litvinoval/cursach/РПЗ.docx

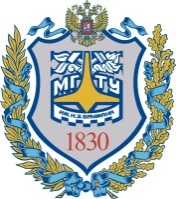
[picture p1: figure]
Gerb-BMSTU_01

| Министерство науки и высшего образования Российской Федерации Федеральное государственное бюджетное образовательное учреждение высшего образования «Московский государственный технический университет имени Н.Э. Баумана (национальный исследовательский университет)» (МГТУ им. Н.Э. Баумана)

ФАКУЛЬТЕТ ____________________________ ИУ ____________________________________

КАФЕДРА _______________________________ ИУ-2__________________________________

РАСЧЕТНО-ПОЯСНИТЕЛЬНАЯ ЗАПИСКА

К КУРСОВОМУ ПРОЕКТУ

НА ТЕМУ:

______________________________________________

______Двухосный индикаторный гиростабилизатор__ _______телекамеры для разведывательного БПЛА___

______________________________________________

______________________________________________

______________________________________________

Студент ____ИУ2-71___ _______________ Литвинов А.Д.___

(Группа) (Подпись, дата) (И.О.Фамилия)

Руководитель курсового проекта _________________ Фатеев В.В._

(Подпись, дата) (И.О.Фамилия)

Консультант _________________ Фатеев В.В. _

(Подпись, дата) (И.О.Фамилия)

2022 г.

# Введение

Гироскопическими стабилизаторами (ГС) называются гироскопические устройства, предназначенные для стабилизации приборов и устройств в инерциальном пространстве и управления их угловым положением. На гироскопические приборы и системы возлагаются сложные задачи по стабилизации и управлению специальными бортовыми приборами (приборы инерциальной навигации, антенны бортовых радиолокационных станций, чувствительные элементы пеленгаторов, координаторы цели, аэрофотоаппараты и др.).

Известно, что ось гироскопа в кардановом подвесе, установленного на борту летательного аппарата, в течение длительного времени сохраняет почти неизменное направление в пространстве. Однако несовершенство элементов конструкции и тяжелые условия эксплуатации порождают значительные моменты внешних сил, действующие на гироскоп и отклоняющие ось вращения его ротора, а следовательно и стабилизируемую ось от заданного направления в пространстве.

Требования высокой точности стабилизации приборов бортовых систем привели к необходимости создания гироскопических стабилизаторов.

## Классификация гиростабилизаторов

1. По типу применяемых гироскопов:

Гиростабилизаторы разделяются на ГС с двухстепенными гироскопами и ГС с трехстепенными гироскопами.

В свою очередь, ГС с двухстепенными гироскопами можно разделить по типу подвеса гироскопов: ГС с гироскопами на шарикоподшипниковом подвесе, на поплавковом, воздушном, магнитном подвесах и т.п. Гиростабилизаторы с трехстепенными гироскопами делятся на ГС с бескарданными гироскопами и ГС на базе гироскопов с кардановым подвесом.

2. По роли гироскопа в процессе стабилизации:

1) Силовые ГС. В этом типе ГС возмущающие моменты уравновешиваются гироскопическим моментом и моментом, создаваемым приводом разгрузки. Постоянные или медленно изменяющиеся моменты уравновешиваются в основном моментом привода разгрузки, быстро изменяющиеся, уравновешиваются гироскопическим моментом. Для силовых ГС требуются гироскопы с высоким кинетическим моментом.

2) Индикаторно-силовые ГС. В таких ГС силовая роль гироскопов снижена. Наличие у гироскопа большого кинетического момента не является обязательным.

3) Индикаторные ГС. Гироскопический момент практически не участвует в непосредственной компенсации возмущающих моментов, и их подавление определяется в основном приводом стабилизации, который должен выбираться из условия уравновешивания всех составляющих возмущающего момента.

3. По типу чувствительного элемента:

1) ГС на двухосных гироскопах.

2) ГС на трехосных гироскопах.

3) ГС на датчиках угловых скоростей.

4) ГС на датчиках угловых ускорений.

4. По количеству осей стабилизации:

1) Одноосные ГС. – стабилизируют приборы и устройства только относительно одной оси.

2) Двухосные ГС. – стабилизируют приборы и устройства относительно двух осей ( например, ГС, создающий горизонтальную площадку)

3) Трехосные ГС. – осуществляют стабилизацию относительно трех осей, т.е. полную стабилизацию. Такие ГС называются еще пространственными гиростабилизаторами или гиростабилизированными платформами.

5. По типу подвеса:

1) Корданов подвес

2) Плавающий подвес

3) На космических аппаратах роль подвеса может выполнять сам аппарат

6. По типу привода:

1) Электромеханические.

2) Пневматические.

3) Гидравлические.

4)Реактивные

## Назначение прибора

Разрабатываемый прибор предназначается для угловой стабилизации в инерциальном пространстве положения камеры беспилотного летательного аппарата (БПЛА), управления еѐ положением с помощью сигналов, получаемых с джойстика оператора, а также измерения углов отклонения и угловой скорости платформы. При этом должны быть обеспечены следующие параметры прибора:

установившаяся ошибка стабилизации не более 0,5 угловых минут

максимальная скорость управления – 10 °/с

максимальное угловое ускорение управления – 220 °/с^2

максимальный угол прокачки – 40 °

## Принцип работы

ГС состоит из платформы, с закрепленными на ней камерой и двумя ВОГ, которые помещены в двухосный наружный карданов подвес, а также системы стабилизации, устройства вывода информации потребителям и устройства управления положением объекта стабилизации. Принцип действия индикаторного стабилизатора на ВОГ основан на компенсации возмущающих моментов действующих на объект стабилизации (ОС) с помощью приводов стабилизации, моменты, которые они развивают компенсирует возмущающие. При повороте ОС на ,установленных на нѐм, ВОГ вырабатывается сигнал пропорциональный угловой скорости движения ОС. Этот сигнал после интегрирования и усиления подается на приводы стабилизации, которые вырабатывают момент, направленный в противоположную сторону поворота ОС. Управление положением ОС в инерциальном пространстве осуществляется сигналами с джойстика оператора, которые вычитаются из сигналов с ВОГ и также подаются на привод стабилизации. Сигналы с джойстика оператора пропорциональны отклонению джойстика.

## Вводимые обозначения

Датчик угла – ДУ

Датчик момента – ДМ

Волоконно-оптический гироскоп – ВОГ (ВГ)

Летательный аппарат – ЛА

# Описание конструкции ГС, ЧЭ, узлов

## Описание конструкции ГС

Конструкция двухосного индикаторного гиростабилизатора камеры БПЛА представляет собой закрепленную на полуосях камеру, выполняющую роль платформы, к которой крепятся чувствительные элементы. Полуоси закрепляются в шарикоподшипниковых опорах в рамке. Также на полуоси и рамку устанавливаются датчики момента для выработки момента стабилизации и датчики угла для выработки выходных сигналов об угловом положении камеры. Аналогично рама устанавливается на полуосях в шарикоподшипниковые опоры в корпусе.

## Узел ДМ

Датчики момента ДМ3, ДМ10 состоят из двух механически раздельных частей – статора и ротора. Статор представляет собой магнитопровод с установленными в нѐм постоянными магнитами и установленным сверху коллекторно-щеточным узлом. Статор, крепится винтами к корпусу. Также винтами крепится к статору коллекторнощеточный узел. Ротор ДМ представляет собой магнитопровод с обмоткой, на которую через щетки подается управляющий ток. Ротор устанавливается на полуось и поджимается гайкой.

## Узел ДУ

В качестве датчиков угла выбираются синусно-косинусные трансформаторы СКТ265 бескорпусного типа, которые представляют собой две раздельный механические части – ротор и статор. Ротор поджимается гайкой к полуоси, а статор к корпусу.

## Описание чувствительного элемента – ВГ091

ВГ091 является датчиком абсолютной угловой скорости. Принцип действия ВОГ основан на зависимости времени облета света замкнутого вращающегося контура от направления обхода (эффект Саньяка).

Кольцевой интерферометр конструктивно выполнен таким образом, что излучение от одного источника делится на две волны равной интенсивности I, которые распространяются в контуре в противоположных направлениях и интерферируют после его обхода. Сигнал интерференции в этом случае есть I(1+cos(F)), где F – разность фазовых набегов (сдвиг фаз) волн в контуре. При вращении создается сдвиг фаз (фаза Саньяка) между встречными волнами F=2πDLW/λc (D – диаметр катушки, L – длина волокна, W – скорость вращения вокруг нормали к плоскости контура (оси чувствительности).

Коэффициент пропорциональности между угловой скоростью и фазой Саньяка называется оптическим масштабным коэффициентом контура (К). Величина К определяет диапазон измеряемых угловых скоростей, который составляет 300 град/с

Минимальная измеряемая угловая скорость зависит от качества оптических компонентов (модуль, ответвитель, поляризатор). Ее отношение к максимальной измеряемой скорости представляет динамический диапазон ВОГ. Качество оптики проявляется в максимальном подавлении всех механизмов возникновения сдвига фаз в интерферометре, кроме как вследствие вращения. Оптическая архитектура ВГ091 обеспечивает оптимальную оптическую фильтрацию сигнала для уменьшения дрейфа и повышения помехоустойчивости. Для этого излучение проходит поляризационный фильтр и на ответвителе разделяется на два встречных луча волоконного контура. После обхода контура лучи смешиваются(интерферируют) на том же ответвителе и опять проходят поляризационный фильтр, обеспечивающий идентичность(взаимность) оптических путей встречных волн в контуре. Вторым ответвителем сигнал интерференции отводится на фотоприемное устройство, сигнал которого пропорционален мощности светового потока. Для повышения чувствительности используется пьезокерамический фазовый модулятор(ПЭТ). При питании его переменным напряжением создается дополнительный сдвиг фаз m(T)=M*sin(wt) за счет периодического растяжения участка волоконного контура.

При работе модулятора выходной сигнал может быть выражен в виде:

I(t,Ф,M)≈1+cos(Ф+Msin(wt))≈

≈J_1 (M)sin(Ф)sin(wt)+J_2 (M)sin(Ф)sin(2wt)+1+

+J_0 (M)cos(Ф)+QBcos(wt)

Где представлены основные составляющие сигнала ВОГ (Jn – функция Бесселя порядка n). Это – первая гармоника частоты модуляции, вторая гармоника, постоянная составляющая и сигнал квадратурной помехи (QB). Они зависят от амплитуды модуляции (М) и угловой скорости. Квадратурный сигнал (QB) также проявляется на частоте модуляции, однако он не зависит от вращения и сдвинут по фазе на 90˚ относительно сигнала вращения.

При вращении датчика появляется сигнал на первой гармонике, пропорциональный скорости вращения. Его величина зависит также от тока СЛД и напряжения ПЭТ. Выходное напряжение в диапазоне измеряемых скоростей (-Wmax...+Wmax) аппроксимируется соотношением:

U(W,t°)=SF∙W∙[1+s(t°)]∙[1-p∙(W/(W_(max)))^2 ]+B(t°)+N

SF – крутизна системы (коэффициент между скоростью и напряжением), B(t˚) – начальный сдвиг (зависит от температуры); N – случайная составляющая сигнала; s(t˚) – температурная составляющая крутизны; p – параметр нелинейности.

SF является произведением ОМК и коэффициента преобразования электронного блока (≈ 15 В/мрад). Нелинейность преобразования нарастает квадратично на границах диапазона измерений примерно до 10-15%. Она корректируется квадратичной аппроксимацией до уровня 0.3..1%. При малых скоростях вращения нелинейность пренебрежимо мала.

Волоконно-оптический контур изготовлен из одномодового оптического волокна, сохраняющего поляризацию излучения, и имеющего следующие технические характеристики: длина поляризационных биений 5 мм; диаметр кварцевой оболочки – 45 мм; диаметр волокна в полимерном покрытии – 150 мкм; длина волокна – 100 мм; диаметр намотки – 70 мм. Внешние по отношению к жиле слои волокна выполняются из легированного кварца для придания ему определенных оптических и механических свойств. Длина и диаметр намотки определяют ОМК датчика.

Фазовый модулятор (ПЭТ) представляет собой участок волоконного контура, намотанный на пьезокерамический (ЦТС-23) цилиндр диаметром 18 мм. Рабочая частота модуляции (резонансная) 73.,.83кГц, добротность не менее 150. Статическая емкость примерно 220пФ. Характеристики модулятора зависят от температуры. Так, активное сопротивление падает с температурой, а коэффициент преобразования (соотношение между индексом фазовой модуляции и напряжением ПЗТ) соответственно возрастает. ПЗТ является электромеханической колебательной системой. Кроме основного (радиального) типа колебаний в нем существуют и другие типы колебаний, резонансные частоты которых выше 350кГц.

Волоконный биконический ответвитель 2x2 является устройством, осуществляющим оптическую связь между волокнами. Он изготовлен таким образом, что излучение, распространяющееся в одном из волокон, равномерно и практически без потерь (менее О.ЗдБ) распределяется между двумя волокнами. Ответвители изготавливаются по сварной технологии непосредственно на концах контура, после чего распаиваются на кварцевых подложках для обеспечения вибро и термоустойчивости.

Волоконно-кристаллический поляризатор выполнен в виде биконического перехода (утончения) на участке волокна, заращенного анизотропным монокристаллом. Коэффициент экстинкции поляризатора (разность потерь волн с ортогональными поляризациями) более 30 дБ.

Излучательный модуль - это кристалл суперлюминесцентного светодиода (СЛД), оптически согласованный с волокном. Длина волны излучения 815...830нм, оптическая мощность в волокне более 50мкВт. СЛД обладет яркостью, сопоставимой с яркостью лазерного источника,, имея при этом низкую когерентность. Это последнее свойство используется в ВОГ для уменьшения начального сдвига и шума.

Все узлы и компоненты ВОГ смонтированы в корпусе, выполненном из алюминиевого сплава. Внутренняя полость ВОГ заполняется сухим азотом. Герметизация ВОГ осуществляется кремнийорганическим герметиком и механическим поджимом крышки и корпуса. Для ориентации ВОГ на объекте используется установочная поверхность (основание).

# Предварительный расчет инерционных характеристик ГС

Масса элементов внутренней оси:

m_(вн) =m_(ос) +m_(ВОГ) +m_(ДУ) +m_(ДМ) +m_(полуоси)

mОС=2 кг – масса объекта стабилизации

mВОГ=0,03 кг – масса чувствительного элемента (ВГ091)

mСКТ265 =0,144 кг – масса ДУ

mДМ10=0,350 кг – масса ДМ

mполуоси = 0,033 кг – масса полуоси

m_(вн) =2+2∙0.03+0.144+0.350+0.033=2.587 кг

Масса элементов наружной оси:

m_(нар) =m_(вн) +m_(рамы) +m_(ДУ) +m_(ДМ) +m_(полуоси)

m_(рамы) = 0.48 кг – масса рамы

mСКТ265 =0,144 кг – масса ДУ

mДМ3=0,42 кг – масса ДМ

m_(нар) =2.587+0.48+0.144+0.42+0.033=3.664 кг

Моменты инерции:

Моменты инерции объекта стабилизации:

I_x^(ос) =I_y^(ос) =230 сН∙см∙с^2

I_z^(ос) =240 сН∙см∙с^2

Моменты инерции ВОГ:

I_x^(ВОГ) =m_(ВОГ) ∙(Y_(цм1)^2 +Z_(цм2)^2 )+m_(ВОГ) ∙(Y_(цм2)^2 +Z_(цм2)^2 )

I_y^(ВОГ) =m_(ВОГ) ∙(X_(цм1)^2 +Z_(цм2)^2 )+m_(ВОГ) ∙(X_(цм2)^2 +Z_(цм2)^2 )

Здесь X_(цм1) ,Y_(цм1) , Z_(цм1) ,X_(цм2) , Y_(цм2) , Z_(цм2) - координаты центра масс ВОГов относительно центра подвеса.

X_(цм1) =25мм; Y_(цм1) =45мм; Z_(цм1) =63мм

X_(цм2) =25мм; Y_(цм2) =45мм; Z_(цм2) =63мм

Таким образом:

I_x^(ВОГ) =0.03∙(0.045^2 +0.063^2 )+0.03∙(0.045^2 +0.063^2 )=360∙10^(-6) Н∙м=3.6 сН∙см∙с^2

I_y^(ВОГ) =0.03∙(0.025^2 +0.063^2 )+0.03∙(0.025^2 +0.063^2 )=275∙10^(-6) Н∙м=2.75 сН∙см∙с^2

Моменты инерции ДУ и ДМ:

I_x^(ДУ,ДМ) = 41 сН∙см∙с^2

I_y^(ДУ,ДМ) = 14 сН∙см∙с^2

I_z^(ДУ,ДМ) = 41 сН∙см∙с^2

Моменты инерции полуосей:

I_(xр)^(полуосей) = 3.2 сН∙см∙с^2

I_(yр)^(полуосей) = 7.2 сН∙см∙с^2
I_(zр)^(полуосей) = 1 0 сН∙см∙с^2

I_(yп)^(полуосей) = 0.41 сН∙см∙с^2

Моменты инерции рамы:

I_x^(рамы) =16 сН∙см∙с^2

I_y^(рамы) =16 сН∙см∙с^2

I_z^(рамы) =29 сН∙см∙с^2

Суммарные моменты инерции:

I_x^р =I_(xр)^(полуосей) +I_x^(рамы) +I_x^(ДУ,ДМ) = 60.2 сН∙см∙с^2

I_y^р =I_(yр)^(полуосей) +I_y^(рамы) +I_y^(ДУ,ДМ) = 37.5 сН∙см∙с^2

I_z^р =I_(zр)^(полуосей) +I_z^(рамы) +I_z^(ДУ,ДМ) = 80 сН∙см∙с^2

I_y^п =I_y^(ОС) +I_y^(ВОГ) +I_(yп)^(полуосей) =233 сН∙см∙с^2

# Расчет вредных моментов

## 1. Моменты трения.

При движении ЛА на подшипники осей карданова подвеса гиростабилизатора действуют как осевая, так и радиальная нагрузки. Для такой смешанной нагрузки величина момента трения радиальных подшипников

где M0 - момент трения ненагруженного шарикоподшипника, (определяется типоразмером подшипника); А — осевая нагрузка, г; R - радиальная нагрузка, г; k — коэффициент трения качения, изменяющийся в пределах от 0,005 до 0,001 см; D0 — диаметр центров шариков, см; dm — диаметр шарика, см.

Моменты трения радиальных подшипников с внутренним диаметром от 5 до 12 мм, широко применяющихся в приборостроении при совместном действии радиальных и осевых нагрузок, более точно определяются по следующим эмпирическим соотношениям:

при г;

при г.

Таблица 1.

Диаметр | М0, г*см | | k1 | , см | k2 | , см | k3 , см
оси, мм | однорядные | двухрядные | однорядные | двухрядные | однорядные | Двухрядные
5 | - | 8,9 | 0,0156 | 0,0163 | 0,0016 | 0,0075 | 0,005
6 | - | 7,8 | 0,0099 | 0,0110 | 0,0013 | 0,0022 | 0,005
7 | 5,6 | 7,0 | 0,0094 | 0,0104 | 0,0018 | 0,0026 | 0,006
8 | - | 7,0 | 0,0091 | 0,0095 | 0,0023 | 0,0035 | 0,006
10 | 7,2 | 9,2 | 0,0069 | 0,0088 | 0,0035 | 0,0052 | 0,008
12 | 10,8 | 14,1 | 0,0124 | 0,0160 | 0,0050 | 0,0092 | 0,010

Рабочие перегрузки, действующие на ЛА по осям:

Ускорения, действующие по осям ЛА:

Определим радиальные и осевые нагрузки, возникающие в подшипниках, при совместном действии перегрузок на ЛА.

Определим проекции линейных ускорений, действующих на ЛА, на оси, связанные с рамкой (Ox’y’z’), и на оси, связанные с платформой (Oxyz).

Учитывая, что гиростабилизатор поворачивается по оси курса рамки на угол α, получим следующие выражения для проекций на оси Ox’y’z’:

Учитывая, что гиростабилизатор поворачивается по оси тангажа платформы на угол β, получим следующие выражения для проекций на оси Oxyz:

где α=(-40…40)°- определяется углом прокачки,

β=(-40…40)°- определяется углом прокачки,

Причем

Максимальные значения осевых нагрузок будут достигаться при

α=β=0°

Осевая нагрузка на подшипники платформы:

A_п =m_п ∙W_y
A_п =m_п ∙W_y =100∙2587∙3.8∙9.8∙10^(-3) =9634 сН

где m_п - масса платформы

Радиальная нагрузка на подшипники платформы:

R_п =(m_п)/2∙√((W_x ∙g)^2 +(W_z ∙g)^2)=(2587∙100)/2∙√((3.8∙9.8)^2 +(3.8∙9.8)^2)∙10^(-3) =6812 сН

где m_п - масса платформы

Осевая нагрузка на подшипники наружной рамы:

A_н =m_н ∙W_x
A_н =m_н ∙W_x =100∙3664∙3.8∙9.8∙10^(-3) =13645 сН

где m_н -масса н аружной рамы

Радиальная нагрузка на подшипники наружной рамы:

R_н =(m_п)/2∙√((W_y ∙g)^2 +(W_z ∙g)^2)=(3664∙100)/2∙√((3.8∙9.8)^2 +(3.8∙9.8)^2)∙10^(-3) =9648 сН

R_Н =0.5∙3664∙3.8∙√2∙9.8=8990 сН

где P_п - вес платформы , P_п -вес н аружной рамы

Моменты трения для однорядных шарикоподшипников диаметром 10мм:

М_(тр.ш.) =М_0 +500(k_1 -k_2 )+k_2 R+k_3 А

Момент трения подшипников платформы:

М_(тр.ш./п)^y =7.2+500(0.0069-0.0035)+0.0035∙6812 +0.008∙9634 ;

М_(тр.ш./п)^y =109.8 cН∙см .

Момент трения подшипников рамы:

М_(тр.ш./р)^x =7.2+500(0.0069-0.0035)+0.0035∙9648 +0.008∙13645 ;

М_(тр.ш./р)^x =151.8 сН∙см .

Учтя коэффициент запаса по моменту, который равен 1.5, получим

М_(тр.ш./п)^y =164.7 сН∙см;

М_(тр.ш./р)^x =227.7 сН∙см .

## 2. Моменты тяжения токоподводов.

Современные гиростабилизаторы являются сложными электромеханическими устройствами, следовательно, для обеспечения функционирования как самих стабилизаторов, так и стабилизируемых приборов, устанавливаемых на платформе, требуется передача большого количества электрических сигналов. Для этого используются токоподводы на каждой оси стабилизации. Количество необходимых токоподводов достигает нескольких десятков, причем передаваемые по ним токи лежат в пределах от долей миллиампера, до десятков ампер (в цепи питания гиромотора). Конструкцией токоподводов должна быть обеспечена высокая надежность передачи сигналов через них в условиях жестких эксплуатационных воздействий (линейные ускорения и вибрации) и при больших углах поворота карданова подвеса. При выборе типа токоподводов для гиростабилизаторов величины моментов, создаваемых токоподводами, не играют, в отличие от других гироскопических приборов, определяющей роли. Применяются два типа токоподводов: многоконтактные коллекторные и различные виды гибких проводников. Коллекторные токоподводы применяют тогда, когда необходимо получать в стабилизаторе малые величины моментов трения, практически не зависящие от углов поворота рам карданова подвеса и эксплуатационных условий. Токоподводы с гибкими проводниками обеспечивают высокую надежность работы. Габариты токоподводящего узла при большом количестве токоподводящих проводников малы. Момент, создаваемый такими токоподводами, пропорционален углам поворота рам карданова подвеса и при правильном выборе типа проводников и конструкции токоподвода является относительно небольшим. Уменьшение момента, а также обеспечение работы стабилизатора при неограниченном угле поворота платформы вокруг осей карданова подвеса можно получить с помощью следящей системы, разворачивающей часть токоподводов, расположенную на корпусе, вслед за поворотом части токоподводов, закрепленной на подвижной системе. Применяются три конструктивных типа гибких токоподводов: 1) жгуты проводников, расположенных вдоль оси вращения (для каждой из осей карданова подвеса свой жгут). Для получения малых упругих моментов проводники имеют запас по длине, обеспечивающий их свободное скручивание; 2) свободный жгут проводников, который может изгибаться во всех направлениях при поворотах платформы карданова подвеса и имеет соответствующий запас по длине; 3) барабан со спирально уложенными рядами проводников, которые при поворотах скручиваются или раскручиваются. Для уменьшения габаритов и упрощения конструкции применяют специальные многожильные ленточные провода. Так же как и в первой конструкции, обеспечивается поворот только вокруг одной оси.

При изгибе и скручивании проводников возникают как упругие моменты, так и моменты трения из-за взаимного перемещения проводников в жгуте.

При соответствующем выборе материалов изоляции проводов моменты трения удается уменьшить до величины, пренебрежимо малой по сравнению с моментами трения в опорах карданова подвеса. Для уменьшения упругих моментов применяют провода малого сечения.

Так как величина моментов сопротивления всех приведенных типов гибких токоподводов существенно зависит от конструкции токоподводов и технологии их изготовления, то моменты сопротивления обычно определяют по данным испытаний макетов узлов токоподводов или по экспериментальным данным для приборов-аналогов.

Удельный момент упругих токоподводов по опытным данным определяются по формуле:

, k=5…8 г·см²/рад.

где M_(ТП) - момент тяжения токоподводов

Выберем значения следующих величин:

kт.п. = 6,5 г·см²/рад – эмпирический коэффициент для токоподводов первого типа (провод МГТФ-0.07),

lβ=40 мм, lα=60 мм – длина токоподводов между местами заделки проводников по осям тангажа и курса соответственно,

Nβ=29, Nα=38 – количество токоподводов.

Следовательно, удельные моменты будут равны:

Удельный момент платформы:

Удельный момент рамы:

При углах отклонения платформы α=40° и β=40° моменты тяжения токоподводов:

Момент тяжения токоподводов платформы:

Момент тяжения токоподводов рамы:

## 3. Моменты при ускоренном движении ЛА при наличии смещения центра масс.

При линейных перегрузках неточность балансировки наряду с моментом трения в опорах создает значительную часть возмущающих моментов, уравновешиваемых системой. При расчетах возмущающих моментов определяют максимальную величину моментов от остаточной несбалансированности.

Момент несбалансированности определяется моментом трения на неподвижном основании, умноженным на максимальную перегрузку, испытываемую прибором.

Определим радиальные нагрузки при отсутствии перегрузок.

Радиальные нагрузки на подшипники платформы:

R_(0п) =m_п ∙g/2=100∙2587∙9.81/2∙10^(-3) =1268 cН;

где m_п - масса платформы;

Радиальные нагрузки на подшипники наружной рамы:

R_(0н) =m_н ∙g/2=100∙3664∙9.81/2∙10^(-3) =1797 cН;

где m_н - масса наружной рамы;

Определим М^(НБ ост) на неподвижном основании:

М^(НБ ост) = M_0 + k_3 ∙R_0 , М^(НБ ост) - момент остаточной несбалансированности;

Момент остаточной несбалансированности по оси платформы:

М_п^(НБ ост) = M_0 + k_3 ∙R_(0п) =7.2+0.008∙1180.6=17.4 сН∙см

Момент остаточной несбалансированности по оси наружной рамы:

М_н^(НБ ост) = M_0 + k_3 ∙R_(0н) =7.2+0.008∙1674.6=21.6 сН∙см

Величины максимальных моментов от остаточной несбалансированности относительно осей карданова подвеса будут равны:

М_п^(НБ) =М_п^(НБ ост) ∙(n_x +n_z )= 17.4∙(3.8+3.8)=131.9 сН∙см

М_н^(НБ) =М_н^(НБ ост) ∙(n_y +n_z )= 21.6∙(3.8+3.8)=164 сН∙см

где n_x ,n_y ,n_z - максимальные перегрузки, действующие на прибор

## 4. Моменты, обусловленные неравножесткостью конструкции карданова подвеса.

Карданов подвес стабилизатора состоит из упругих элементов (рам, цапф, подшипников), при деформации которых появляются силы внутреннего трения. Под влиянием сил инерции, возникающих при движении основания (ЛА) с ускорением, происходят упругие деформации элементов карданова подвеса и относительные перемещения его элементов. Направления перемещений из-за различия жесткости элементов в разных направлениях обычно не совпадают с линией действия сил инерции, вследствие чего возникают моменты вокруг осей карданова подвеса гиростабилизатора. При вибрации основания, на котором установлен гиростабилизатор, на величину отклонения элементов его конструкции, т. е. на амплитуду вынужденных колебаний, влияют силы внутреннего трения в элементах карданова подвеса, демпфирующие их колебания. Если при разработке гиростабилизаторов применяются специальные меры по обеспечению требуемой жесткости рам карданова подвеса, то величина упругости карданова подвеса определяется в значительной мере упругостью подшипников подвеса. Поэтому при расчете гиростабилизаторов принимают упрощенную кинематическую схему карданова подвеса, в которой предполагают, что элементами, определяющими упругие деформации карданова подвеса, являются цапфы и подшипники, т. е. вместо схем с распределенными упругостями рассматривается схема с упругостью, сосредоточенной в опорах карданова подвеса.

Значения жесткостей радиальной и продольной жесткостей, по указанию преподавателя, определяются соотношением:

1/(C_a)-1/(C_r)=0.2∙10^(-6) Н∙м= 0.2∙10^(-2) сН∙см

Где C_r - радиальная жесткость, C_a -продольная жесткость

Тогда моменты от неравножесткости будут вычисляться по формулам:

Момент неравножесткости платформы:

M_y^(нж) =P_п^2 ∙n_y n_z ∙(1/(C_α)-1/(C_r))=2.587∙3.8∙3.8∙0.2∙10^(-6) ∙10^4 =18.6 cНсм

где
P_п -вес платформы, n_y ,n_z -ускорения ЛА по осям y и z соответственно

Момент неравножесткости наружной рамы:

M_x^(нж) =P_y^2 ∙n_y n_z ∙(1/(C_α)-1/(C_r))=3.664∙3.8∙3.8∙0.2∙10^(-6) ∙10^4 =26.3 cНсм

где
P_н -вес наружной рамки, n_x ,n_z -ускорения ЛА по осям y и z соответственно

## 5. Инерционные моменты рам карданова подвеса.

Двухосный гиростабилизатор стабилизирует в пространстве ось OzП , связанную с платформой. При угловых движениях основания в двухосном гиростабилизаторе вследствие особенности кинематики КП наружная и внутренняя рамы поворачиваются вокруг стабилизированной оси с переменной угловой скоростью даже при постоянной угловой скорости поворота основания. Движение с переменной угловой скоростью есть движение с некоторым ускорением, которое вызывает инерционный момент, действующий вокруг оси наружной рамы КП.

Если в силовых гиростабилизаторах моменты внешних сил, изменяющихся с высокой частотой, уравновешиваются как системой разгрузки, так и гироскопическим и инерционным моментами, то в индикаторных стабилизаторах компенсация знакопеременных моментов внешних сил, также как и постоянных, полностью должна быть обеспечена системой разгрузки. Поэтому знание инерционных моментов при проектировании индикаторных стабилизаторов необходимо.

Выражение для инерционного момента вокруг оси внешней рамы двухосного гиростабилизатора:

M_(ин) =(I_x^р +I_y^п )∙ε_z +(I_z^р -I_y^р -(I_x^р)/(cosα)-I_y^п ∙tg^2 α)∙ω_z ∙ω_y ;

I_x^р - момент инерции рамки вокруг оси x

I_y^р - момент инерции рамки вокруг оси y

I_z^р - момент инерции рамки вокруг оси z

I_y^п - момент инерции платформы вокруг оси y

ε_z -максимальное угловое ускорение ЛА вокруг оси z

ω_y -максимальная угловая скорость ЛА вокруг оси y

ω_z -максимальная угловая скорость ЛА вокруг оси z

α- угол прокачки

M_(ин) =(60.2+233)∙230/180∙π+

+(80-37.5-60.2/(cos40°)-233∙tg^2 40°)∙50/180∙π^2 ∙50/180= 1387 сНсм

При колебаниях основания с малой амплитудой вокруг оси X_c по закону γ=γ_0 sin ωt углы α и β отклонения рамы карданова подвеса и платформы в первом приближении можно считать постоянными. Получаем суммарный инерционный момент с учетом угловой качки:

М_(качки)^(ИН) =(I_x^р +I_y^п )∙(γ_0 ∙π/180)∙(2πf)^2 tan(α) ;

где:

I_x^р - момент инерции рамки вокруг оси x

I_y^п - момент инерции платформы вокруг оси y

γ_0 -амплитудное значение угловой качки

α- угол прокачки

f- частота изменения значения угловой качки

M^(ИН) =( 60.2 + 233)∙(2.8∙π/180)∙ (2∙π∙2.3)^2 ∙tan(40°)= 2510 сНсм

Наибольший момент получился от качки, берем его.

## 6.Момент управления

Максимальное угловое ускорение управления ε_(yпр) = 3.84 рад/c.Поэтому для обеспечения этого момента, во внешних моментах будет еще одна составляющая.

M_(упр)^y =I_y^п ∙ε_(yпр) =233∙3.84=894.7 сН∙см

M_(упр)^x =(I_x^р +I_y^п )∙ε_(yпр) =(60.2+233)∙3.84=1125.8 сН∙см

# Расчет суммарного возмущающего момента и выбор двигателя стабилизации

По внутренней оси:

M_Σ^(ВН) =M_(вн)^(НЖ) +M_(вн)^(НБ) +M_(вн)^(ТП) +M_(вн)^(ТР) +M_(упр)^y

= 18.56+ 131.9 +33+ 164.7 +894.7 = 1243 сНсм

По наружной оси:

M_Σ^(НАР) =M_(вн)^(ИН) +M_(вн)^(НЖ) +M_(вн)^(НБ) +M_(вн)^(ТП) +M_(вн)^(ТР) +M_(упр)^x

= 2510 +26.3+ 164 +28.9+227.7+ 1125.8 =4082.7 сНсм

Данным значениям моментов удовлетворяет коллекторные моментные двигатели постоянного тока бескорпусного исполнения:

По оси платформы:

Двигатель | Крутизна, сH·см/А | Imax, A | Iном, А | Вес, г | Mпуск, сНсм
ДМ-10 | 2600 | 1.5 | 0.6 | 350 | 3900

По оси рамы:

Двигатель | Крутизна, сH·см/А | Imax, A | Iном, А | Вес, г | Mпуск, сНсм
ДМ-3 | 3700 | 1.6 | 0.6 | 420 | 5920

## Момент обкатки

Коэффициент демпфирования двигателя: D=(M_(пуск))/(ω_(хх))

M_(пуск) =I_(макс) ∙K_(ДМ)

Где I_(макс) – Максимальный пусковой ток,

K_(ДМ) – крутизна ДМ

M_(пуск)^x =1.6∙3700=5920сН∙см

M_(пуск)^y =1.5∙2600=3900 сН∙см

D_x =(M_(пуск)^x)/(ω_(хх))=5920/((1000/60)∙2∙π)=56.5 сН∙см∙с

D_y =(M_(пуск)^y)/(ω_(хх))=3900/((1000/60)∙2∙π)=37.2 сН∙см∙с

Угловая скорость управления: ω_(упр) =10°/c;

Угловая скорость объекта, на котором установлен прибор: ω_(осн) =50 °/c

Момент обкатки равен:

M_(обк)^x =D_x ∙(ω_(упр) +ω_(осн)) =56.5∙(10+50)/57.3=59.16 сН∙см

M_(обк)^y =D_y ∙(ω_(упр) +ω_(осн)) =37.2∙(10+50)/57.3=38.95 сН∙см

## Момент сухого трения

По оси рамы возьмем момент сухого трения из паспортных характеристик ДМ-3

M_(сух тр.)^x =70 сН∙см

По оси рамы возьмем момент сухого трения из паспортных характеристик ДМ-10

M_(сух тр.)^y =220 сН∙см

## Суммарный возмущающий момент

В реальных условиях эксплуатации маловероятна ситуация, при которой все возмущающие моменты действуют одновременно и достигают своих максимальных значений. Однако при проверке правильности выбора двигателя необходимо считать суммарный внешний момент как сумму максимальных значений всех возмущающих моментов.

По внутренней оси:

M_Σ^(ВН) =M_(вн)^(НЖ) +M_(вн)^(НБ) +M_(вн)^(ТП) +M_(вн)^(ТР) +M_(упр)^y +M_(обк)^y +M_(сух тр.)^y

M_Σ^(ВН) = 16.07+ 126.16 +33+ 154.2+894.7+38.95 +220 =

= 1483 сНсм <M_(пуск)^y

По наружной оси:

M_Σ^(НАР) =M_(вн)^(ИН) +M_(вн)^(НЖ) +M_(вн)^(НБ) +M_(вн)^(ТП) +M_(вн)^(ТР) +M_(упр)^x +M_(обк)^x +M_(сух тр.)^x

M_Σ^(НАР) = 2510+26.2+ 164 +28.9+227.7+ 1125.8 + 59.16 +70 =

= 4211.76 сНсм <M_(пуск)^x

Следовательно, ДМ-10 подходит для установки по внутренней оси (Oy).

ДМ-3 подходит для установки по наружной оси (Ox).

Математическая модель каналов ГС

Математические уравнения такой системы по наружной и внутренней оси в форме Лапласа имеют следующий вид:

J_x S^2 β+D_(нар)^(пр) Sβ+K_(нар)^с β=M_x^в

J_y S^2 α+D_(вн) Sα+K_(вн)^с α=M_y^в

где J_x^(нар) , J_y^(вн) - суммарные приведенные моменты инерции по наружной и внутренней осям

D_(нар)^(пр) , D_(вн) - приведенные моменты инерции по наружной и внутренней осям

K_(нар)^с ,K_(вн)^с - коэффициенты усиления обратной связи каналов стабилизации по наружной оси и внутренней рамы

M_x^в , M_y^в - суммарные возмущающие моменты

Структурные схемы каналов стабилизации для такой системы имеют вид:

Канал внутренней оси:

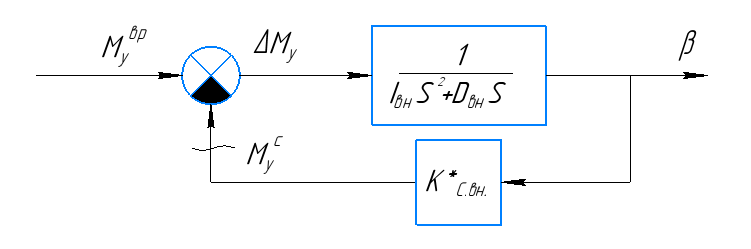
[picture p2: figure]

Канал наружной оси:

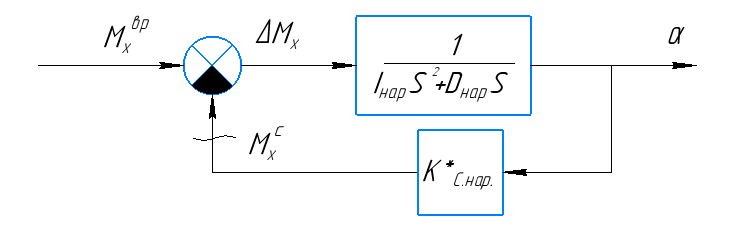
[picture p3: figure]

Рассчитаем параметры входящие в структурную схему.

Исходные данные для расчета: угловая погрешность стабилизации

∆β=∆α<0.5^(') =1.454∙10^(-4) рад

Коэффициент усиления обратной связи:

K_(вн)^с =(M_Σ^(вн))/(∆β)=1483/(1.454∙10^(-4))=10^7 (сН∙см)/(рад)

K_(нар)^с =(M_Σ^(нар))/(∆α)=4211.76/(1.454∙10^(-4))=2.9∙10^7 (сН∙см)/(рад)

Возьмем запас по коэффициенту усиления n_ε =1.2

K_(с вн)^(*) =K_(вн)^с ∙n_ε =10^7 ∙1.2=1.2∙10^7 (сН∙см)/(рад)

K_(с нар)^(*) =K_(нар)^с ∙n_ε =2.9∙10^7 ∙1.2=3.48∙10^7 (сН∙см)/(рад)

Постоянные времени:

T_(п вн) = (J_y^(вн))/(D_(вн))=233/37.2=6.26 с

T_(п нар) = (J_x^(нар))/(D_(нар)^(пр))=293.2/56.5=4.12 с

Добротности по скорости:

K_(вн)^v =(K_(с вн)^(*))/(D_(вн))=(1.2∙10^7)/37.2=3225801/с

K_(нар)^v =(K_(с нар)^(*))/(D_(нар)^(пр))=(3.48∙10^7)/56.5=6159291/с

Исследование устойчивости ГС

Исследование устойчивости произведем по критерию Найквиста с использованием логарифмических амплитудночастотных и фазочастотных характеристик (ЛАФЧХ) разомкнутой системы.

По каналу внутренней оси

Передаточная функция разомкнутой системы имеет вид:

W(S)=(K_(с вн)^(*))/(D_(вн) S)∙1/(T_(п вн) S+1)=(1.2∙10^7)/(37.2∙S)∙1/(6.26 S+1)

ЛАФЧХ такой системы имеет вид:

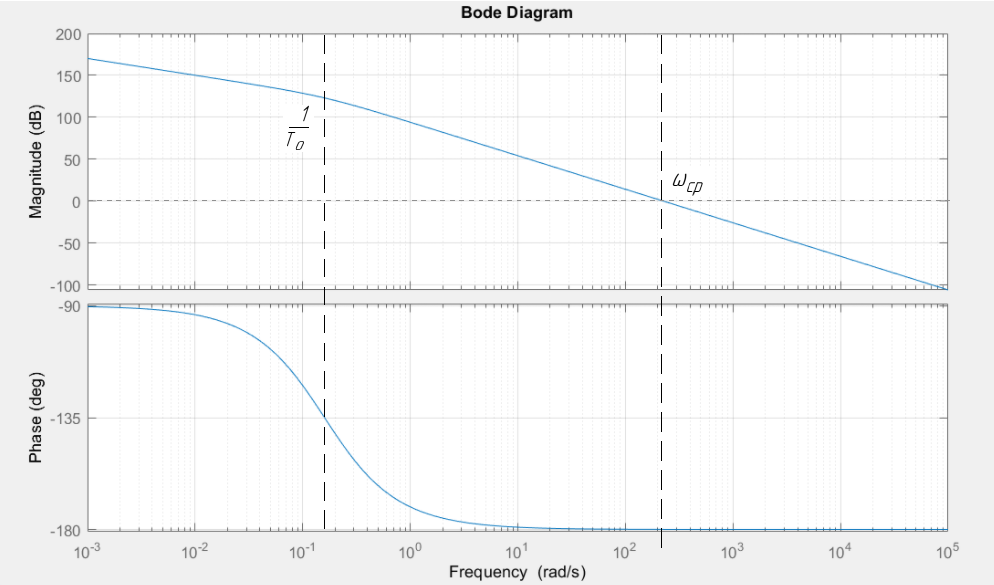
[picture p4: figure]

ЛФЧХ не пересекает уровень -180°, а лишь стремится к нему. Запас по фазе в данном случае стремится к нулю ( ∆φ →0 ) , а запас по амплитуде, напротив, стремится к бесконечности ( ∆L →0 ). В целом это говорит о том, что система находится на границе устойчивости и требует коррекции. Это можно подтвердить экспериментально построив график переходного процесса средствами компьютерного моделирования.

Переходной процесс нескорректированной системы:

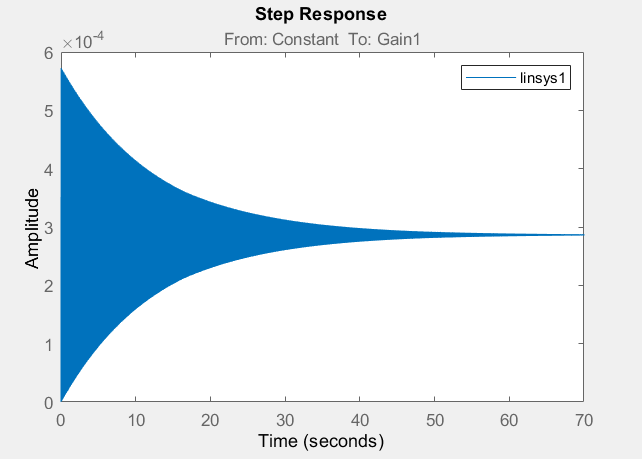
[picture p5: figure]

Чтобы увеличить запас по фазе, необходимо ввести корректирующее дифференцирующее звено W_(дифф) (S)=T_(1вн) S+1 . Если правильно выбрать постоянные времен T_(1вн) и T_(вн2) , мы обеспечим необходимый запас устойчивости и, тогда на частоте среза ЛАЧХ будет пересекать ось 0 дБ под наклоном –20 дБ/дек. Введением апериодического звена W_(апер) (S)= 1/(T_(2вн) S+1) на несколько большей частоте вернем систему в исходное состояние. Также для подавления возникающих в контуре обратной связи высокочастотных помех введем ещѐ одно апериодическое звено W_(пп) (S)= 1/(T_(3вн) S+1) .

Постоянные времени корректирующего звена:

T_(1вн) =0.0065с; T_(2вн) =0.00065 с;T_(3вн) =0.000065 с.

Передаточная функция такого корректирующего звена будет иметь вид:
W_(кор.вн.) (S)=(T_(1 вн) S+1)/(T_(2 вн) S+1)∙1/(T_(3 вн) S+1)=(0.0065S+1)/(0.00065S+1)∙1/(0.000065 S+1)

Структурная схема канала с введенной коррекцией:

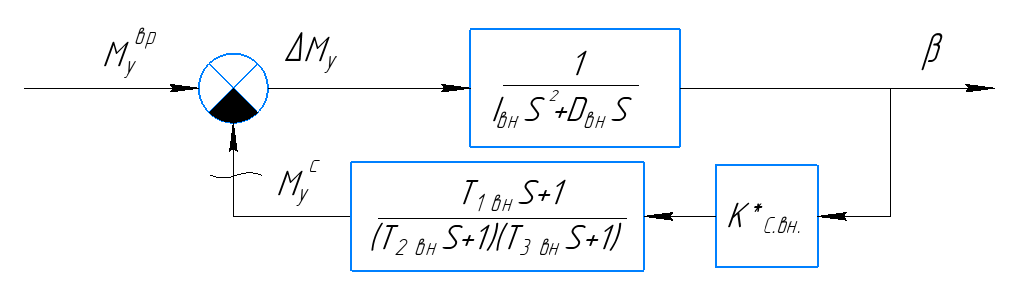
[picture p6: figure]

Передаточная функция разомкнутой скорректированной системы:

W_(скор.) (S)=(K_(с вн)^(*))/(D_(вн) S)∙1/(T_(п вн) S+1)∙(T_(1 вн) S+1)/(T_(2 вн) S+1)∙1/(T_(3 вн) S+1)

W_(скор.) (S)=(1.2∙10^7)/(37.2∙S)∙1/(6.26 S+1)∙(0.0065S+1)/(0.00065S+1)∙1/(0.000065 S+1)

ЛАФЧХ скорректированной системы имеет вид:

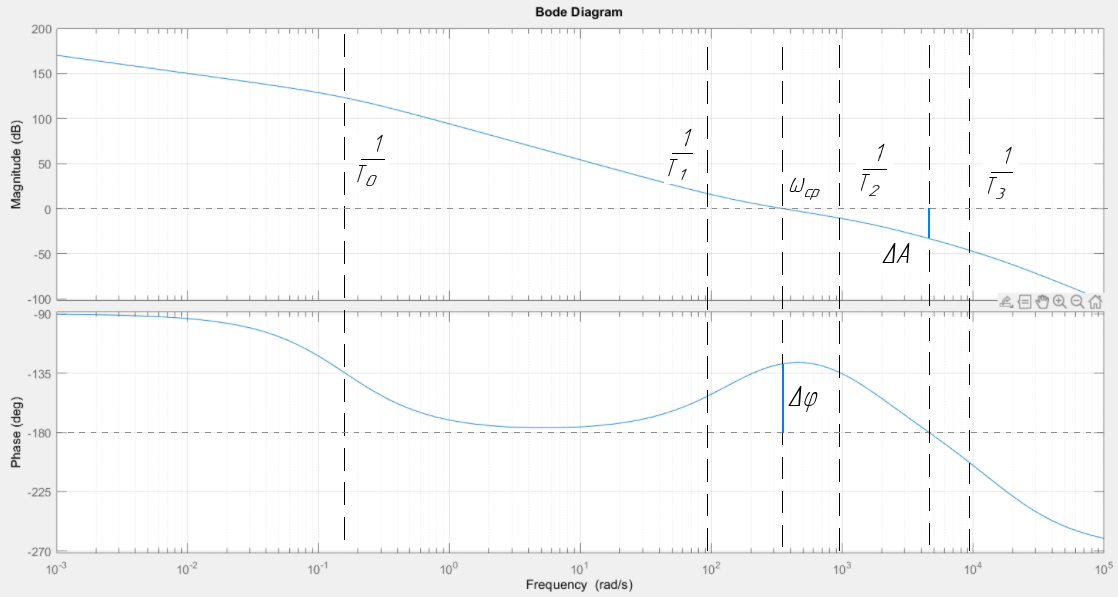
[picture p7: figure]

В результате корректировки получены следующие запасы:

1. По фазе ∆φ=53°
2. По амплитуде ∆L=33 дБ

Частота среза:

ω_(ср) =39.8 Гц

Переходный процесс скорректированной системы:

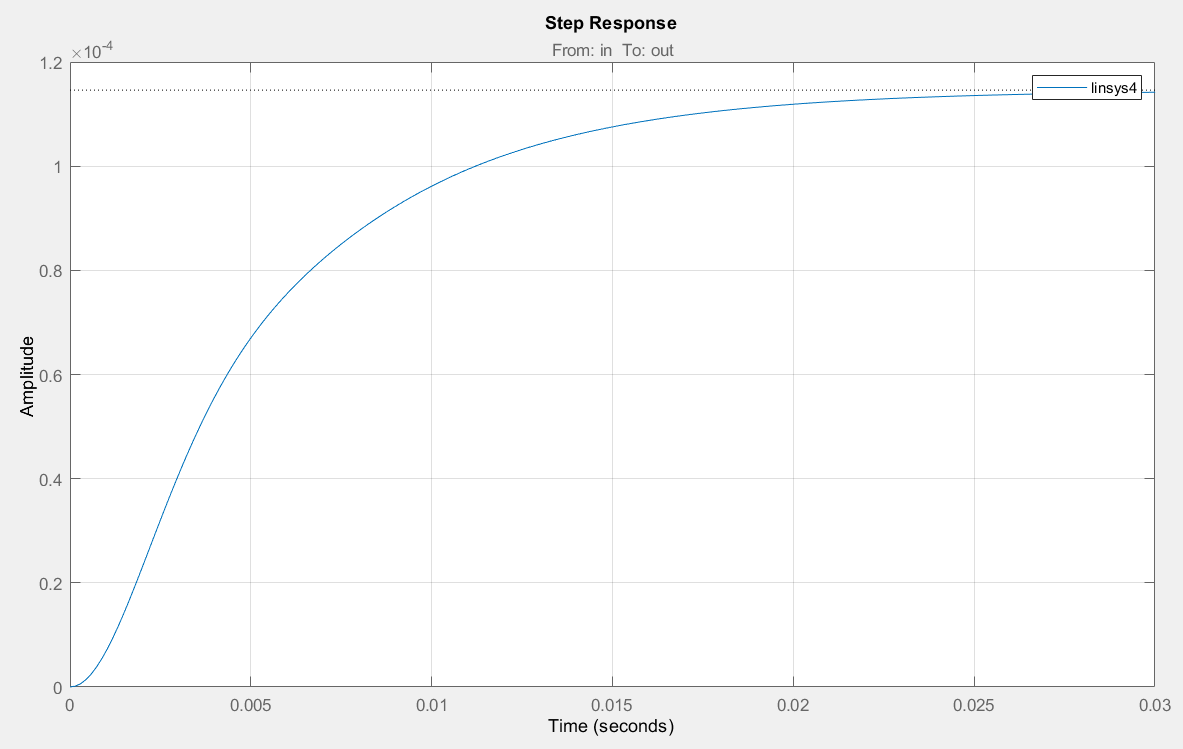
[picture p8: figure]

Переходной процесс устойчив. Время пп t_(п_вн) =0.02с .

По результатам эксперимента можно сделать вывод, что корректировка достигла своей цели.

Поскольку при построении переходного процесса на вход системы подавалось ступенчатое воздействие по величине равное суммарному возмущающему моменту, установившееся значение будет равно ошибке стабилизации.

Таким образом, полученная ошибка стабилизации по внутренней оси:

β_(уст) =0.000116 рад=0.41'<∆β

Так как установившееся значение ошибки меньше заданной по ТЗ, можно утверждать, что требования ТЗ по точности выполнены.

По каналу наружной оси

Передаточная функция разомкнутой системы имеет вид:

W(S)=(K_(с нар)^(*))/(D_(нар) S)∙1/(T_(п нар) S+1)=(3.48∙10^7)/(56.5∙S)∙1/(4.12 S+1)

ЛАФЧХ такой системы имеет вид:

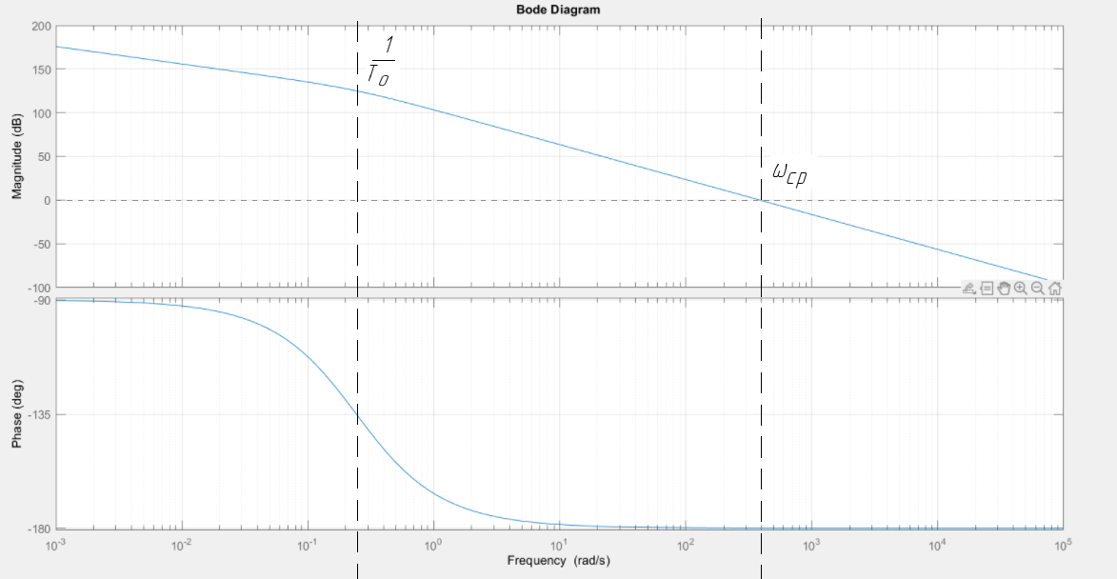
[picture p9: figure]

ЛФЧХ не пересекает уровень -180°, а лишь стремится к нему. Запас по фазе в данном случае стремится к нулю ( ∆φ →0 ) , а запас по амплитуде, напротив, стремится к бесконечности ( ∆L →0 ). В целом это говорит о том, что система находится на границе устойчивости и требует коррекции. Это можно подтвердить экспериментально построив график переходного процесса средствами компьютерного моделирования.

Переходной процесс нескорректированной системы:

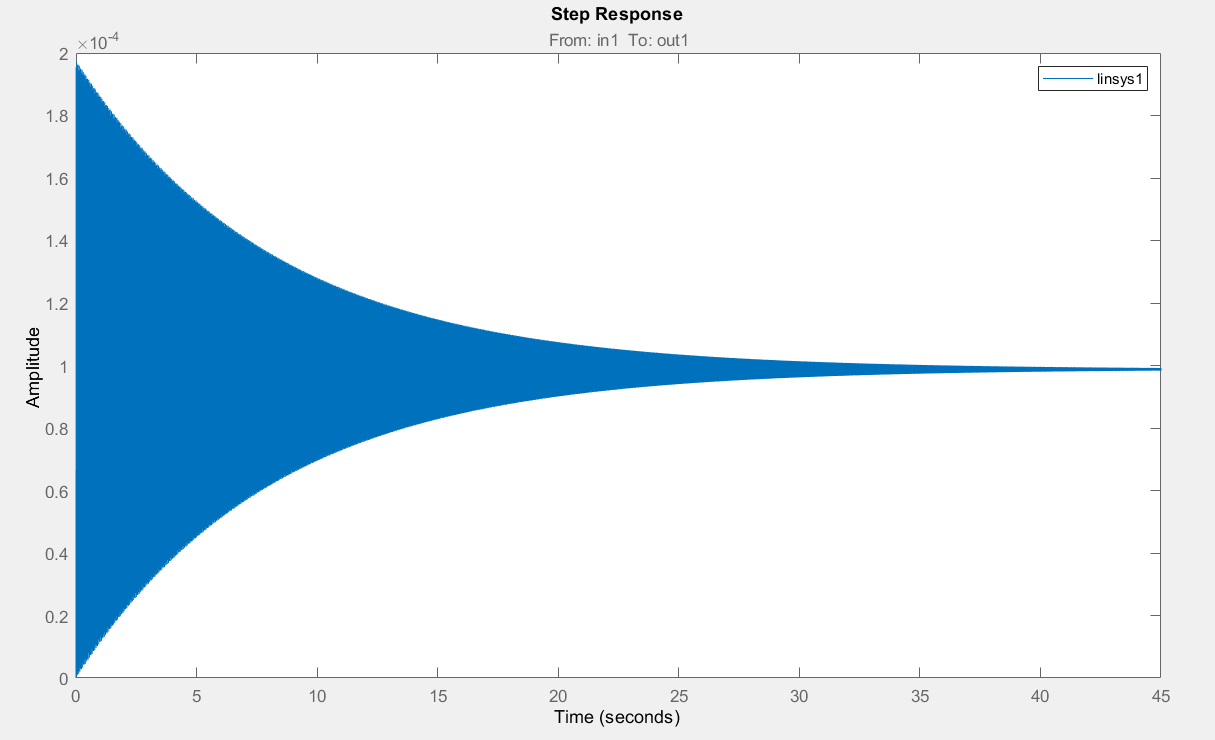
[picture p10: figure]

Чтобы увеличить запас по фазе, необходимо ввести корректирующее дифференцирующее звено W_(дифф) (S)=T_(1нар) S+1 . Если правильно выбрать постоянные времен T_(1нар) и T_(2нар) , мы обеспечим необходимый запас устойчивости и, тогда на частоте среза ЛАЧХ будет пересекать ось 0 дБ под наклоном –20 дБ/дек. Введением апериодического звена W_(апер) (S)= 1/(T_(2нар) S+1) на несколько большей частоте вернем систему в исходное состояние. Также для подавления возникающих в контуре обратной связи высокочастотных помех введем ещѐ одно апериодическое звено W_(пп) (S)= 1/(T_(3нар) S+1) .

Постоянные времени корректирующего звена:

T_(1нар) =0.004 с; T_(2нар) =0.0004 с;T_(3нар) =0.00004с.

Передаточная функция такого корректирующего звена будет иметь вид:
W_(кор.вн.) (S)=(T_(1 нар) S+1)/(T_(2 нар) S+1)∙1/(T_(3 нар) S+1)=(0.004S+1)/(0.0004S+1)∙1/(0.00004S+1)

Структурная схема канала с введенной коррекцией:

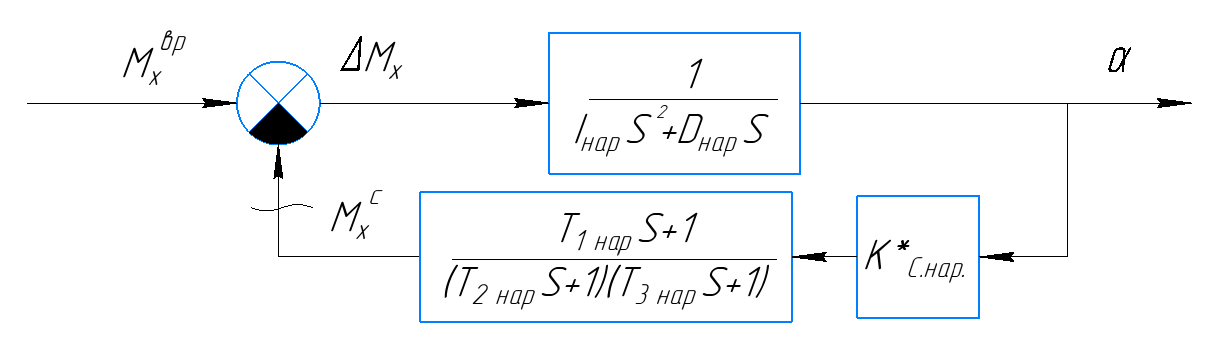
[picture p11: figure]

Передаточная функция разомкнутой скорректированной системы:

W_(скор.) (S)=(K_(с нар)^(*))/(D_(нар) S)∙1/(T_(п нар) S+1)∙(T_(1 нар) S+1)/(T_(2 нар) S+1)∙1/(T_(3 нар) S+1)

W_(скор.) (S)=(3.48∙10^7)/(56.5∙S)∙1/(4.12 S+1)∙(0.004S+1)/(0.0004S+1)∙1/(0.00004 S+1)

ЛАФЧХ скорректированной системы имеет вид:

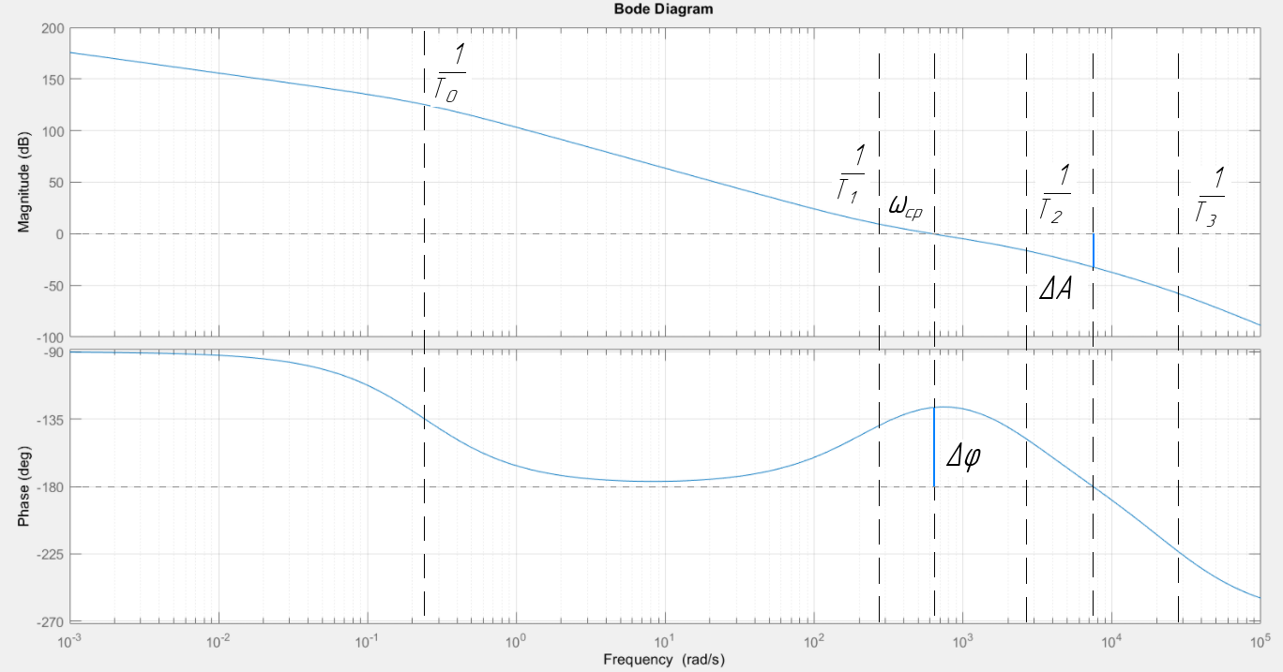
[picture p12: figure]

В результате корректировки получены следующие запасы:

1. По фазе ∆φ=53°
2. По амплитуде ∆L=31.6 дБ

Частота среза:

ω_(ср) =65 Гц

Переходный процесс скорректированной системы:

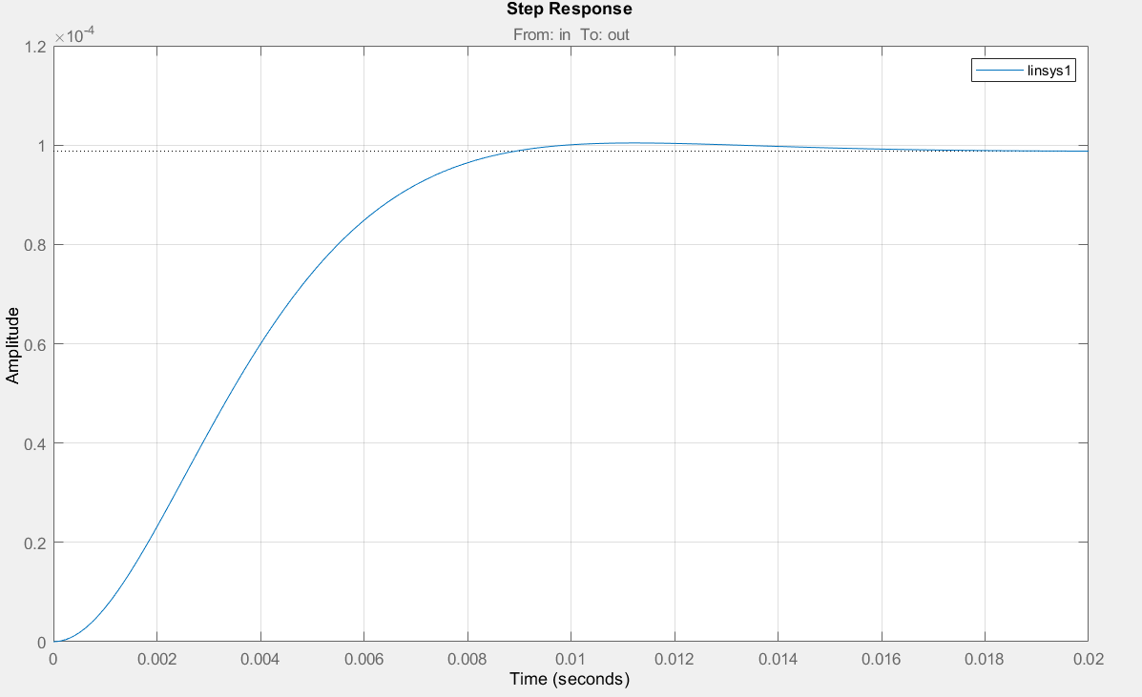
[picture p13: figure]

Переходной процесс устойчив. Время пп t_(п_вн) =0.012с .

Величина перерегулирования σ=1.5%

По результатам эксперимента можно сделать вывод, что корректировка достигла своей цели.

Поскольку при построении переходного процесса на вход системы подавалось ступенчатое воздействие по величине равное суммарному возмущающему моменту, установившееся значение будет равно ошибке стабилизации.

Таким образом, полученная ошибка стабилизации по внутренней оси:

α_(уст) =0.000099 рад=0.34'<∆α

Так как установившееся значение ошибки меньше заданной по ТЗ, можно утверждать, что требования ТЗ по точности выполнены.

7. Описание и расчет электрической схемы.

Бортовое питание 27В подается через разъем соединительный (XP1) на блок питания (БП), в котором формируются все напряжения, необходимые для обеспечения работы блоков и элементов гиростабилизатора. На контакты 3-4 выводится питание ВОГ (+5В), которое через упругий токоподвод (XA2) соединяется с ВОГ 1 и ВОГ 2; на контакты 5-7 – двухполярное питание 15В малосигнальных устройств (интегратор A3, A4 и КУ A5, A6); на контакты 8-10 – напряжение питания 27В усилителей мощности A8, A9 и на контакты 11-12 – преобразованное напряжение (36В, 1000Гц) датчиков положения платформы и рамы B1 и B2.

Жгут питания и сигнальный гальванически развязаны.

Работа гиростабилизатора в режиме стабилизации по оси X.

Информация о движении платформы определяется ВОГ1. Cигнал снимается с аналогово выхода и подается через токоподвод (XA3) на интегратор A3 вход 1. Далее сигнал поступает в корректирующий усилитель (КУ) A5, где проводится требуемая коррекция амплитудно-частотной характеристики канала и следом в усилитель мощности A8 для формирования сигнала управления для ДМх. После этого сигнал подается на двигатель разгрузки (ДМx) M1 через токоподвод XA1 (провод 3-4).

Работа гиростабилизатора в режиме стабилизации по оси Y.

Информация о движении платформы определяется ВОГ2. Cигнал снимается с аналогово выхода и подается через токоподвод (XA3) на интегратор A4 вход 1. Далее сигнал поступает в корректирующий усилитель (КУ) A6, где проводится требуемая коррекция амплитудно-частотной характеристики канала и следом в усилитель мощности A9 для формирования сигнала управления для ДМу. После этого сигнал подается на двигатель разгрузки (ДМу) M2 через токоподвод XA3 (провод 5-6).

Работа гиростабилизатора в режиме управления по оси X.

С пульта управления на разъем соединительный (XP1) подается сигнал. C выхода XP1 (контакты 3-4) поступает на вход 2 интегратора A3, где суммируется с сигналом от ВОГ1. Далее сигнал проходит корректирующий усилитель (КУх) A5, усилитель мощности (УМх) A8 и наконец попадает на датчик момента M1.

Работа гиростабилизатора в режиме управления по оси Y.

С пульта управления на разъем соединительный (XP1) подается сигнал. C выхода XP1 (контакты 5-6) поступает на вход 2 интегратора A4, где суммируется с сигналом от ВОГ2. Далее сигнал проходит корректирующий усилитель (КУу) A6, усилитель мощности (УМу) A9 и наконец попадает на датчик момента M2.

Работа гиростабилизатора в режиме управления по сигналу ДУ по оси X.

Сигнал с датчика угла (B1) по проводам 9-12 подается на разъем соединительный (XP1) (контакт 7-10). Потом проходит на пульт управления и оттуда снова на XP1, но на контакты 3-4. Далее этот сигнал подается на вход 2 интегратора A3 (внутри предусмотрен сумматор) и суммируется с проинтегрируемым сигналом со входа 1. А потом, как было описано выше, проходит через А5, А8 и попадает на М1.

Работа гиростабилизатора в режиме управления по сигналу ДУ по оси Y.

Сигнал с датчика угла (B2) по проводам 17-20 подается на разъем соединительный (XP1) (контакт 11-14). Потом проходит на пульт управления и оттуда снова на XP1, но на контакты 5-6. Далее этот сигнал подается на вход 2 интегратора A4 (внутри предусмотрен сумматор) и суммируется с проинтегрируемым сигналом со входа 1. А потом, как было описано выше, проходит через А6, А9 и попадает на М2.

Расчет корректирующего устройства по оси X.

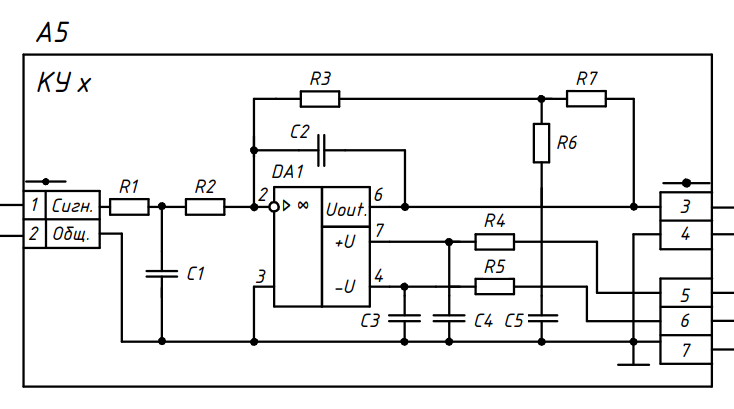
[picture p14: figure]

Рис.10 Схема корректирующего устройства.

Рассчитаем номинальные значения элементов.

Hа входе выражение для сопротивления короткого замыкания Z_(вх) (s) имеет вид:

Z_(вх) (s)=(R_1 +R_2 )(1+(R_1 R_2)/(R_1 +R_2)C_1 s)=(R_1 +R_2 )(1+T_3 s)

T_3 =(R_1 R_2)/(R_1 +R_2)C_1

Ha выходе (без учета конденсатора C_2 ) выражение для сопротивления короткого замыкания Z_(вх) (s) имеет вид:

Z_(вх) (s)=(R_3 +R_7 )*(1+T_1 s)/(1+T_2 s) ,где T_2 =R_6 C_5 и T_1 =R_6 +(R_3 R_7)/(R_3 +R_7)

Передаточная функция корректирующего звена:

W_p (s)=(U_(вых) (s))/(U_(вх) (s))=-(Z_(вых) (s))/(Z_(вх) (s))=-K*(T_1 s+1)/(T_2 s+1)*1/(T_3 s+1) ,где K=(R_3 +R_7)/(R_1 +R_2)

Для упрощения расчета можно принять R_1 =R_2 =R_3 =R_7 =R . При этом K=1 и выражения для вычисления номинальных значений элементов примут следующий вид:

C_1 =(T_3 C_5)/(T_1 -T_2) ; R_6 =(T_2)/(C_5) ; R=(2T_3)/(С_1) ;

Постоянные времени корректирующего звена:

T_1 =0.004c, T_2 =0,0004c, T_3 =0,00004c;

Из условия обеспечения стабильности параметров конденсаторов выбираем по стандарту Е24: C_5 =0,47 мкФ . Отсюда по выражениям, приведенным выше, определим следующие значение:

С_1 =(0,00004∙0,47∙10^(-6))/(0,004-0,0004)=5.2 нФ

По стандарту Е24: С1=5.1 нФ

R_6 =(0,0004)/(0,47∙10^(-6))=851 Ом

R_() =(2∙0,00004)/(5.1∙10^(-9))= 15.7 кОм

По стандарту Е24: R_6 =845 Ом, R=15.8 кОм.

Расчет корректирующего устройства по оси Y.

T_1 =0.0065c, T_2 =0,00065c, T_3 =0,000065c;

Из условия обеспечения стабильности параметров конденсаторов выбираем по стандарту Е24: C_5 =0,47 мкФ . Отсюда по выражениям, приведенным выше, определим следующие значение:

С_1 =(0,000065∙0,47∙10^(-6))/(0,0065-0,00065)=5.2 нФ

По стандарту Е24: С1=5.1 нФ

R_6 =(0,00065)/(0,47∙10^(-6))=1,38 кОм

R_() =(2∙0,000065)/(5.1∙10^(-9))= 25 кОм

По стандарту Е24: R_6 =1.37 кОм, R=24.9 кОм.

8. Технологическая часть.

Размерная цепь – это замкнутая система взаимосвязанных размеров, относящихся к одной или нескольким деталям, определяющим относительное положение поверхностей или осей этих деталей. Размерная цепь, выражающая взаимную связь деталей сборочного соединения, называется сборочной размерной цепью.

Звеном размерной цепи называют размер, определяющий расстояние между поверхностями (осями) или их угловое расположение.

Замыкающее звено - это звено размерной цепи, которое в процессе сборки формируется в последнюю очередь, замыкая размерную цепь. Размер замыкающего звена зависит от размеров остальных звеньев размерной цепи, называемых составляющими.

Чаще всего замыкающим звеном является размер детали-компенсатора.

После определения замыкающего звена оставшиеся звенья размерной цепи в зависимости от их влияния на замыкающее звено подразделяют на увеличивающие и уменьшающие размеры.

Увеличивающие размеры – размеры, с увеличением которых замыкающий размер увеличивается.

Уменьшающие размеры – размеры, с увеличением которых замыкающий размер уменьшается.

Задачей расчёта размерных цепей является обеспечение заданной точности замыкающего звена.

Существует два основных метода расчёта размерной цепи.

Расчёт по методу максимума – минимума. Предполагается, что все детали, входящие в сборочную единицу, имеют предельные максимальные и минимальные отклонения от номиналов и сборку производят при самом неблагоприятном сочетании размеров деталей, т.е. когда максимальные предельные ошибки складываются.

Расчёт на основе теории вероятностей. Считают, что все размеры деталей партии являются случайными величинами и имеют рассеяние фактических значений в пределах поля допуска.

Поскольку количество деталей, имеющих размеры на границах допуска, невелико, то при расчёте на основе теории вероятностей даётся более широкий допуск на изготовление деталей, чем расчёте на максимум – минимум. Расширение допуска приводит к некоторому риску – из некоторых деталей данной партии не удастся собрать узел, поскольку условие взаимозаменяемости для них не оказывается невыполнимым.

На листе технологической части проекта представлена размерная цепь для расчёта размера компенсационной прокладки.

Рассчитаем размерную цепь по методу максимума – минимума. Расчёт проведём для 8 квалитета (на раму, крышки ДМ и ДУ по 10 квалитету, на подшипники по 6 квалитету).

Размеры и предельные отклонения звеньев приведены в таблице:

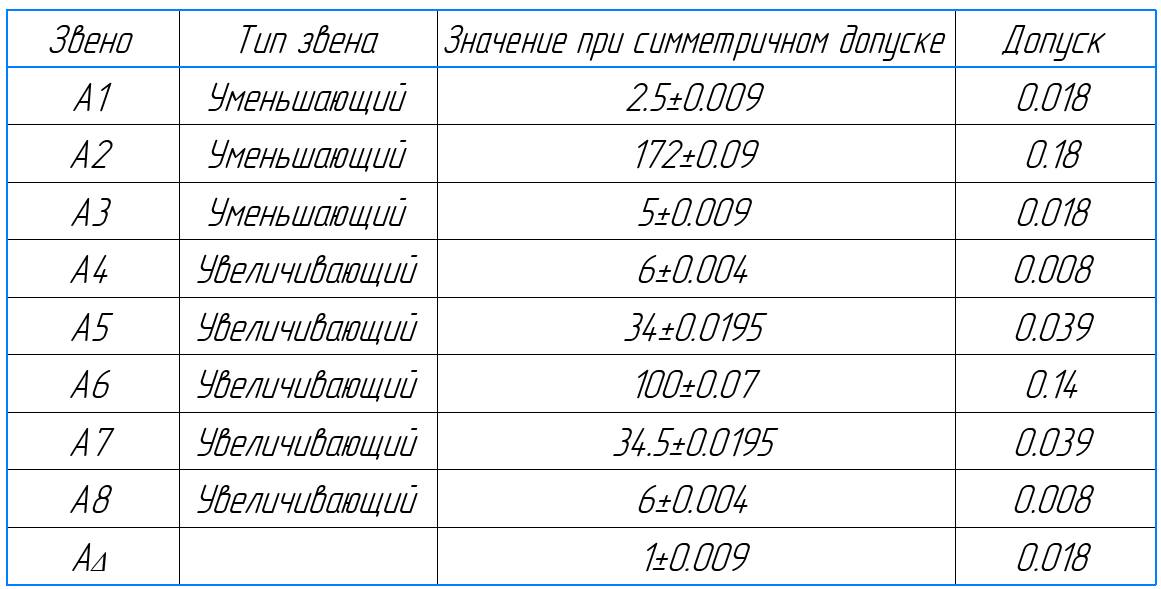
[picture p15: figure]

При расчёте размерных цепей по методу максимума –номинальное (Аном) значения замыкающего звена определяются по формулам:

А_(ном) =∑_(i=1)^n А_(ув.i) -∑_(j=1)^p А_(ум.j)

где, ∑_(i=1)^n А_(ум.i) - сумма соответственно средних, номинальных значений увеличивающих звеньев;

∑_(j=1)^p А_(ум.j) - сумма соответственно средних, номинальных значений уменьшающих звеньев.

Для номинального значения замыкающего звена хном его верхнее ( EsА_(ном) ) и нижнее ( EiА_(ном) ) отклонения определяются по выражениям:

EsА_(ном) =∑_(i=1)^n EsА_(ув.i) -∑_(j=1)^p EiА_(ум.j) ;

EiА_(ном) =∑_(i=1)^n EiА_(ув.i) -∑_(j=1)^p EsА_(ум.j) ,

где ∑_(i=1)^n EsА_(ув.i) и ∑_(i=1)^n EiА_(ув.i) - алгебраические суммы верхних и нижних отклонений увеличивающих звеньев, число которых n;

∑_(j=1)^p EiА_(ум.j) и ∑_(j=1)^p EsА_(ум.j) - алгебраические суммы верхних и нижних отклонений уменьшающих звеньев, число которых p.

В результате расчёта получим:

Axном = 1 мм

EsА_(ном) = 9 мкм,

EiА_(ном) = -9 мкм.

Значение размера замыкающего звена с полем допуска:

Aх=1±0,009 мм.

# 9. Заключение.

В результате проектированный прибор полностью удовлетворяет требованиям технического задания и обеспечивает устойчивую работу в условиях эксплуатации указанных в техническом задании:

1. Установившаяся ошибка стабилизации по оси платформы β^(*) = 0.41 угл.мин, по оси рамы α^(*) = 0.34 угл.мин.

2. Максимальный угол прокачки 40°.
