litvinoval/cursach/первый сем/РПЗ Пашинин.pdf

Содержание

6. Расчет вредных моментов, действующих вокруг осей стабилизации: ...... 15
Расчет моментов трения | 15
Расчет моментов тяжения токоподводов | 18
Расчет моментов остаточной несбалансированности | 20
Расчет моментов неравножесткости | 22
Расчет инерционных моментов рам корданова подвеса | 23
Подсчѐт суммарных возмущающих моментов и выбор двигателей
разгрузки | 23
Выбор организационной формы сборки | 44
Построение технологической схемы сборки | 44
Расчет коэффициентов технологичности конструкции прибора | 48
Расчет сборочной размерной цепи | 51

Введение

Гироскопическими стабилизаторами (ГС) называются гироскопические устройства, предназначенные для стабилизации тех или иных приборов и устройств в инерциальном пространстве, а также управление их угловым положением.

На гироскопические приборы и системы возлагаются сложные задачи по стабилизации и управлению специальными бортовыми приборами (приборы инерциальной навигации, антенны бортовых радиолокационных станций,
чувствительные | элементы | пеленгаторов, | координаторы | цели,
аэрофотоаппараты и др.) Известно, что ось гироскопа в кардановом подвесе, установленного на борту летательного аппарата, в течение длительного времени сохраняет почти неизменное направление в пространстве. Однако несовершенство элементов конструкции и тяжелые условия эксплуатации порождают значительные моменты внешних сил, действующие на гироскоп и отклоняющие ось вращения его ротора, а следовательно и стабилизируемую ось от заданного направления в пространстве. Требования высокой точности стабилизации приборов бортовых систем привели к необходимости создания гироскопических стабилизаторов.

Классификация гиростабилизаторов:

- По типу применяемых гироскопов:

Гиростабилизаторы разделяются на ГС с двухстепенными гироскопами

и ГС с трехстепенными гироскопами. В свою очередь ГС с двухстепенными

гироскопами можно разделить по типу подвеса гироскопов: ГС с

гироскопами | на | шарикоподшипниковом | подвесе, | на | поплавковом,

воздушном, магнитном подвесах и т.п. Гиростабилизаторы с трехстепенными

гироскопами делятся на ГС с бескарданными гироскопами и ГС на базе

гироскопов с кардановым подвесом.

- По роли гироскопа в процессе стабилизации:
1) Силовые ГС. В этом типе ГС возмущающие моменты

уравновешиваются гироскопическим моментом и моментом,

создаваемым приводом разгрузки. Постоянные или медленно

изменяющиеся | моменты | уравновешиваются | в | основном

моментом привода разгрузки, а знакопеременные, особенно

быстро | изменяющиеся, | уравновешиваются | как | приводом

разгрузки, так и гироскопическим моментом, а при высоких

частотах изменения момента еще и инерционным моментом

самой платформы. Для силовых ГС требуются гироскопы с

высоким кинетическим моментом.

2) Индикаторно-силовые ГС. В таких ГС силовая роль гироскопов

снижена. Наличие у гироскопа большого кинетического момента

не является обязательным.

3) Индикаторные ГС. Гироскопический момент практически не

участвует в непосредственной компенсации возмущающих

моментов, и их подавление определяется в основном приводом

стабилизации, | который | должен | выбираться | из | условия

уравновешивания всех составляющих возмущающего момента.

- По типу чувствительного элемента:
1) ГС на двухосных гироскопах.
2) ГС на трехосных гироскопах.
3) ГС на датчиках угловых скоростей.
4) ГС на датчиках угловых ускорений.
- По количеству осей стабилизации:
1) Одноосные ГС. – стабилизируют то или иное устройство только

относительно одной оси.

2) Двухосные ГС. – стабилизируют приборы и устройства

относительно двух осей ( например , ГС , создающий

горизонтальную площадку)

3) Трехосные ГС. – осуществляют стабилизацию относительно трех

осей , т.е. полную стабилизацию . Такие ГС называются еще

пространственными | гиростабилизаторами | или

гиростабилизированными платформами.

- По типу подвеса:
1) Корданов подвес
2) Плавающий подвес
3) На космических аппаратах роль подвеса может выполнять сам

аппарат

- По типу привода:
1) Электромеханические.
2) Пневматические.
3) Гидравлические.
4) Реактивные

Назначение прибора

Разрабатываемый прибор предназначается для угловой стабилизации в инерциальном пространстве положения оси координатора цели (КЦ) головки самонаведения (линии визирования), управления еѐ положением с помощью сигналов, получаемых из координатора цели, а также измерения углов отклонения и угловой скорости платформы.

При этом должны быть обеспечены следующие параметры прибора:

- установившаяся ошибка стабилизации меньше 0,5 угловых минут
- максимальная скорость управления – 10 ⁄
- максимальное угловое ускорение ЛВ - 4

⁄
- максимальный пеленг цели

Принцип работы

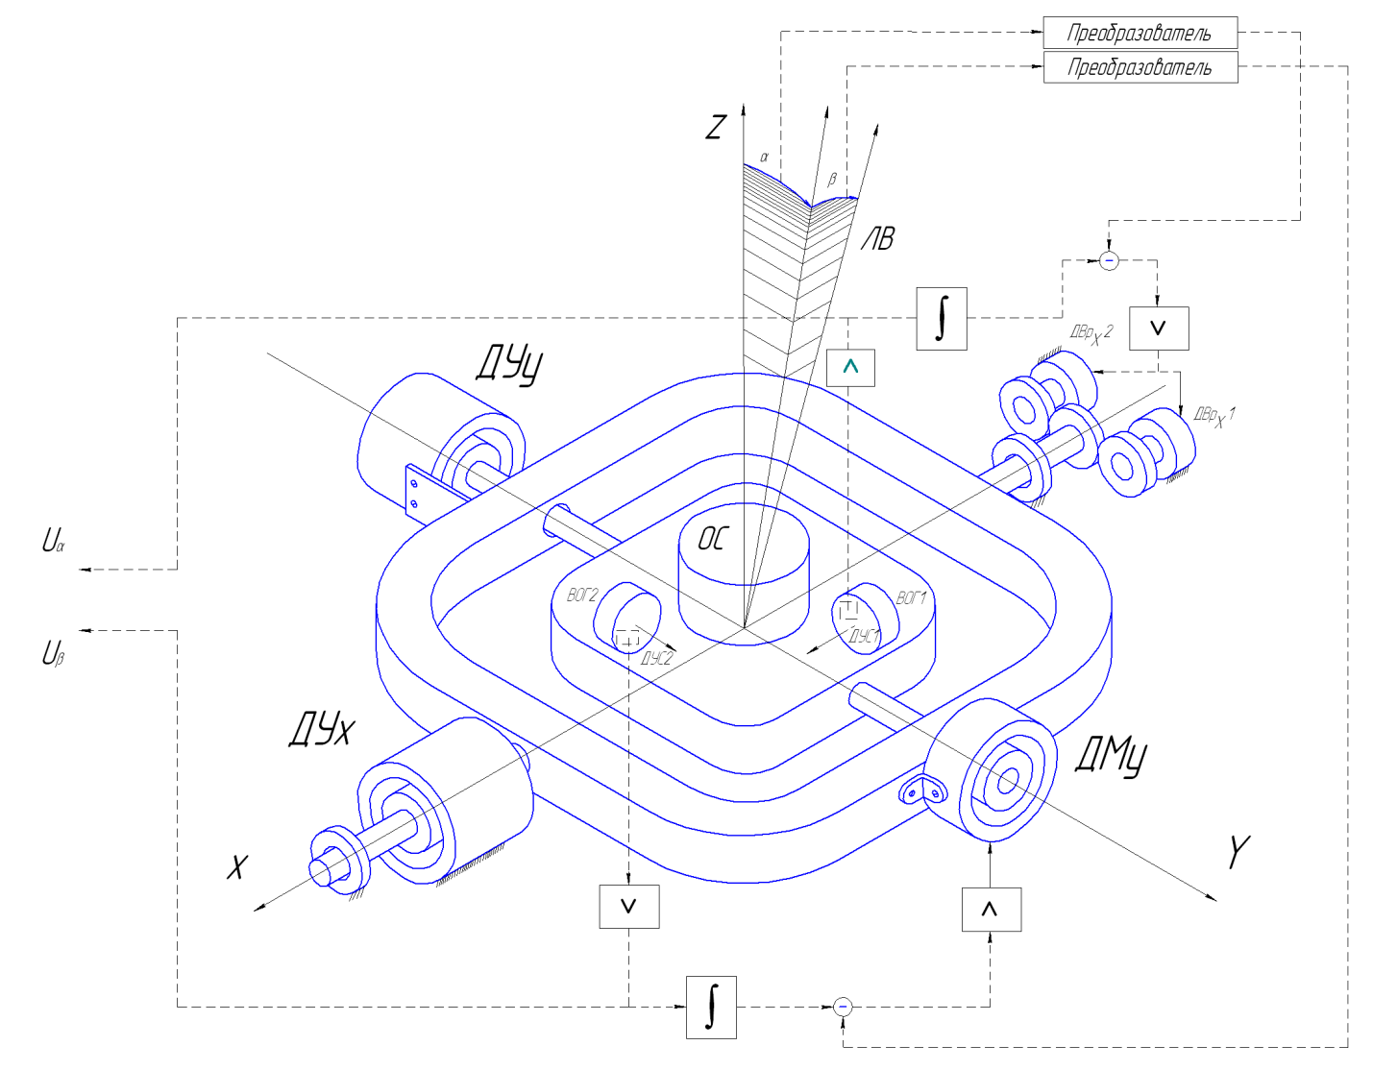
[picture p37: figure]

ГС состоит из платформы, с закрепленными на ней КЦ и двумя ВОГ, которая помещена в двухосный наружный карданов подвес, а также системы стабилизации и устройств вывода информации потребителям.
Принцип действия индикаторного стабилизатора на ВОГ основан на компенсации возмущающих моментов действующих на объект стабилизации (ОС) с помощью приводов стабилизации, момент развиваемый которыми компенсирует возмущающие.
При повороте ОС на ,установленных на нѐм, ВОГах вырабатывается сигнал пропорциональный угловой скорости движения ОС. Этот сигнал после интегрирования и усиления подается на приводы стабилизации, которые вырабатывают момент направленный в противоположную сторону поворота ОС.
Управление положением ОС в инерциальном пространстве осуществляется сигналами с координатора цели, который вычитаются из сигналов с ВОГ и также подаются на привод стабилизации. Сигналы с КЦ пропорциональны отклонению линии визирования от направления на цель. С помощью такой системы осуществляется слежение ЛВ за целью.

Описание конструкции ГС, ЧЭ, узлов

Описание конструкции ГС

Конструкция двухосного индикаторного гиростабилизатора КЦ на представляет собой закрепленный на полуосях координатор цели, выполняющей роль платформы, к которому крепятся чувствительные элементы. Полуоси закрепляются в шарикоподшипниковых опорах в рамке. Также на полуоси и рамку устанавливаются датчики момента для выработки момента стабилизации и датчики угла для выработки выходных сигналов об угловом положении ЛВ.

Аналогично рама устанавливается на полуосях в шарикоподшипниковые опоры в корпусе, на котором устанавливаются блок электроники и электрический разъем.

Описание конструкции узлов ГС

Узел ДМ

Датчик момента ДМ5 состоит из двух механически раздельных частей – статора и ротора. Статор представляет собой магнитопровод с установленными в нѐм постоянными магнитами и установленным сверху коллекторно-щеточным узлом. Статор, через отверстия в оном, крепится винтами к корпусу. Также винтами крепится к статору коллекторно-щеточный узел. Ротор ДМ представляет собой магнитопровод с обмоткой, на которую через щетки подается управляющий ток. Ротор устанавливается на полуось и поджимается гайкой.

Узел ДУ

В качестве датчиков угла выбираются синусно-косинусные трансформаторы СКТ265 безкорпусного типа, которые представляют собой две раздельный механические части – ротор и статор. Ротор поджимается гайкой к полуоси, а статор к корпусу.

Описание чувствительного элемента – ВГ949П

ВГ949П является датчиком абсолютной угловой скорости.

Принцип действия ВОГ основан на зависимости времени облета света замкнутого вращающегося контура от направления обхода (эффект Саньяка-Майкельсона).

Кольцевой интерферометр конструктивно выполнен таким образом, что излучение от одного источника делится на две волны равной интенсивности I , которые распространяются в контуре в противоположных направлениях и интерферируют после его обхода. Сигнал интерференции в этом случае есть I(1+cos(F)), где F – разность фазовых набегов (сдвиг фаз) волн в контуре. При вращении создается сдвиг фаз (фаза Саньяка) между встречными волнами F=2πDLW/λc (D – диаметр катушки, L – длина волокна, W – скорость вращения вокруг нормали к плоскости контура (оси чувствительности).

Коэффициент пропорциональности между угловой скоростью и фазой Саньяка называется оптическим масштабным коэффициентом контура (К).

Величина К(≈ 3мрад/∘ /с) определяет диапазон измеряемых угловых

скоростей ФS <1рад/с, ФS=KW).

Минимальная измеряемая угловая скорость зависит от качества оптических компонентов (модуль, ответвитель, поляризатор). Ее отношение к максимальной измеряемой скорости представляет динамический диапазон ВОГ (80дБ..90дБ).

Качество оптики проявляется в максимальном подавлении всех механизмов возникновения сдвига фаз в интерферометре, кроме как вследствие вращения. Оптическая архитектура ВГ949П обеспечивает оптимальную оптическую фильтрацию сигнала для уменьшения дрейфа и повышения помехоустойчивости. Для этого излучение проходит поляризационный фильтр и на ответвителе разделяется на два встречных луча волоконного контура. После обхода контура лучи смешиваются(интерферируют) на том же ответвителе и опять проходят поляризационный фильтр, обеспечивающий идентичность(взаимность) оптических путей встречных волн в контуре. Вторым ответвителем сигнал интерференции отводится на фотоприемное устройство, сигнал которого пропорционален мощности светового потока.

Для повышения чувствительности используется пьезокерамический фазовый модулятор(ПЭТ). При питании его переменным напряжением создается дополнительный сдвиг фаз m(T)=M*sin(wt) за счет периодического растяжения участка волоконного контура.

При работе модулятора выходной сигнал может быть выражен в виде:

( | ) | ( | ( ))
( ) | ( ) | ( )
( ) | ( ) | ( | )
( ) | ( ) | ( )

Где представлены основные составляющие сигнала ВОГ (Jn – функция бесселя порядка n). Это – первая гармоника частоты модуляции, вторая гармоника, постоянная составляющая и сигнал квадратурной помехи (QB). Они зависят от амплитуды модуляции (М) и угловой скорости. Квадратурный сигнал (QB) также проявляется на частоте модуляции, однако он не зависит от вращения и сдвинут по фазе на 90˚ относительно сигнала

вращения.

При вращении датчика появляется сигнал на первой гармонике, пропорциональный скорости вращения. Его величина зависит также от тока СЛД и напряжения ПЭТ. Выходное напряжение в диапазоне измеряемых скоростей (-Wmax...+Wmax) апроксимируется соотошением:

( | ˚ ) | [ | ( ˚ )] * | (
)

+ ( ˚ )

SF – крутизна системы (коэффициент между скоростью и напряжением), B(t˚) – начальный сдвиг (зависит от температуры); N – случайная составляющая сигнала; s(t˚) – температурная составляющая крутизны; p –

параметр нелинейности.

SF является произведением ОМК (≈3 мрад/˚/с) и коэффициента преобразования электронного блока (≈ 15 В/мрад). Нелинейность

преобразования нарастает квадратично на границах диапазона измерений до примерно 10-15%. Она корректируется квадратичной аппроксимацией до уровня 0.3..1%. При малых скоростях вращения нелинейность пренебрежимо мала.

Волоконно-оптический контур изготовлен из одномодового оптического волокна, сохраняющего поляризацию излучения, и имеющего следующие технические характеристики: длина поляризационных биений 5 мм; диаметр кварцевой оболочки – 45 мм; диаметр волокна в полимерном покрытии – 150 мкм; длина волокна – 100 мм; диаметр намотки – 70 мм. Внешние по отношению к жиле слои волокна выполняются из легированного кварца для придания ему определенных оптических и механических свойств. Длина и диаметр намотки определяют ОМК датчика.

Фазовый модулятор (ПЭТ) представляет собой участок волоконного контура, намотанный на пьезокерамический (ЦТС-23) цилиндр диаметром 18 мм. Рабочая частота модуляции (резонансная) 73.,.83кГц, добротность не менее
150. Статическая емкость примерно 220пФ. Характеристики модулятора зависят от температуры. Так, активное сопротивление падает с температурой, а коэффициент преобразования (соотношение между индексом фазовой модуляции и нааряжением ПЗТ) соответственно возрастает. ПЗТ является электромеханической колебательной системой. Кроме основного (радиального) типа колебаний в нем существуют и другие типы колебаний, резонансные частоты которых выше 350кГц.

Волоконный биконический ответвитель 2x2 является устройством, осуществляющим оптическую связь между волокнами. Он изготовлен таким образом, что излучение, распространяющееся в одном из волокон, равномерно и практически без потерь (менее О.ЗдБ) распределяется между двумя волокнами. Ответвители изготавливаются по сварной технологии непосредственно на концах контура, после чего распаиваются на кварцевых подложках для обеспечения вибро и термоустойчивости.

Волоконно-кристаллический поляризатор выполнен в виде биконического перехода (утончения) на участке волокна, заращенного анизотропным монокристаллом. Коэффициент экстинкции поляризатора (разность потерь волн с ортогональными поляризациями) более 30 дБ и потери в основной поляризации менее 1.5дБ.

Излучательный модуль - это кристалл суперлюминесцентного светодиода (СЛД), оптически согласованный с волокном. Длина волны излучения 815...830нм, оптическая мощность в волокне более 50мкВт. СЛД обладет яркостью, сопоставимой с яркостью лазерного источника,, имея при этом низкую когерентность. Это последнее свойство используется в ВОГ для уменьшения начального сдвига и шума.

Все узлы и компоненты ВОГ смонтированы в корпусе, выполненном из алюминиевого сплава. Внутренняя полость ВОГ заполняется сухим азотом. Герметизация ВОГ осуществляется кремнийорганическим герметиком и механическим поджимом крышки и корпуса. Для ориентации ВОГ на объекте используется установочная поверхность (основание).

Предварительный расчет инерционных характеристик ГС

Масса элементов внутренней оси:

mОС=2 Кг – масса объекта стабилизации

mВОГ=0,05 Кг – масса чувствительного элемента (ВГ949П)

mДУ =0,144 Кг – масса ДУ

mДМ=0,170 Кг – масса ДМ

mполуоси = 0,150 Кг – масса полуоси (получена из компьютерной модели)

Масса элементов наружной оси:

mрамы=0,750 Кг – масса рамы (получена из компьютерной модели)

Моменты инерции:

При расчетах суммарных моментов инерции будем полагать что ДУ,ДМ и ВОГи являются точечными массами. Моменты инерции рамы и полуосей получим с трехмерной модели.

Моменты инерции объекта стабилизации:

Моменты инерции ВОГ:
(
) | (
)

(

) | (
)
Здесь | , | , | , | , | , | - координаты центра масс ВОГов
относительно центра подвеса.

; | ;
; | ;

таким образом
(
) | ( | )

(

) | ( | )

Моменты инерции ДУ и ДМ
(
) | (
)

;

;

(

) | (

)

Моменты инерции полуосей:

Моменты инерции рамы:

Суммарные моменты инерции:

Расчет вредных моментов, действующих вокруг осей стабилизации

Расчет моментов трения

Моменты трения, действующие вокруг осей карданова подвеса (КП), определяются трением в токоподводах и датчиках угла контактного типа (если таковые используются), трением в опорах КП и моментами трения в двигателях разгрузки, приведенными к осям КП. Моменты трения контактных датчиков и токоподводах, применяемых сравнительно редко, представляют даже при большом количестве токоподводов относительно малые величины из-за небольших контактных давлений. Моменты трения, возникающие в двигателях разгрузки, имеют величины, сравнимые с моментами трения в опорах для приводов разгрузки с пневматическими ДМ, в которых применяют специальные уплотнения для повышения эффективности работы датчиков, и для приводов разгрузки с коллекторными двигателями постоянного тока, где контактные давления щеток являются достаточно большими. Последние моменты указываются в технических условиях (ТУ) на двигатели непосредственно или в виде напряжения трогания двигателя, приводимого к моменту с учетом крутизны моментной характеристики. Моменты трения в контактных датчиках и токоподводах, и моменты трения в двигателях разгрузки на практике мало зависят от условий полета ЛА.

Для большинства конструкций гиростабилизаторов, как показывает практика разработок, эти моменты, приведенные к осям КП, даже при достаточно больших передаточных числах в редукторах разгрузки, имеют меньшие значения, по сравнению с моменты трения в опорах КП.

Как правило, в качестве опор осей КП гиростабилизаторов применяют однорядные шариковые подшипники. Момент трения шарикоподшипников слагается из следующих составляющих:

а) момента трения качения шариков с наружным и внутренним кольцами;

б) момента трения скольжения шариков относительно наружных и внутренних колец;

в) момента трения скольжения шариков относительно сепаратора;

г) момента, вызываемого сопротивлению движения смазки.

Величины указанных составляющих момента трения определяются конструктивными параметрами подшипников, воспринимаемой ими нагрузкой и скоростями вращения его колец, поэтому при выбранном типе подшипника момента трения зависит от нагрузки и угловой скорости относительного движения его колец. Однако, зависимость момента подшипника от угловой скорости его вращения незначительна, особенно при имеющих место в гиростабилизаторах малых скоростях относительного движения, и часто принимают, что этот момент имеет характер "сухого" или кулонова трения. Вычисляется момент трения по формуле:

тр | (
)

тр
– момент трения

М0 – момент трения ненагруженного подшипника

R - радиальная нагрузка

А – осевая нагрузка

Величины осевых и радиальных нагрузок на подшипники определяются весом рам КП и установленных на нѐм элементов, проекциями линейного ускорения ЛА на связанные оси и углами поворота рам КП на различных участках полета.

Предварительная оценка величин радиальной и осевой нагрузки, действующей на внутренние и наружные опоры:

радиальная и осевая нагрузка, действующая на внутренние опоры

радиальная и осевая нагрузка, действующая на внутренние опоры

Значения коэффициентов М0 , | приведены в таблице:

В качестве опор выберем подшипники 1000901 ГОСТ 8338-75 с внутренним диаметром 12 мм.

М0

см

см

см

Тогда момент трения по внутренней оси:

вн

тр | [ | (
) | ]

вн

тр | [ | ( | ) | ]

вн

тр | с | см ;

по наружной оси:

нар

тр | [ | (
) | ]

нар

тр | [ | ( | ) | ]

нар

тр | с | см ;
Диаметр оси, мм | М0, г*см | k1, см | k2, см | k3, см
| Одноряд ные | Двухряд-ные | Одноряд-ные | Двухряд-ные | Одноряд-ные | двухрядны е
5 | – | 8,9 | 0,0156 | 0,0163 | 0,0016 | 0,0075 | 0,005
6 | – | 7,8 | 0,0099 | 0,0110 | 0,0013 | 0,0022 | 0,005
7 | 5,6 | 7,0 | 0,0094 | 0,0104 | 0,0018 | 0,0026 | 0,006
8 | – | 7,0 | 0,0091 | 0,0095 | 0,0023 | 0,0035 | 0,006
10 | 7,2 | 9,2 | 0,0069 | 0,0088 | 0,0035 | 0,0052 | 0,008
12 | 10,8 | 14,1 | 0,0124 | 0,0160 | 0,0050 | 0,0092 | 0,0010

Расчет моментов тяжения токоподводов

Современные гиростабилизаторы являются сложными электромеханическими устройствами, следовательно для обеспечения функционирования как самих стабилизаторов, так и стабилизируемых приборов, устанавливаемых на платформе, требуется передача большого количества электрических сигналов. Используются токоподводы на каждой оси стабилизации. Количество необходимых токоподводов достигает нескольких десятков, причем передаваемые по ним токи лежат в пределах от долей миллиампера, до десятков ампер (в цепи питания гиромотора). Конструкцией токоподводов должна быть обеспечена высокая надежность передачи сигналов через них в условиях жестких эксплуатационных воздействий (линейные ускорения и вибрации) и при больших углах поворота КП.

При выборе типа токоподвода для гиростабилизаторов величины моментов, создаваемых ими не играют определяющей роли, в отличии от других гироскопических приборов, так как используются системы разгрузки. Применяются два типа токоподводов: многоконтактные коллекторные и различные типы гибких проводников. Коллекторные токоподводы применяют тогда, когда необходимо получать в стабилизаторе большие углы поворота (например, больше 120о). Работа скользящих контактов сопровождается рядом сложных физических процессов: износ и трение, нагрев зоны контактирования, образование и разрушение пленок на контактирующих поверхностях, электротермическая эрозия контактов и т.д. Токоподводы с гибкими проводниками обеспечивают высокую надежность работы. Габариты токоподводящего узла при большом количестве проводников малы. Момент, создаваемый такими токоподводами, пропорционален углам поворота рам КП и при правильном выборе типа проводников и конструкции является относительно небольшим. Уменьшение момента, а также обеспечение работы стабилизатора при неограниченном угле поворота платформы вокруг осей КП можно получить с помощью следящей системы, разворачивающей часть токоподводов, расположенную на корпусе, вслед за поворотом части, закрепленной на подвижной системе. Применяются три конструктивных типа гибких токоподводов:

1) жгуты проводников, расположенных вдоль оси вращения (для каждой из осей КП – свой жгут). Для получения малых упругих моментов, проводники имеют запас по длине, обеспечивающий их свободное скручивание;

2) свободный жгут проводников, который может изгибаться во всех направлениях при поворотах платформы КП и имеет соответствующий запас по длине;
3) барабан со спирально уложенными рядами проводников, которые при поворотах скручиваются или раскручиваются. Для уменьшения габаритов и упрощения конструкции применяют специальные многожильные ленточные провода. Так же, как и в первой конструкции, обеспечивается поворот только вокруг одной оси.

При изгибе и скручивании проводников возникают как упругие моменты, так и моменты трения из-за взаимного перемещения проводников в жгуте.

При соответствующем выборе материалов изоляции проводов моменты трения удается уменьшить до величины, пренебрежимо малой по сравнению с моментами трения в опорах КП. Для уменьшения упругих моментов применяют провода малого сечения.

В случае несимметричных углов отклонения рам КП (или при работе гиростабилизатора в течение большей части полета с ненулевыми углами поворота КП) применяют предварительный разворот части токоподвода, установленной на корпусе, что позволяет получить малые моменты в основной рабочей зоне углов.

Так как величина моментов сопротивления всех приведенных типов гибких токоподводов существенно зависит от конструкции и технологии изготовления, то моменты сопротивления обычно определяют по данным испытаний макетов узлов токоподводов или по экспериментальным данным для приборов-аналогов.

Поскольку максимальный угол поворота наружной рамы и платформы от

нулевого положения (угол прокачки) составляет значение

0 φ = 35
, что меньше
180 , то мы будем использовать жгут из гибких проводников.

Момент тяжения жгута определяется по формуле:

*

+ - эмпирический коэффициент

N – количество токоподводов

[ ]

[ ] – угол поворота

Максимального значения момент тяжения достигает при угле поворота равном углу прокачки, то есть

примем

количество проводов идущих по внутренней и наружной оси:

длину токоподводов между местами их заделк проводов по внутренней и наружной оси:

Тогда моменты тяжения токоподводов по внутренней оси:

Расчет моментов остаточной несбалансированности

Балансировку вращающихся частей гиростабилизатора (платформы, рамы карданова подвеса) производят при сборке прибора либо на собственных подшипниках при уменьшении моментов сопротивления и трения вокруг осей карданова подвеса (посредством снятия предварительного натяга подшипников, введения технологической вибрации во время балансировки и др.), либо на специальных приспособлениях. При линейных перегрузках неточность балансировки наряду с моментом трения в опорах создает значительную часть возмущающих моментов, уравновешиваемых системой стабилизации. При расчетах возмущающих моментов определяют максимальную величину моментов от остаточной несбалансированности.

Считаем, что балансировка проводится в собственных опорах при снятом осевом натяге.

Величины максимальных моментов относительно внутренней и наружной осей:

где | - остаточные моменты несбалансированности во внутренних и
наружных осях, компенсируемые при балансировке силами трения, n – перегрузка.

Остаточные моменты несбалансированности рассчитаем по формуле:

[ | ( ) ]
[ | ( ) ]
- радиальные нагрузки, вызванные силой тяжести, действующие на внутренние и наружные опоры.

тогда

[ | ( | ) | ] | с | см
[ | ( | ) | ] | с | см

Тогда моменты остаточной несбалансированности по внутренней и наружной оси:

с | см
с | см

Расчет моментов неравножесткости
Карданов подвес стабилизатора состоит из упругих элементов (рам, осей, цапф, подшипников), при деформации которых появляются силы внутреннего трения. Под влиянием сил инерции, возникающих при движении основания (ЛА) с ускорением, происходят упругие деформации элементов КП и относительные перемещения его рам. Направления перемещений из-за различной жесткости элементов в разных направлениях обычно не совпадают с линией действия сил инерции, вследствие чего возникают моменты вокруг осей КП гиростабилизатора. При вибрации основания, на котором установлен прибор, на величину отклонения элементов его конструкции, т.е. на амплитуду вынужденных колебаний, влияют силы внутреннего трения в элементах, демпфирующие их колебания. Если при разработке гиростабилизаторов применяются специальные меры по обеспечению требуемой жесткости рам КП, то величина упругости КП определяется в значительной мере упругостью подшипников подвеса. Поэтому при расчете гиростабилизаторов принимают упрощенную кинематическую схему КП, в которой предполагают, что элементами, определяющими упругие деформации, являются цапфы и подшипники, т.е. вместо схем с распределенными упругостями рассматривают схемы с упругостью, сосредоточенной в опорах КП. Заметим, что жесткостные характеристики подшипников трудно поддаются расчету и обычно являются экспериментальными данными.
При расчете будем считать что ускорение по осям равно и максимально, а радиальная и продольная жесткость шарикоподшипников соответственно

равна:

,

(

)
(

)

(
( | )
( | )

)
(
( | )
( | )

)

Расчет инерционных моментов рам корданова подвеса

Двухосный гиростабилизатор стабилизирует в пространстве ось

OzП ,

связанную с платформой. При угловых движениях основания в двухосном гиростабилизаторе вследствие особенности кинематики КП наружная и внутренняя рамы поворачиваются вокруг стабилизированной оси с переменной угловой скоростью даже при постоянной угловой скорости поворота основания. Движение с переменной угловой скоростью есть движение с некоторым ускорением, которое вызывает инерционный момент, действующий вокруг оси наружной рамы КП.

Если в силовых гиростабилизаторах моменты внешних сил, изменяющихся с высокой частотой, уравновешиваются как системой разгрузки, так и гироскопическим и инерционным моментами, то в индикаторных стабилизаторах компенсация знакопеременных моментов внешних сил, также как и постоянных, полностью должна быть обеспечена системой разгрузки. Поэтому, знание этих моментов при проектировании индикаторных стабилизаторов весьма существенно.

(

) (

) ( | )
( | )

Максимальное значение

Подсчѐт суммарных возмущающих моментов и выбор двигателей разгрузки

По внутренней оси:

По наружной оси:

Выбор привода стабилизации

По ТЗ заданы следующие типы приводов стабилизации:

по внутренней оси – безредукторный привод

по наружной оси – редукторный безлюфтовый

Привод будем выбирать по пусковому или максимальному моменту. По внутренней оси подходит датчик момента ДМ5:

Двигатель | Крутизна, сН*см/А | Imax, A | Iном, А | Вес, г | Мmax, сН*см
ДМ-5 | 1100±200 | 1,3 | 0,6 | 170 | 1430

По наружной оси выбираем двигатель из серии ДПР:

Двигатель | Iп, мA | Uном, В | Вес, г | nxx , рад/с | Мп, сН*см
ДПР-32-Н1-02 | 660 | 27 | 80 | 838 | 100

Крутизна безлюфтового привода больше чем крутизна отдельного двигателя.

Выберем напряжение подпора | ,
при этом крутизна привода увеличится и пусковой момент привода теперь

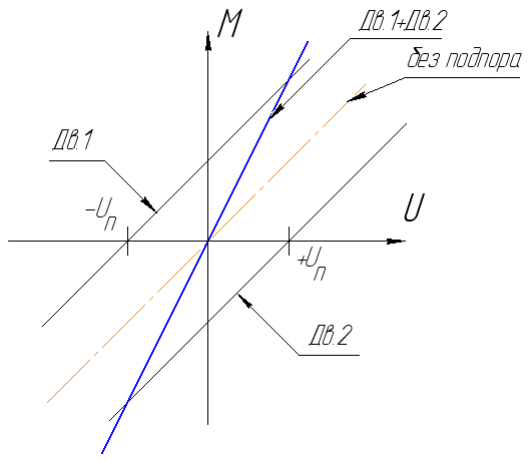
[picture p38: figure]

Передаточное отношение редуктора выберем из отношения суммарного
вредного момента взятого с запасом ( | ) и суммарного пускового
момента:

возьмем i=16.

Характеристики приводов

Расчет возмущающих моментов, создаваемых двигателями разгрузки

При больших передаточных отношениях редуктора необходимо учитывать возмущающие моменты действующие от двигателей разгрузки.
Момент инерционной обкатки:

где

- угловое ускорение основания
- приведенный момент
инерции ротора

Момент скоростной обкатки:

где | – угловая скорость основания
- приведенный коэффициент демпфирования

коэффициент демпфирования в двигателях наружной и внутренней оси:

Теперь необходимо пересчитать суммарный момент по наружной оси:

Определим запасы по моменту:

по внутренней оси:

по наружной оси:

Математическая модель каналов ГС

В данном разделе учитывается собственное движение ГС, характеризуемое колебаниями вокруг осей стабилизации при действии возмущающего момента. Исследование устойчивости гиростабилизатора проведем для каждого канала, полагая при этом, что взаимосвязь между каналами отсутствует. Необходимо уточнить, что сигналы с ВОГ являются данными об угловой скорости, а не угловом положении. Интегрирование производится с помощью апериодического звена с большой постоянной времени, что делает его влияние на ЛАХ системы в области исследуемых частот незначительными.

Математические уравнения такой системы по наружной и внутренней оси в форме Лапласа имеют следующий вид:

где

,

- суммарные приведенные моменты инерции по наружной и внутренней осям;
, | - приведенные моменты инерции по наружной и внутренней осям;
, | – коэффициенты усиления обратной связи каналов стабилизации по
наружной и внутренней осям;
, | – суммарные возмущающие моменты.

Структурные схемы каналов стабилизации для такой системы имеют вид:

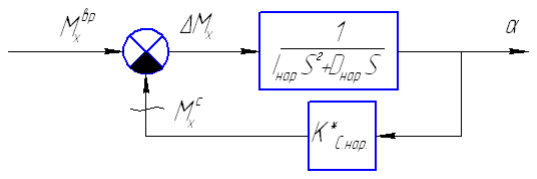
[picture p39: figure]

Канал наружной оси

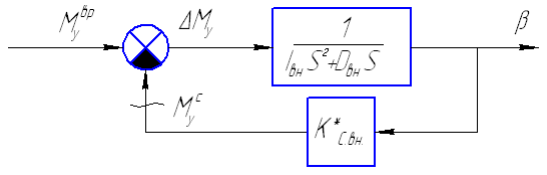
[picture p40: figure]

Канал внутренней оси

Рассчитаем параметры входящие в структурную схему.

Исходные данные для расчета : угловая погрешность стабилизации

Коэффициенты усиления обратной связи:

Возьмем запас по коэффициенту усиления

Постоянные времени:

Добротности по скорости:

Исследование устойчивости ГС

Исследование устойчивости произведем по критерию Найквиста с использованием логарифмических амплитудночастотных и фазочастотных характеристик (ЛАФЧХ) разомкнутой системы.

По каналу внутренней оси

Передаточная функция разомкнутой системы имеет вид:

( )

ЛАФЧХ такой системы имеет вид:

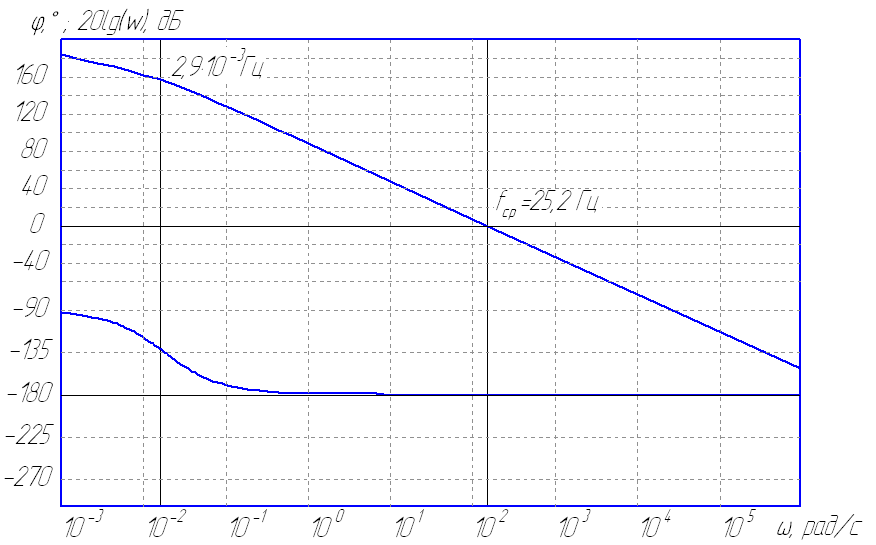
[picture p41: figure]

ЛФЧХ не пересекает уровень | , а лишь стремится к нему. Запас по фазе
в данном случае стремится к нулю ( | ), а запас по амплитуде ,напротив,
стремится к бесконечности ( | ). В целом это говорит о том, что система
находится на границе устойчивости и требует коррекции. Это можно подтвердить экспериментально построив график переходного процесса средствами компьютерного моделирования.

Переходной процесс нескорректированной системы:

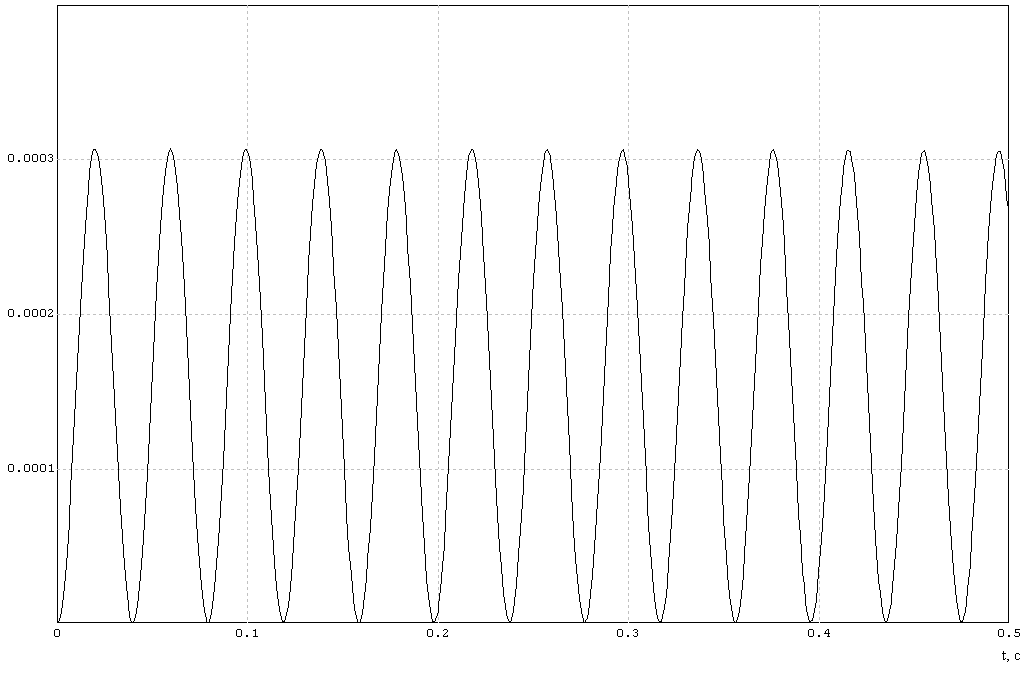
[picture p42: figure]

Чтобы увеличить запас по фазе, необходимо ввести корректирующее

дифференцирующее звено

Wäèô (S) = T1âí

- S +1
. Если правильно выбрать

постоянные времени T1 вн и Т2 вн , мы обеспечим необходимый запас устойчивости и, тогда на частоте среза ЛАЧХ будет пересекать ось 0 дБ под

наклоном –20 дБ/дек. Введением апериодического звена

1

1
( )

2

- +

=
T S

Wапер S

на несколько большей частоте вернем систему в исходное состояние. Также для подавления возникающих в контуре обратной связи высокочастотных

помех введем ещѐ одно апериодическое звено
1

1
( )
3 âí · +

=
T S

Wàïåð S
. Т3 вн

выберем меньше Т2 вн .

Постоянные времени корректирующего звена:

Передаточная функция такого корректирующего звена будет иметь вид:

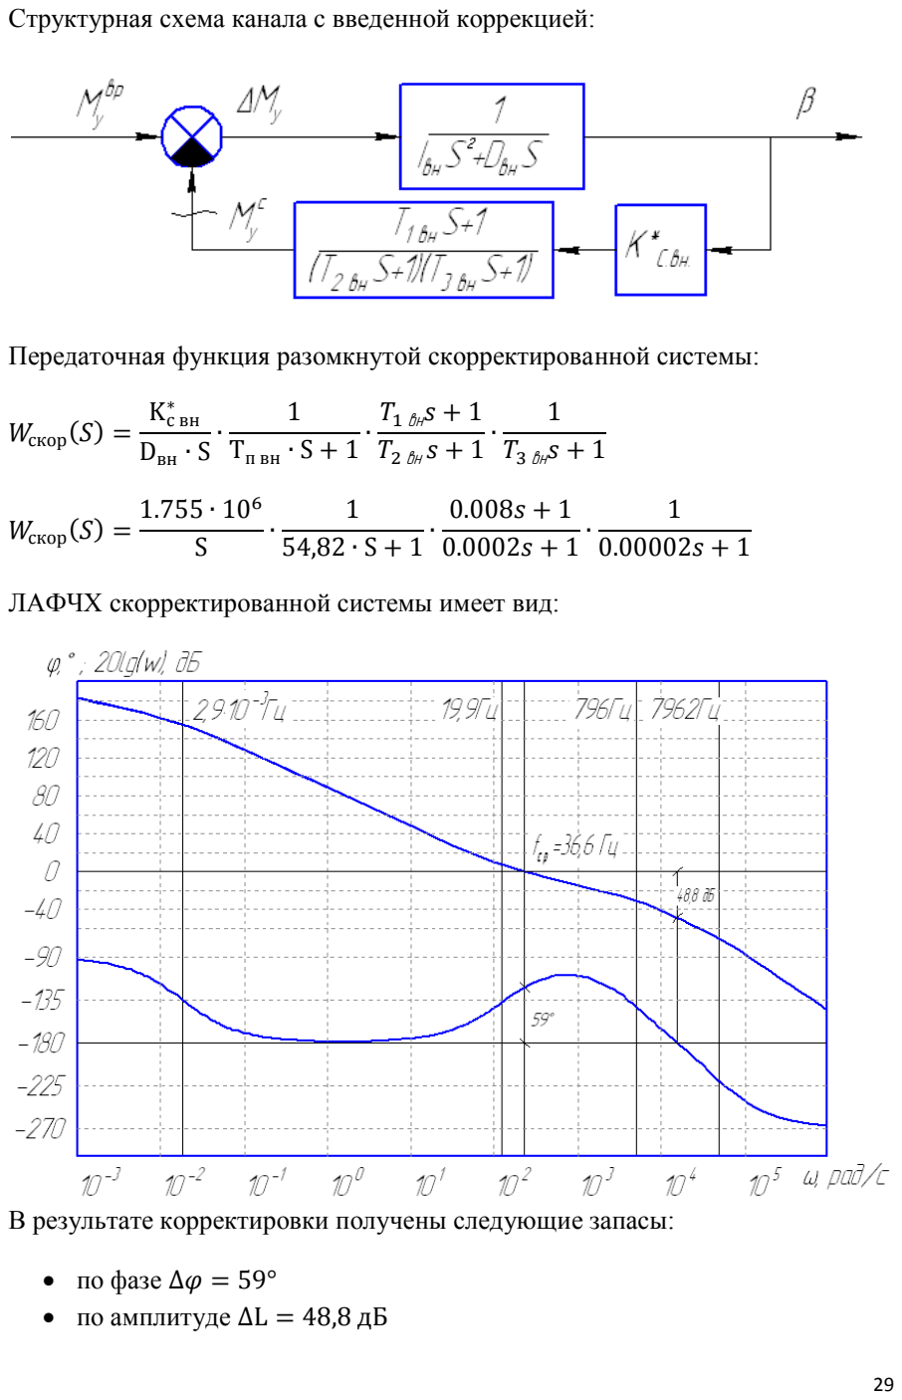
[picture p43: page 28]

Структурная схема канала с введенной коррекцией:

Передаточная функция разомкнутой скорректированной системы:

( )

( )

ЛАФЧХ скорректированной системы имеет вид:

В результате корректировки получены следующие запасы:

- по фазе
- по амплитуде

Переходный процесс скорректированной системы:

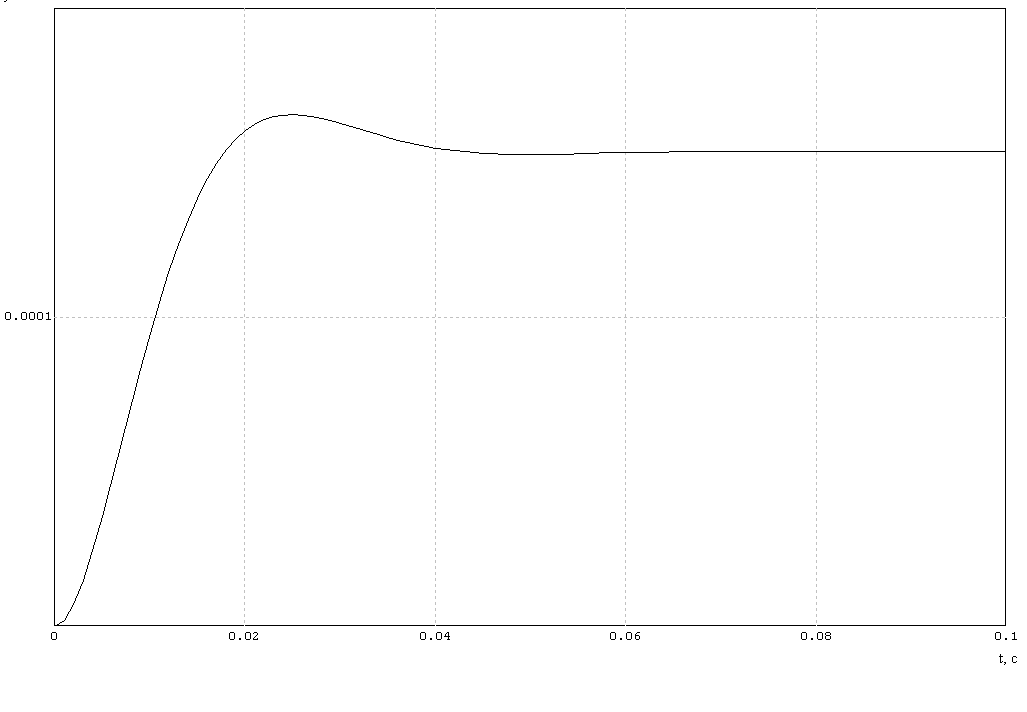
[picture p44: figure]

Переходной процесс устойчив. Время регулирования

Величина перерегулирования

По результатам эксперимента можно сделать вывод, что корректировка достигла своей цели.

Поскольку при построении переходного процесса на вход системы подавалось ступенчатое воздействие по величине равное суммарному возмущающему моменту, установившееся значение будет равно ошибке стабилизации.

Таким образом, полученная ошибка стабилизации по внутренней оси:

Так как установившееся значение ошибки меньше заданной по ТЗ, можно утверждать, что требования ТЗ по точности выполнены.

По каналу наружной оси

Передаточная функция разомкнутой системы имеет вид:

( )

ЛАФЧХ такой системы имеет вид:

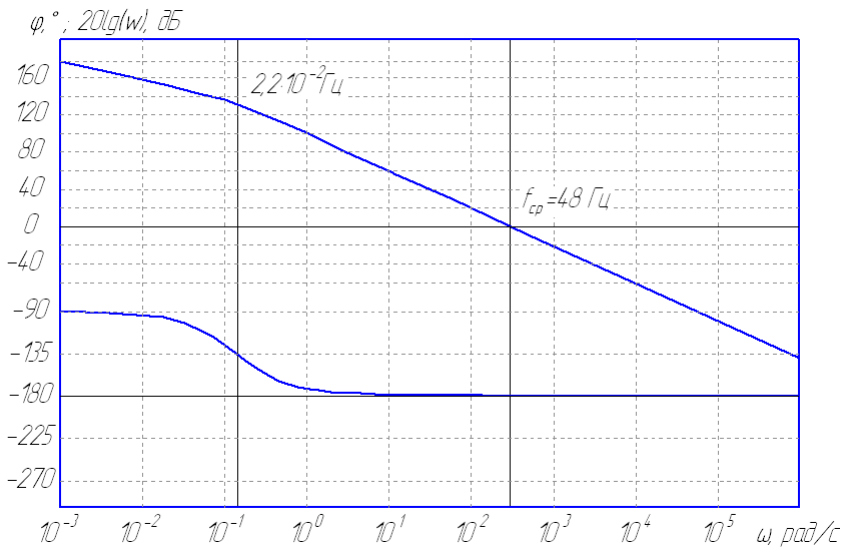
[picture p45: figure]

ЛФЧХ не пересекает уровень | , а лишь стремится к нему. Запас по фазе
в данном случае стремится к нулю ( | ), а запас по амплитуде ,напротив,
стремится к бесконечности ( | ). Также как и в канале внутренней оси
система находится на границе устойчивости и требует коррекции. Это можно подтвердить экспериментально построив график переходного процесса средствами компьютерного моделирования.

Переходной процесс нескорректированной системы:

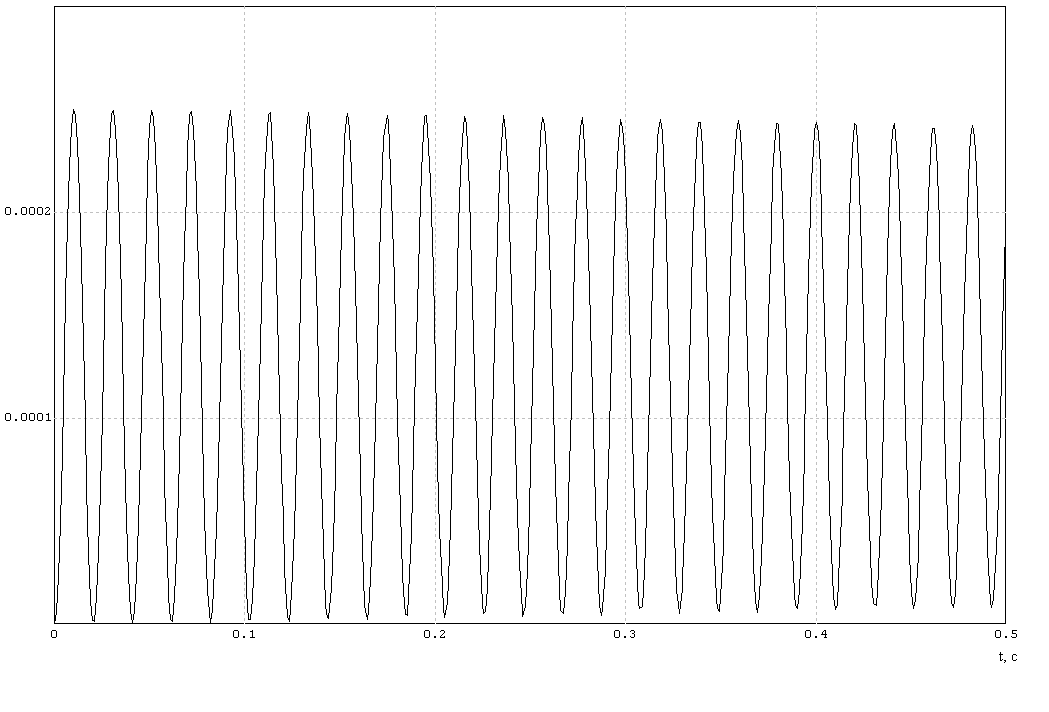
[picture p46: figure]

Чтобы увеличить запас по фазе, необходимо ввести корректирующее

дифференцирующее звено

Wäèô (S) = T1íàð

- S +1
. Если правильно выбрать

постоянные времени T1 нар и Т2 нар , мы обеспечим необходимый запас устойчивости и, тогда на частоте среза ЛАЧХ будет пересекать ось 0 дБ под наклоном –20 дБ/дек. Введением апериодического звена

1

1
( )
2 íàð · +

=
T | S
W | S àïåð | на несколько большей частоте вернем систему в

исходное состояние. Также для подавления возникающих в контуре обратной связи высокочастотных помех введем ещѐ одно апериодическое звено

1

1
( )
3 íàð · +

=
T | S
W | S àïåð
. Т3 вн выберем меньше Т2 нар .

Постоянные времени корректирующего звена:

Передаточная функция такого корректирующего звена будет иметь вид:

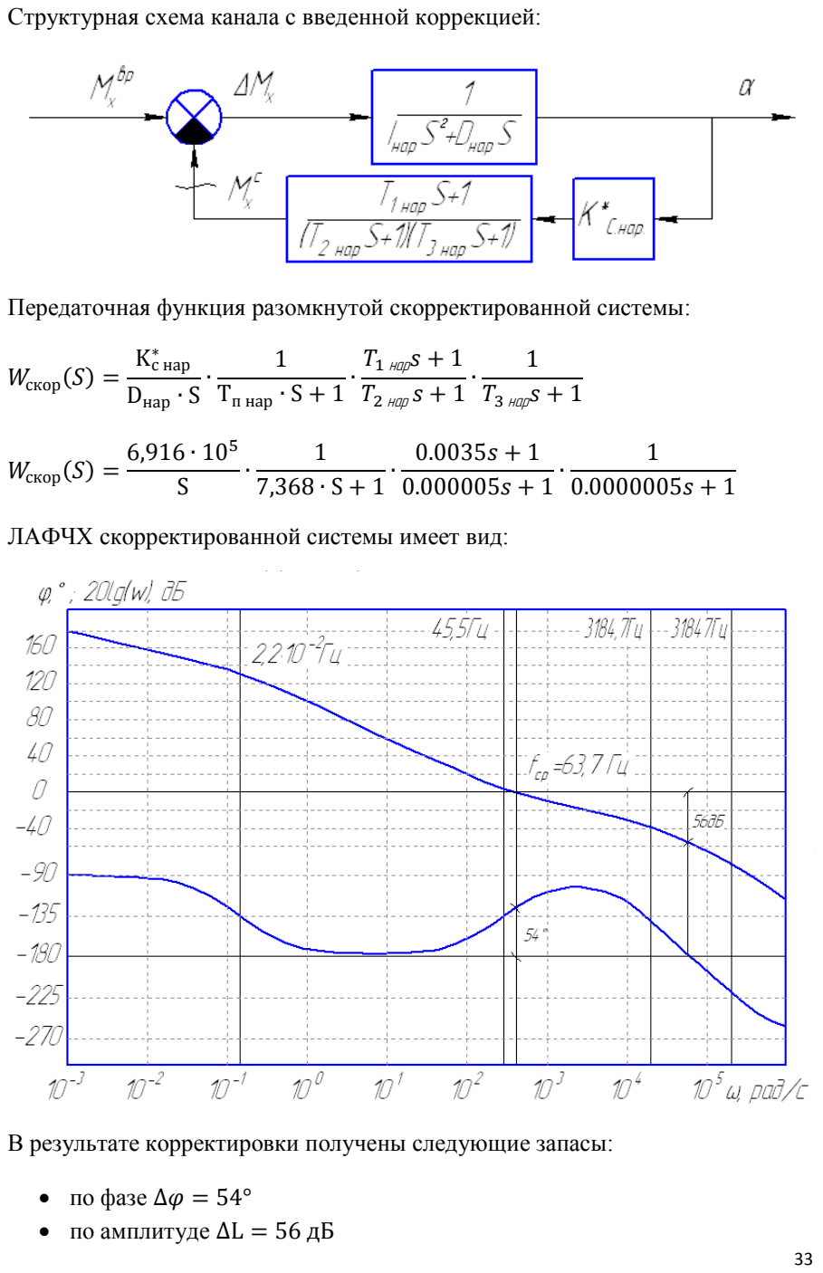
[picture p47: page 32]

Структурная схема канала с введенной коррекцией:

Передаточная функция разомкнутой скорректированной системы:

( )

( )

ЛАФЧХ скорректированной системы имеет вид:

В результате корректировки получены следующие запасы:

- по фазе
- по амплитуде

Переходный процесс скорректированной системы:

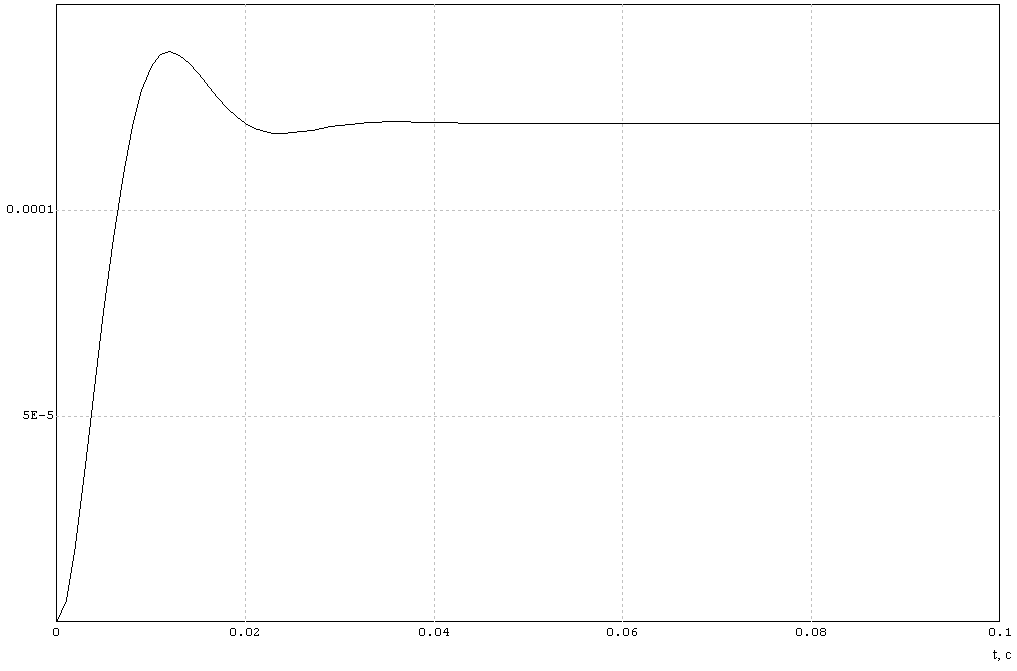
[picture p48: figure]

Переходной процесс устойчив. Время регулирования

Величина перерегулирования

По результатам эксперимента можно сделать вывод, что корректировка достигла своей цели.

Таким образом, полученная ошибка стабилизации по внутренней оси:

Так как установившееся значение ошибки меньше заданной по ТЗ, можно утверждать, что требования ТЗ по точности выполнены.

Вычисление коэффициента подавления колебаний

По заданию качка основания происходит на частоте | с амплитудой
по закону: | ( ), где | .

Коэффициент подавления – это отношение амплитуды колебаний основания, к амплитуде колебаний ОС, вызванных колебаниями основания.

Для вычисления коэффициента подавления необходимо построить ЛАЧХ замкнутой системы, на входе которой будет угол поворота основания, а на выходе угол поворота объекта стабилизации.

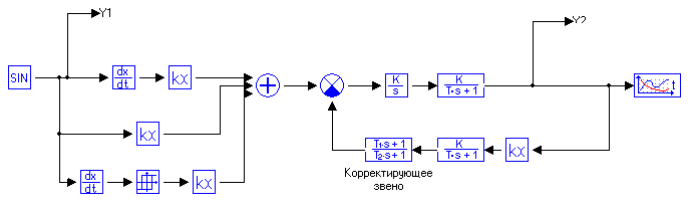
[picture p49: figure]

В данной схеме

- звено моделирующее демпфирующий момент
- звено моделирующее момент тяжения токоподводов
- звено моделирующее момент трения

С помощью этих звеньев моделируются моменты передающие движение основание на объект стабилизации.

Передаточная функция замкнутой системы:

( )

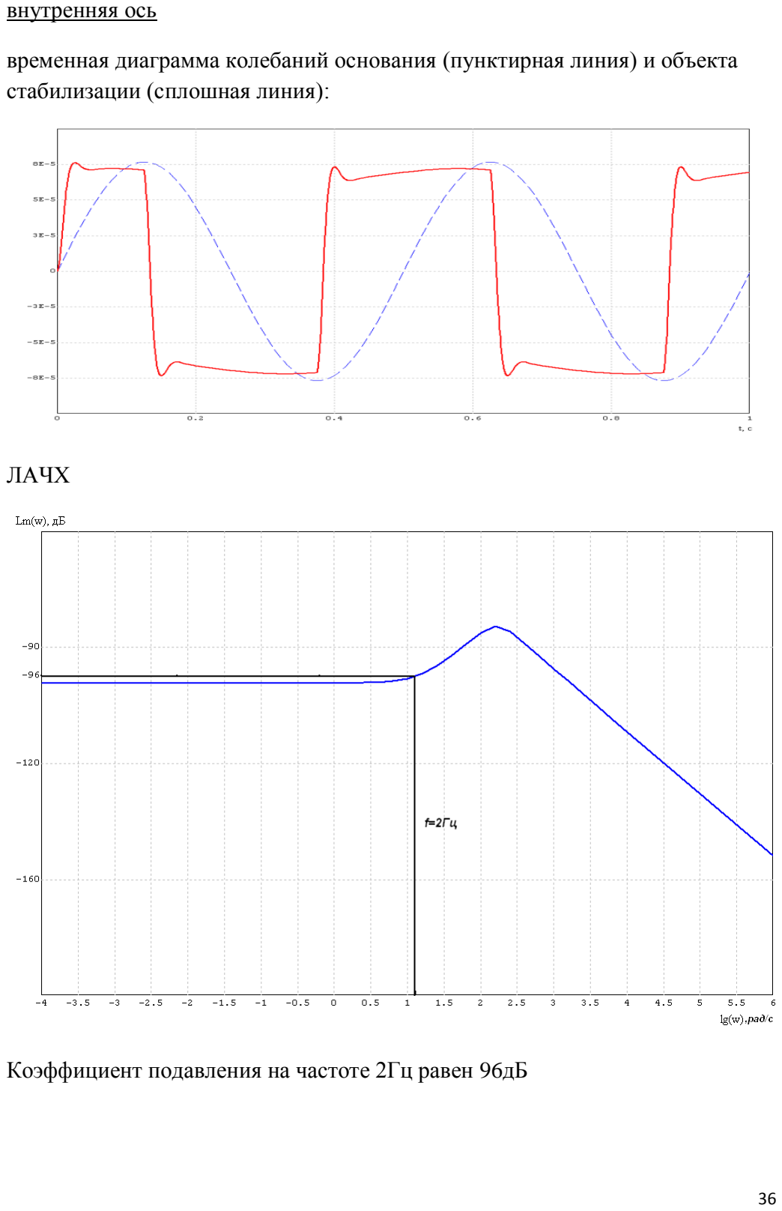
[picture p50: page 35]

внутренняя ось

временная диаграмма колебаний основания (пунктирная линия) и объекта стабилизации (сплошная линия):

ЛАЧХ

Коэффициент подавления на частоте 2Гц равен 96дБ

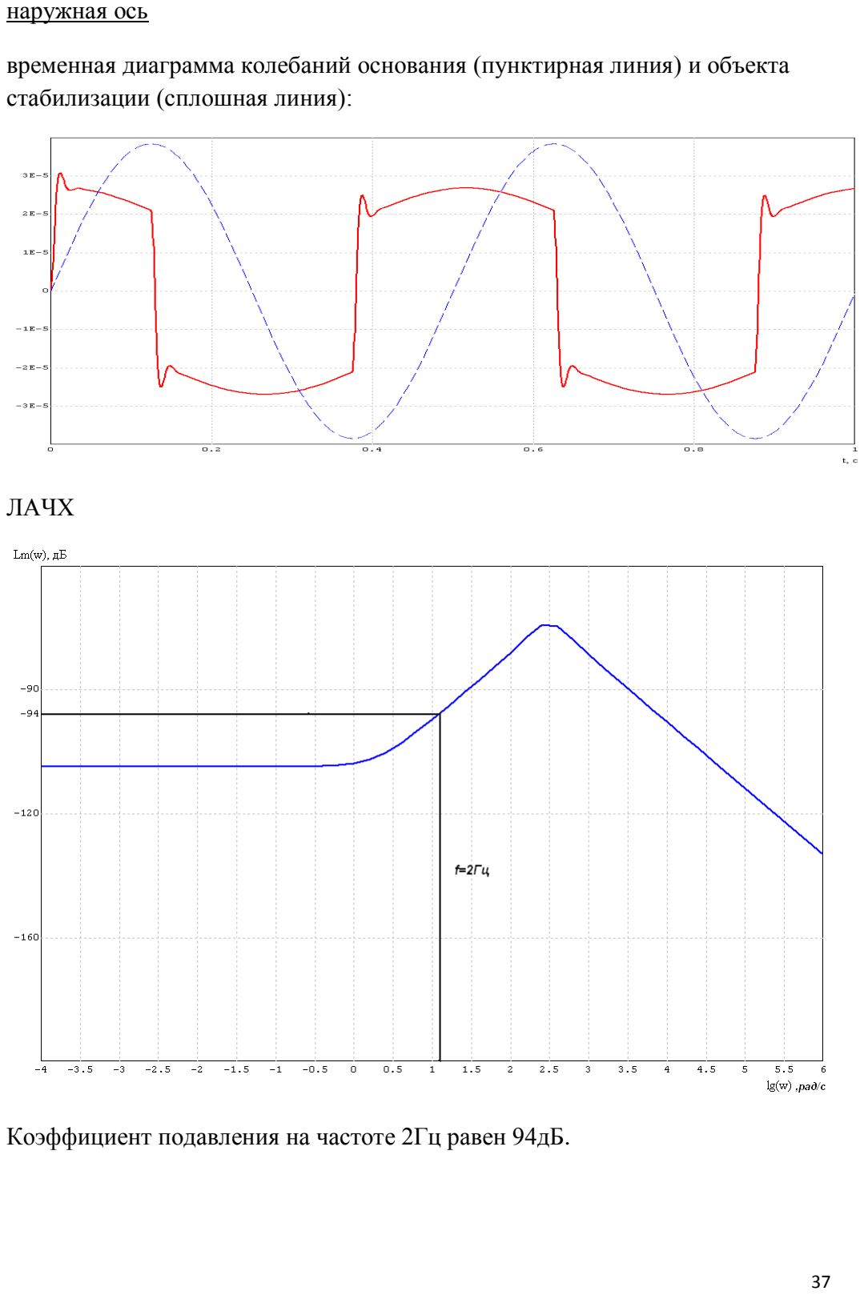
[picture p51: page 36]

наружная ось

временная диаграмма колебаний основания (пунктирная линия) и объекта стабилизации (сплошная линия):

ЛАЧХ

Коэффициент подавления на частоте 2Гц равен 94дБ.

Расчет электрической цепи корректирующего звена

Реализовать необходимые для коррекции звенья можно на пассивных и на активных элементах. Схемы на пассивных элементах не удовлетворяют требованиям точности. Поэтому реализовывать корректирующие звенья будем на операционных усилителях по следующей схеме:

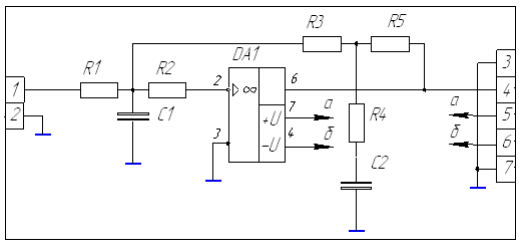
[picture p52: figure]

Данная схема представлена на принципиальной электрической схеме в блоках А12 и А13.

Рассчитаем номинальные значения элементов.

Для схемы справедливы следующие соотношения:

1

( | )( | 1)
4 | 2
3 | 5 | 4 | 2 | 3 5 | 2
1 | 2 | 1 | 2 | 1

+

+ | + +
=
= | + | + · | ·

R C s

R | R R C s | R R C s
Z

Z R R R R C s

îñ

âõ

Приведем передаточную функцию к виду:

( | 1)( | 1)
( | 1)
( )
2 | 3
| 1
+ | +
| +
= | =
T s | T s T s
K
Z

Z
W s

âõ

îñ

3 | 5
4 | 2
3 | 5
1 | 2 | 1 | 2
4 | 2 | 1
3 | 5 | 1 | 2
( | ) | 1
()
( | 1)( | 1)
RR R C | s
R | R Ws | R | R | R R R C s | C s
R | R | R | R
+ | +
+
=
+
+ | · | +
+ | +

Выразим постоянные времени и коэффициент усиления через параметры схемы:

2
3 | 5

3 5
1 | 4 | 2 | C
R | R

R R
T R C
+

= +

T2

= R4 | C2

1
1 | 2
1 | 2
3 | C
R | R

R R
T | ·
+

=

1 | 2
3 | 5
R | R
R | R
K
+

+
=

Данная система допускает бесчисленное число возможных комбинаций решений, т.к. для определения семи неизвестных используются только три линейно независимых уравнения. Поэтому зададимся значением емкости C2, а также примем равенство сопротивлений R1=R2=R3=R5=R. Тогда выражения для вычисления номинальных значений элементов примут следующий вид:

Коэффициент усиления корректирующего звена при этом К=1.

расчет корректирующего звена канала наружной оси

Постоянные времени корректирующего звена:

Полагаем С2=500 нФ тогда:

расчет корректирующего звена канала внутренней оси

Постоянные времени корректирующего звена:

Полагаем С2=100 нФ тогда:

Описание электрической схемы

Блоки А1 и А2 представляют собой волоконно-оптические гироскопы типа ВГ949П, питание которых осуществляется постоянным напряжением 5В. Съем сигнала дифференцированный. Поэтому сигнальные провода скручиваются и экранируются от общего провода питания.

Сигнал с А1 и А2 поступает на предварительные дифференциальные усилители (ПУ) А5 и А6, которые усиливают сигнал и делают его не симметричным. С выхода ПУ сигнал подается на выходной разъем XS1 – выход прибора по угловой скорости, а также сигнал подается на вход интеграторов А7 и А8, в которых сигнал об угловой скорости с ВОГ преобразуется в сигнал об угле поворота. После интегрирования сигнал поступает на корректирующие усилители, для изменения частотных характеристик.

Блок А3 представляет собой координатор цели (КЦ), питание которого является двуполярное постоянное напряжение. Выходом КЦ являются несимметричные сигналы об угле рассогласования между линией визирования и направлением на цель.

Сигнал с А3 поступает для усиления и преобразования на преобразователи А3 и А4.

Сигналы с А12,А13 и А3,А4 вычитаются в устройствах вычитания А10 и А11, для обеспечения слежения за целью. Далее разностный сигнал усиливается в усилителях мощности А15 и А16.

С усилителя мощности канала внутренней оси А16 сигнал поступает на датчик момента М1.

С усилителя мощности канала наружной оси А15 сигнал поступает на сумматор А9, который предназначен для добавления к сигнальному напряжению напряжения подпора. Суммарный сигнал с выходов А9 подается на двигатели разгрузки М2 и М3.

Датчики угла В1 и В2 представляют собой синусно-косинусные вращающиеся трансформаторы СКТ265, со статоров которых снимается сигнал пропорциональный синусу и косинусу относительных углов поворота осей корданова подвеса. Сигналы с СКТ подаются на разъем XS1.

Питание прибора осуществляется от источника постоянного тока 27В. Далее это напряжение поступает в источник питания А14, который преобразует его в питающие напряжения необходимые для работы элементов прибора, а именно: питание ВОГ, питание операционных усилителей, напряжение подпора, напряжение питания СКТ (36В 400Гц), питание усилителей мощности, питание координатора цели.

Расчет технологической части проекта

Выбор организационной формы сборки.

Различают стационарную и подвижную сборки. В свою очередь, стационарная сборка может быть поточной и непоточной.

Непоточная сборка выполняется по принципу концентрации и частичной дифференциации.

В первом случае сборочный процесс выполняется одним или несколькими рабочими на одном сборочном посту. Такая форма сборки применяется в единичном и опытном производствах. Во втором случае сборочный процесс разделяют на сборку отдельных сборочных единиц и общую сборку по схеме сборочного состава изделия. Второй способ находит применение в серийном и массовом производстве.

При поточной неподвижной сборке каждый рабочий или бригада рабочих в технологической последовательности, переходя с объекта на объект, с соблюдением определенного такта сборки выполняет свою операцию. Эту форму сборки применяют для прибором больших габаритов и(или) массы.

Подвижную сборку применяют в поточном производстве; она бывает со свободным и с принудительным движением собираемого изделия. Сборка с принудительным движением собираемого изделия разделяется на подвижную сборку непрерывного движения и подвижную сборку периодического движения. При сборке с принудительным движением собираемого изделия такт выпуска t (мин) определяется по формуле:

где F – фонд рабочего времени за плановый период, мин; N - программа

выпуска за плановый период. В приборостроении, в основном, применяют подвижную поточную сборку.

При выборе организационной формы сборки необходимо руководствоваться следующими соображениями:

Стационарная сборка применяется в индивидуальном и мелкосерийном производстве и в серийном, когда затрачиваемое на сборку время значительно меньше ритма (такта).

t

F
N

Если время сборки узла кратно ритму, но по технологическим соображениям процесс сборки нельзя разделить на отдельные операции, то сборка выполняется на нескольких рабочих местах параллельно. В этом случае рабочие места дублируют друг друга, и сборка получается стационарной независимо от программы выпуска.

В массовом и серийном производствах во всех тех случаях , когда время сборки прибора превышает ритм со значительной кратностью, целесообразно применять поточную сборку, так как она является наиболее совершенной формой организации сборочных работ.

При соответствующем подборе различных объектов сборки, имеющих однотипные процессы, поточная сборка становится экономически целесообразной и в условиях мелкосерийного производства.

При определении организационной формы сборки, прежде всего, должен быть сделан выбор между поточной и непоточной сборкой.

В соответствии с представленными выше определениями, выбираем непоточную стационарную сборку, а именно по принципу концентрации, т.е сборочный процесс выполняется одним или несколькими рабочими на одном сборочной посту (стенде), а также к сборочному посту подаются необходимые детали, покупные узлы и необходимые материалы. Такая форма применяется в единичном производстве.

Построение технологической схемы сборки.

Сборка изделия – дискретный во времени процесс, который состоит из отдельных переходов.

Переход – наименьшая законченная часть технологического процесса , выполняемая без перерыва во времени.

Сборочная операция – упорядоченный набор переходов.

Первым этапом разработки маршрутного технологического процесса сборки является построение технологической схемы сборки.

Процесс сборки изделия состоит из операций, выполняемых не только последовательно, но и параллельно, а иногда и с циклами. Технологическая схема сборки является графической интерпретацией такого процесса.

Наиболее ясно и полно отражают технологический процесс сборки схемы с базовой деталью. При построении технологической схемы сборки используются условные обозначения.

Правила построения технологических схем сборки:

- На условном изображении элемента в нижней половине указывается номер позиции по чертежу; в верхней половине – количество одинаковых элементов. На условном изображении материала указывается марка материала. Покупные изделия штрихуются в верхней половине.
- Технологическая схема сборки начинается с изображения базовой детали или базовой сборочной единицы, выполняющей в данной конструкции роль корпуса или основания, а заканчивается изображением собранного изделия.
- Сборочные единицы или детали, собираемые одновременно, присоединяются к линиям сборки в одной точке.
- Несколько деталей или сборочных единиц, устанавливаемых после их предварительной сборки, но без образования сборочной единицы, присоединяются к дополнительной линии сборки в последовательности их соединения; дополнительная линия сборки подводиться к основной в точке операции, на которой формируется сборочная единица с другими элементами изделия.
- Сборочная единица, формируемая параллельно с основным изделием, строится на дополнительной линии сборки; а дополнительная линия сборки подводится к основной в точке сборки этой сборочной единицы с основным изделием.
- Стрелка показывает направление сборки. При частичной разборке стрелка направлена от операции к элементу.
- Знаки контрольных и регулировочных операций подводятся к линии сборки непосредственно после той, относительно которой они производятся.
- Определяющий диаметр знака - 10 мм.
- Схема сборки представляет собой графическое изображение в виде условных обозначений последовательности сборки изделия или его составной части (ГОСТ 23887-79). Схема облегчает разработку ТП благодаря наглядности и обозримости последовательности сборки. Основой для разработки процесса сборки и его схемы является схема расчленения изделия – разделение его на сборочные единицы и детали с расположением их относительного расположения. Эта схема раскрывает структуру изделия, его расчлененность на составные части, последовательность сборки, возможности организации сборочного процесса. Наличие технологически независимых составных частей позволяет собирать их параллельно, что сокращает цикл сборки. Кроме того, составные части поступают на общую сборку после контроля качества их сборки. Это позволяет быстрее обнаружить дефекты общей сборки, которые следует в данном случае искать в соединениях составных частей, а не внутри их. Большая расчлененность изделия на сборочные единицы при достаточной величине объема выпуска позволяет организовать сборку поточным методом.

Схема с базовой деталью (базовой сборочной единицей) нагляднее отображает последовательность сборки. В качестве базовой выбирается деталь (сборочная единица), поверхности которой будут впоследствии использоваться при установке готового изделия или при креплении сборочной единицы к ранеt собранным сборочным единицам. Направление движения деталей и сборочных единиц показано стрелками. На схеме сборки могут быть приведены дополнительные надписи или условные обозначения, характеризующие содержание операции. Указания могут быть даны и в виде таблицы, тогда на схеме проставляется лишь номер указания.

Для сложного изделия целесообразно составлять укрупненную схему сборки, характеризующую общую сборку изделия и схемы сборки составных частей изделия, соответствующих узловой сборке.

Построение схем сборки следует начинать с простейших сборочных единиц, затем переходить к более сложным. При расчленении изделия на составные части следует руководствоваться следующими положениями:

- схемы строятся с максимальным расчленением изделия на сборочные единицы независимо от программы выпуска изделий;
- выделение того или иного соединения в сборочную единицу должно быть целесообразно и в технологическом отношении;

Последнее означает, что сборочные единицы можно отдельно собирать, контролировать, хранить и транспортировать. Если по условию организации сборочного процесса, например, при поточной сборке неизбежно расчленение сборочных единиц с нарушением независимости их сборки, приходится вводить временные сборочные единицы. Для них предусматривают приспособления, сохраняющие правильность взаимного расположения деталей во время сборки транспортировки с одного рабочего места на другое. Временные сборочные единицы вводятся в схему сборки и выделяются особым обозначением (по ГОСТ 23887-79).

Расчет коэффициентов технологичности конструкции прибора

Показатели технологичности конструкции приборов разработаны на ос-новании ГОСТ 14201-73…14203-73, методики Госстандарта СССР, ОСТ и обобщения опыта по отработке и оценке технологичности конструкции изделий.

Данные показатели применены к конструкции отдельных функциональных элементов, используемых в САУ и измерительных комплексах. Они определяются на этапе рабочего проектирования и входят в комплект документации на изделие, передаваемое в серийное производство.

Технологичным является такое изделие, которое при условии выполнения всех технических требований более удобно в эксплуатации и позволяет при данной серийности производства изготовить его с минимальными затратами труда, материалов и с наименьшим производственным циклом.

Исходя из этого положения строится методика определения показателей технологичности конструкции приборов. Основная идея методики заключается в том, что технологичная конструкция изделия обеспечивает наибольшую производительность труда, снижение затрат и сокращение времени на проектирование, технологическую подготовку производства, изготовление, техническое обслуживание и ремонт изделия при обеспечении необходимого его качества.

Показатели технологичности используются для:

а) количественной оценки технологичности конструкции прибора перед передачей его в серийное производство;

б) указания конструкторам требований по технологичности при выдаче задания на проектирование нового прибора.

Система показателей содержит:

а) базовые частные коэффициенты, к которым относятся коэффициенты освоенности Kосв, унификации деталей Куд и унификации материалов Кум;

б) комплексный коэффициент технологичности Ктех .

Выражения для определения значений всех частных показателей технологичности должны для «идеального» прибора стремиться к 1; фактические значения частных показателей технологичности К должны находиться в пределах 0 < К < 1.

Значения коэффициентов определяются на основе анализа технической документации на изделие (сборочного чертежа и спецификации). Для расчета коэффициентов Куд, Kосв составляется таблица:

Общее количество деталей (без крепежных) | В том числе | Количество крепежных деталей
собственные | заимство-ванные | стандартные | покупные
nΣ | nсб | nзм | nст | nпок | nкр
NΣ | Nсб | Nзм | Nст | Nпок | Nкр

В таблице n - число наименований деталей в изделии;

N - общее число деталей в изделии.

Примечания:

1. К стандартным относятся детали, охваченные ГОСТом и ОСТом, отраслевой нормалью.
2. К заимствованным относятся детали, взятые из других аналогичных разработок, и детали, изготовляемые по стандартам предприятий (СТП).
3. К собственным относятся детали, которые применяются только в данном приборе и на которые разработаны чертежи в проекте на прибор.
4. Сборочные единицы, полученные армированным литьем или прессова-нием из пластмасс, принимаются за одну деталь.

5. К крепежным деталям относятся гайки, винты, болты, шпильки, заклепки и т.п., а также монтажные провода, товарные знаки, изоляционные прокладки и т.п..

Заполним таблицу с помощью спецификации:

Общее количество деталей (без крепежных) | В том числе | Количество крепежных деталей
собственные | заимство-ванные | стандартные | покупные
32 | 24 | 0 | 4 | 4 | 19
55 | 40 | 0 | 8 | 7 | 92

Коэффициенты освоенности прибора и унификации его деталей определяются по формулам:

Коэффициент освоенности:

(8 0 7)/ 55 0,27

( | )/
= | + + | =
= | + | + | Σ

îñâ

îñâ | ñò | çì | ïîê
K
K | N | N | N | N

Коэффициент унификации:

1 (32 19)/(55 92) 0,65

1 ( | )/( | )
= - | + | + | =

= - Σ

+ | Σ

+

óä

óä | êð | êð
K
K | n | n | N | N

Коэффициент унификации материалов К определяется только для собственных деталей прибора по формуле:

сб

ум
n

С
K

Σ
= 1-

где

СΣ - количество сорторазмеров материалов для изготовления

собственных деталей прибора;

n

∑ -общее число наименований собственных деталей приборов;

Сорторазмер обусловлен маркой материала и определяющим размером. Для

определения

Kум
составляется таблица:
Количество | Металлы | Пластмассы | Керамика | Сумма
черные | цветные | драгоценные

Сортораэмеров
материалов
3 | 1 | - | 2 | - | 6

Собственных
деталей
13 | 9 | - | 2 | - | 24

Тогда коэффициент унификации материалов

0,75
24

6
=1- | =1- | =

Σ

ñá

óì
n

Ñ
K

Комплексный коэффициент технологичности определяется как произведение

базовых частных коэффициентов

Kòåõí = Kîñâ

·Kóí

·Kóì
= 0,27·0,65·0,75 = 0,13

Расчет сборочной размерной цепи

В приборах, работающих на разных физических принципах, имеются механические сборочные единицы. К геометрическим параметрам этих единиц (например, осевой зазор в опорах чувствительных элементов, колебание зазора между магнитопроводами ротора и статора в электродвигателях и датчиках и др.) предъявляются точностные требования. Эти точностные требования совместно с размерами отдельных деталей , от которых они зависят, образуют замкнутые размерные цепи.

Размерная цепь (РП) в соответствии с РД 50-635-87 – совокупность взаимно связанных линейных размеров, образующих замкнутый контур.

Размерные цепи отражают объективные размерные связи в конструкции прибора в технологических процессах изготовления его деталей и сборки.

Звено РЦ – один из размеров, образующих РЦ.

Замыкающее звено – звено РЦ , являющееся исходным при постановке задачи или получающееся последним в результате ее решения.

Составляющее звено – звено РЦ , функционально связанное с замыкающим звеном.

Увеличивающее звено – составляющее звено РЦ, с увеличением которого замыкающее звено увеличивается (т.е. для которого передаточная функция ξi=dF/dXi > 0).

Уменьшающее звено – составляющее звено РЦ, с увеличением которого замыкающее звено уменьшается ( т.е. для которого ξi < 0).

Компенсирующее звено – составляющее звено РЦ , изменением которого достигается требуемая точность замыкающего звена.

Общее звено- звено, одновременно принадлежащее нескольким РЦ.

Схема РЦ – графическое изображение РЦ.

Задачи и методы расчета размерных цепей :

Прямая задача - задача, в которой заданы параметры (номинальное значение, допустимые отклонения и т. д.) замыкающего звена РЦ и требуется найти параметры ее составляющих звеньев.

Обратная задача - задача, в которой известны в один и тот же момент времени параметры (допуски, поля рассеяния, координаты их середин и т.д. ) составляющих звеньев РЦ и требуется определить параметры замыкающего звена.

Решением обратной задачи проверяется правильность решения прямой задачи.

Статическая задача - задача, решаемая без учета факторов, влияющих на изменение звеньев РЦ во времени.

Динамическая задача - задача, решаемая с учетом факторов, влияющих на изменение звеньев РЦ во времени.

Метод расчета на максимум-минимум - метод расчета, учитывающий только предельные отклонения звеньев РЦ и самые неблагоприятные сочетания.

Вероятностный метод расчета - метод расчета, учитывающий рассеяние размеров и вероятность различных сочетаний отклонений составляющих звеньев РЦ.

Для различных методов достижения точности замыкающего звена необходимо применить различные методы расчета РЦ.

Размерные цепи, для которых оказывается экономически оправданным риск возможного выхода за пределы поля допуска замыкающих звеньев и части изделий, рассчитывают вероятностным методом.

В РЦ, в которых должна быть обеспечена полная взаимозаменяемость, допуски рассчитывают по методу максимума - минимума.

В ряде случаев возможны сочетания различных методов достижения точности замыкающего звена данной РЦ.

Метод расчета: Максимума/Минимума

Размерная цепь:

A1: Тип - | Номинал = 210.000 | Квалитет js10 | es = 0.092 | ei = -0.092
A2: Тип - | Номинал = 6.000 | Квалитет js8 | es = 0.013 | ei = -0.013
A3: Тип - | Номинал = 58.100 | Квалитет js7 | es = 0.015 | ei = -0.015
A4: Тип - | Номинал = 81.100 | Квалитет js10 | es = 0.07 | ei = -0.07
A5: Тип - | Номинал = 58.100 | Квалитет js7 | es = 0.015 | ei = -0.015
A6: Тип + | Номинал = 6.000 | Квалитет js8 | es = 0.013 | ei = -0.013

Замыкающее звено:

X: Номинал = 0.700 | es = 0.218 | ei = -0.218

Метод расчета: Вероятностный

Распределение: Нормальное

Коэффициент: 3.000

Размерная цепь:

A1: Тип - | Номинал = 210.000 | Квалитет js10 | es = 0.092 | ei = -0.092
A2: Тип - | Номинал = 6.000 | Квалитет js8 | es = 0.013 | ei = -0.013
A3: Тип - | Номинал = 58.100 | Квалитет js7 | es = 0.015 | ei = -0.015
A4: Тип - | Номинал = 81.100 | Квалитет js10 | es = 0.07 | ei = -0.07
A5: Тип - | Номинал = 58.100 | Квалитет js7 | es = 0.015 | ei = -0.015
A6: Тип + | Номинал = 6.000 | Квалитет js8 | es = 0.013 | ei = -0.013

Замыкающее звено:

X: Номинал = 0.700 | es = 0.091 | ei = -0.091

Заключение о соответствии техническому заданию

В результате проектирования двухосного индикаторного гиростабилизатора на базе волоконно-оптического гироскопа (ВГ949П) в соответствии с техническим заданием на разработку конструкции были получены следующие параметры гиростабилизатора:

- Максимальная статическая ошибка по оси наружной рамы

по оси платформы
;
- Коэффициент подавления колебаний не менее 94 дБ на частоте 2 Гц;
- Максимальные углы прокачки | по обоим осям
- Обеспечены запасы устойчивости
по наружной оси:
- по фазе ,
- по амплитуде 56 дБ
по внутренней оси:
- по фазе ,
- по амплитуде 48,8 дБ
- Чувствительный элемент – ВГ949П.
- Обеспечен съем сигналов об угловой скорости линии визирования.
- Подвес наружный карданов.
- Привод редукторный по наружной оси и редукторный безлюфтовый по внутренней

Таким образом можно сделать вывод, что полученный стабилизатор удовлетворяет условиям технического задания.

Список используемой литературы.

1. Пельпор Д. С. Гироскопические системы. Ч.1,2,3.
2. Пельпор Д. С. Гироскопические системы. Проектирование гироскопических систем.Ч.1.
3. Сломянский Г. А. Детали и узлы гироскопических приборов. Атлас конструкций.
4. Востриков А.С., Французова Г.А. Теория атоматического регулирования.
5. Соловьев Г.Н. Схемотехника.

# Приложения
