litvinoval/cursach/чертежи сем2/на печать/задание.pdf

# Двухосный индикаторный гиростабилизатор телекамеры для разведывательного БПЛА

Задано: | Получено:

### 1. Разработать конструкцию двухосного индикаторного

гиростабилизатора на базе чувствительного эллемента ВГ091
для обеспечения угловой стабилизации телекамеры для разведывательного БПЛА:
а) форма и размеры ОС: цилиндр 100мм и высотой 65мм
б) m=2.0 кг, IX

=IY

=230 cНсмс

2
, IZ

=240 cНсмс

2
Привод по внутренней оси - бескорпусной ДМ
по наружней оси - бескорпусной ДМ
2. Обеспечить максимальный угол прокачки ±40 3. Провести исследование устойчивости гиростабилизатора,

выбрать корректирующие звенья, обеспечить запасы устойчивости по амплитуде и фазе

### 4. Обеспечить установившуюся ошибку стабилизации не более 0,5' 5. Обеспечить максимальную угловую скорость управления 10/с

### 1. Разработана конструкция двухосного индикаторного стабилизатора

обеспечивающего угловую стабилизацию телекамеры для разведывательного БПЛА.

### 2. Конструктивно, применением механических ограничителей поворота

обеспечен максимальный угол пеленга цели по осям подвеса: ±40. 3. Обеспечены статические ошибки стабилизации

По оси наружной рамы: 0,34'
По оси платформы: 0,41'

### 4. Проведено исследование устойчивости гиростабилизатора, обеспечены

запасы устойчивости гиростабилизатора по амплитуде и по фазе:
По оси наружной рамы: L=31.6 дБ | =53 По оси платформы: | L=33 дБ | =53 5. Обеспечена максимальная скорость управления 10/с
Технологическая часть | Технологическая часть
Составить схему сборки по оси стабилизации. Рассчитать размерную цепь | Составлена схема сборки. Рассчитана размерная цепь.
Масса | Масштаб Изм. Лист | № докум. | Подп. | Дата | Лит. Разраб.

Пров.
Т.контр. | Лист | Листов
Н.контр. Утв. | 1 Техническое

задание Инв. № подл. Подп. и дата Взам. инв. № Инв. № дубл. Подп. и дата Справ. № Перв. примен.

Копировал | Формат A1
