litvinoval/cursach/V6/Accel_v6.stp

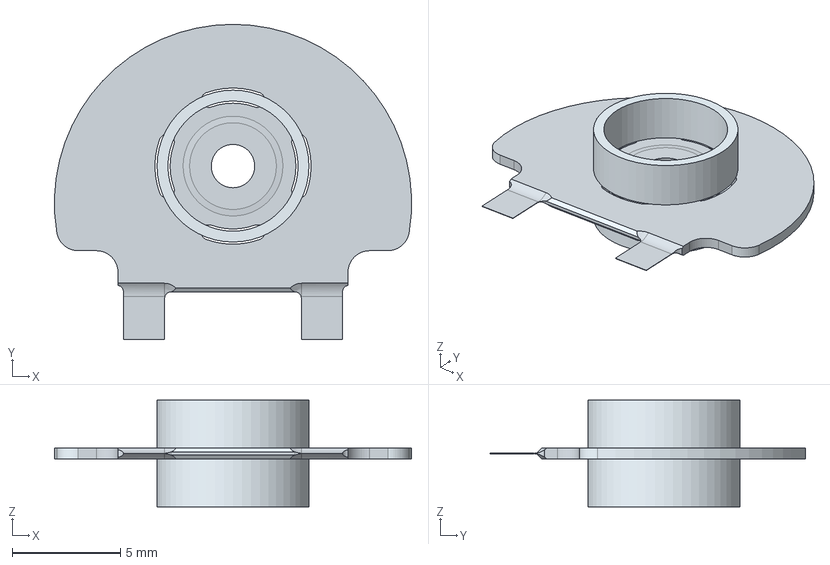
[picture p53: CAD file, 2023-05-01]
V6/Accel_v6.stp
16.5 x 14.5 x 4.91 mm
SolidBody
PROVOD_PETR_155_0_05_1 x 2
