litvinoval/cursach/V1/Accel_v1.stp

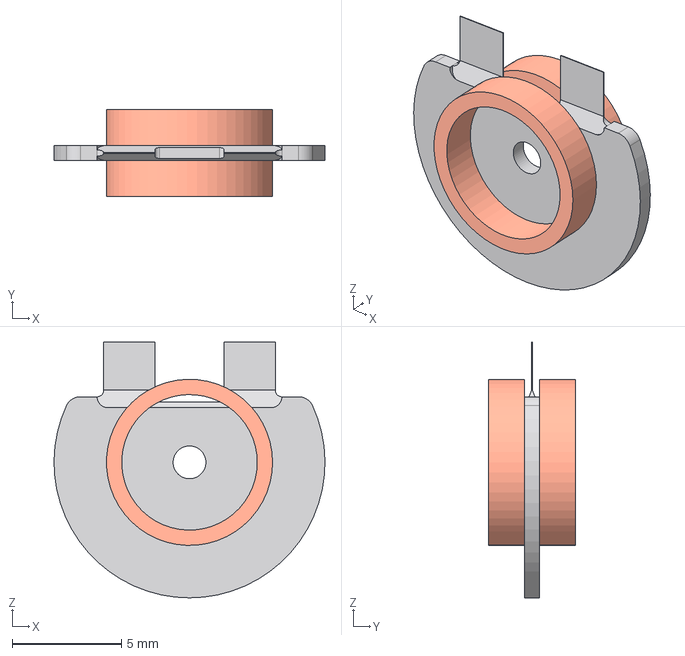
[picture p54: CAD file, 2023-05-01, an earlier design]
V1/Accel_v1.stp
12.4 x 4.00 x 11.7 mm
ChEl
Kat x 2
