litvinoval/cursach/V2/Accel_v2.stp

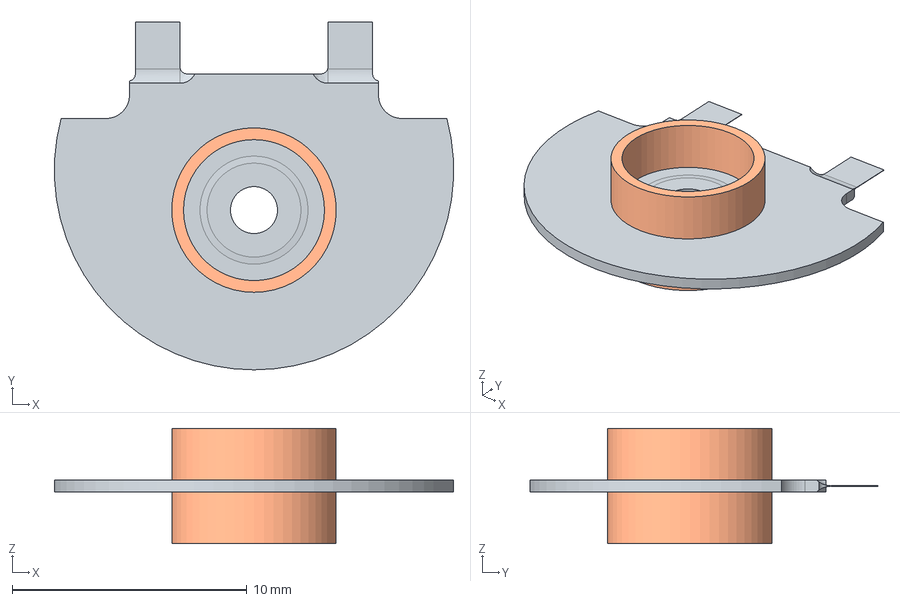
[picture p55: CAD file, 2023-05-01, an earlier design]
V2/Accel_v2.stp
17.0 x 14.8 x 4.91 mm
Mayatnik
PROVOD_PETR_155_0_05
PROVOD_PETR_155_0_05_1
