litvinoval/cursach/V3/Accel_v3.stp

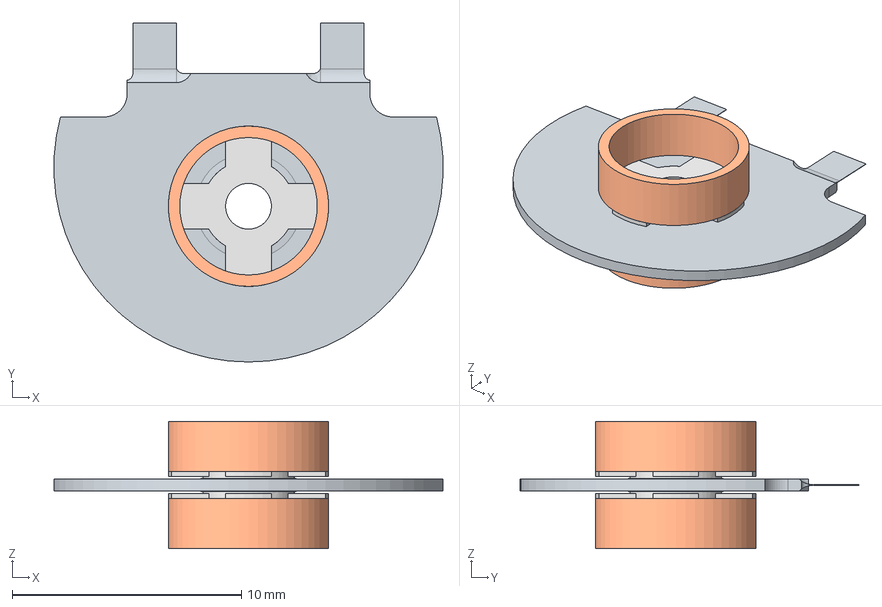
[picture p56: CAD file, 2023-05-01, an earlier design]
V3/Accel_v3.stp
17.0 x 14.8 x 5.56 mm
Mayatnik
PROVOD_PETR_155_0_05
PROVOD_PETR_155_0_05_1
Karkas x 2
