litvinoval/cursach/V4/Accel_v4.stp

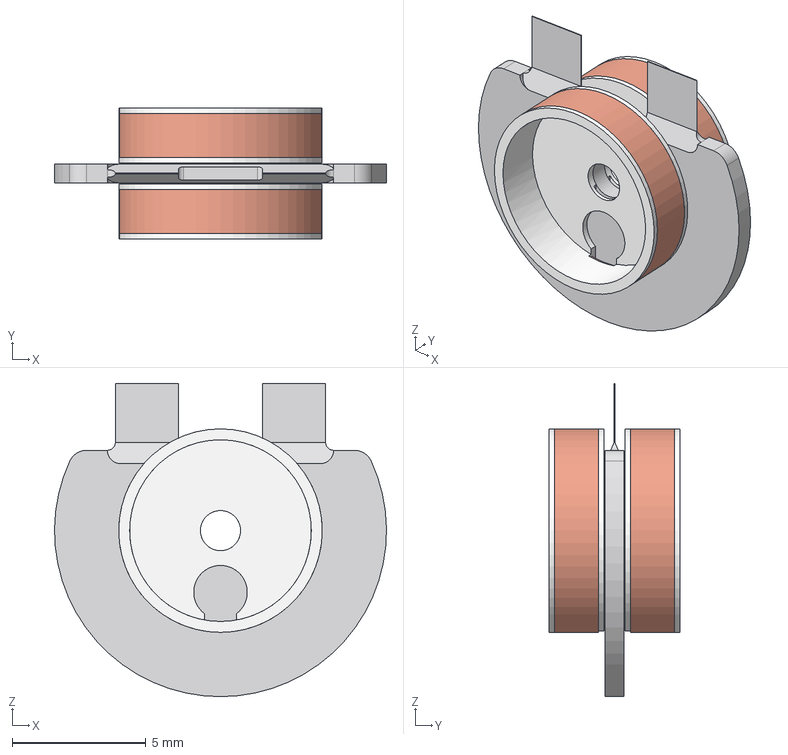
[picture p57: CAD file, 2023-05-01, an earlier design]
V4/Accel_v4.stp
12.4 x 4.90 x 11.7 mm
ChEl
Каркас x 2
Кутушка x 2
