litvinoval/cursach/V5/Accel_v5.stp

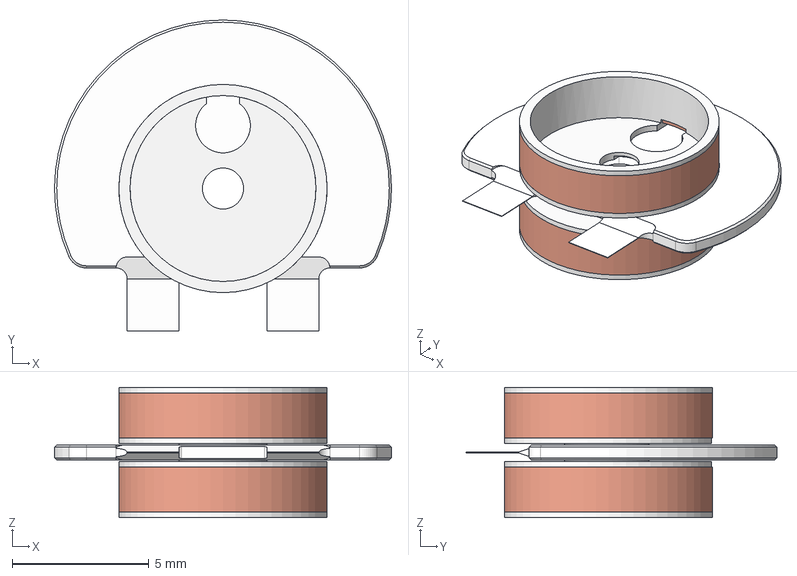
[picture p58: CAD file, 2023-05-01, an earlier design]
V5/Accel_v5.stp
12.3 x 11.4 x 4.76 mm
mayatnik
Каркас x 2
Кутушка x 2
