litvinoval/cursach/чертежи сем2/на печать/эл схема.pdf

## ДМх

## УМ х

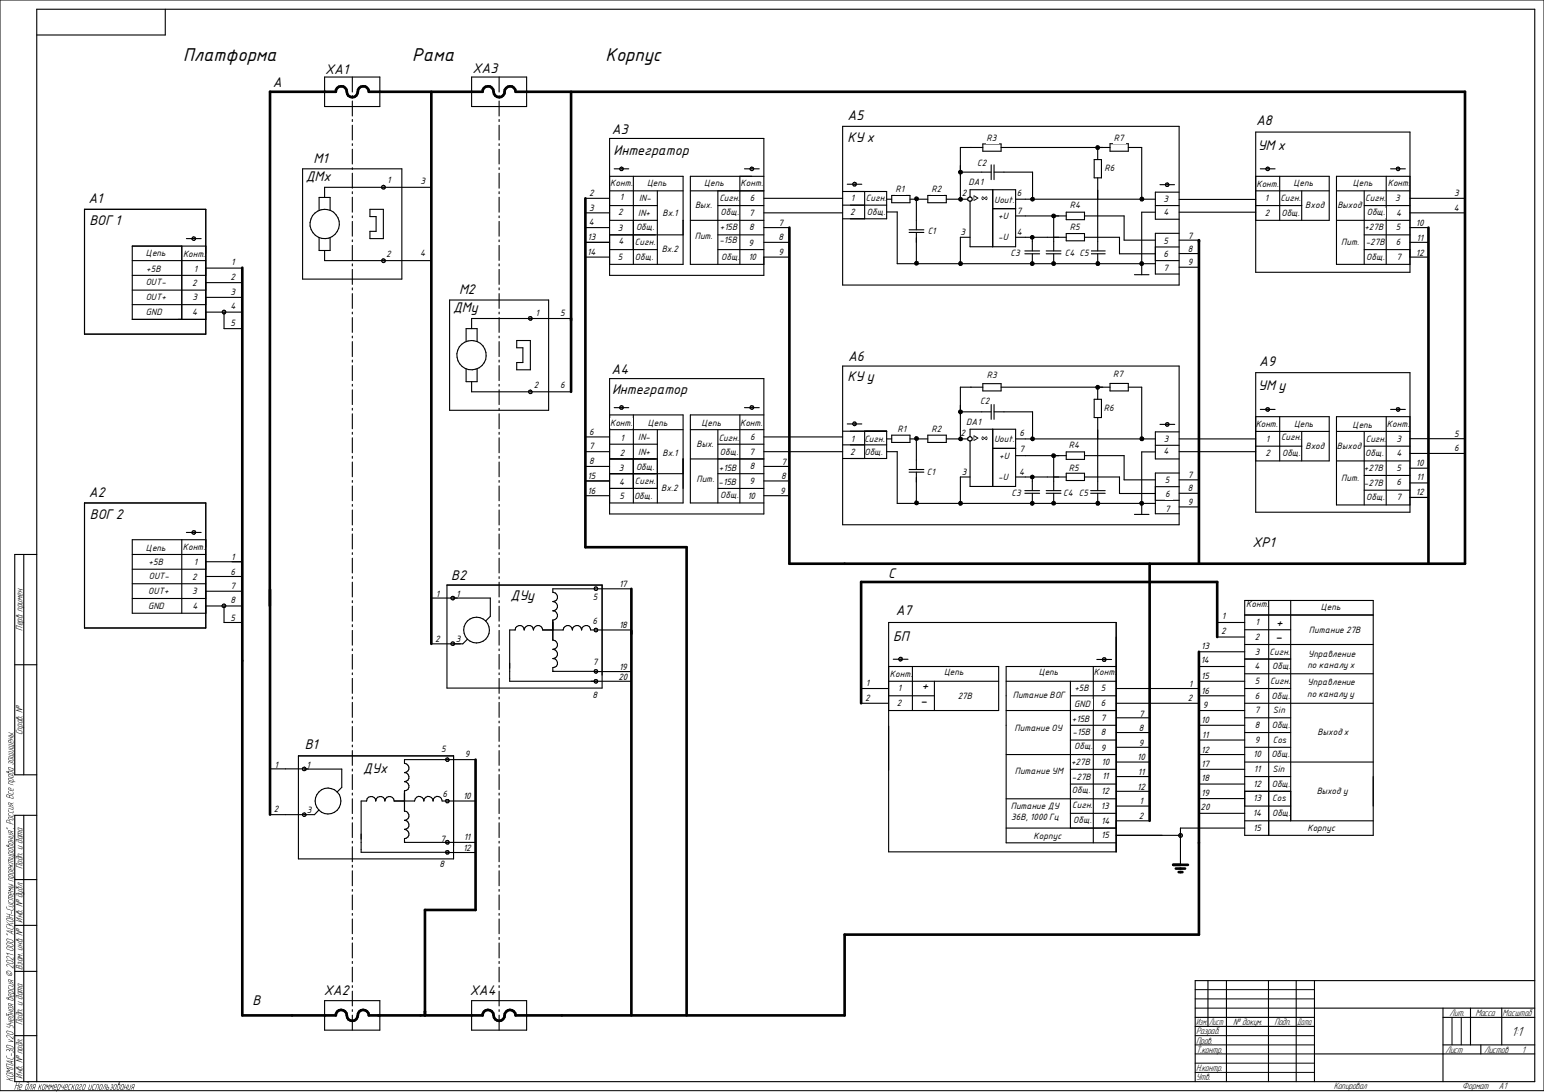
[picture p59: page 1]

OUT+
GND

Цепь | Конт.
+5В
OUT-

Общ.

78 | | Sin | Выход х

Общ. | 14

Корпус | 15

Разраб.
Пров.
Т.контр. | Лист | Листов
