litvinoval/cursach/ов.pdf

А | Б ВВ Г | Г | 255

240 15

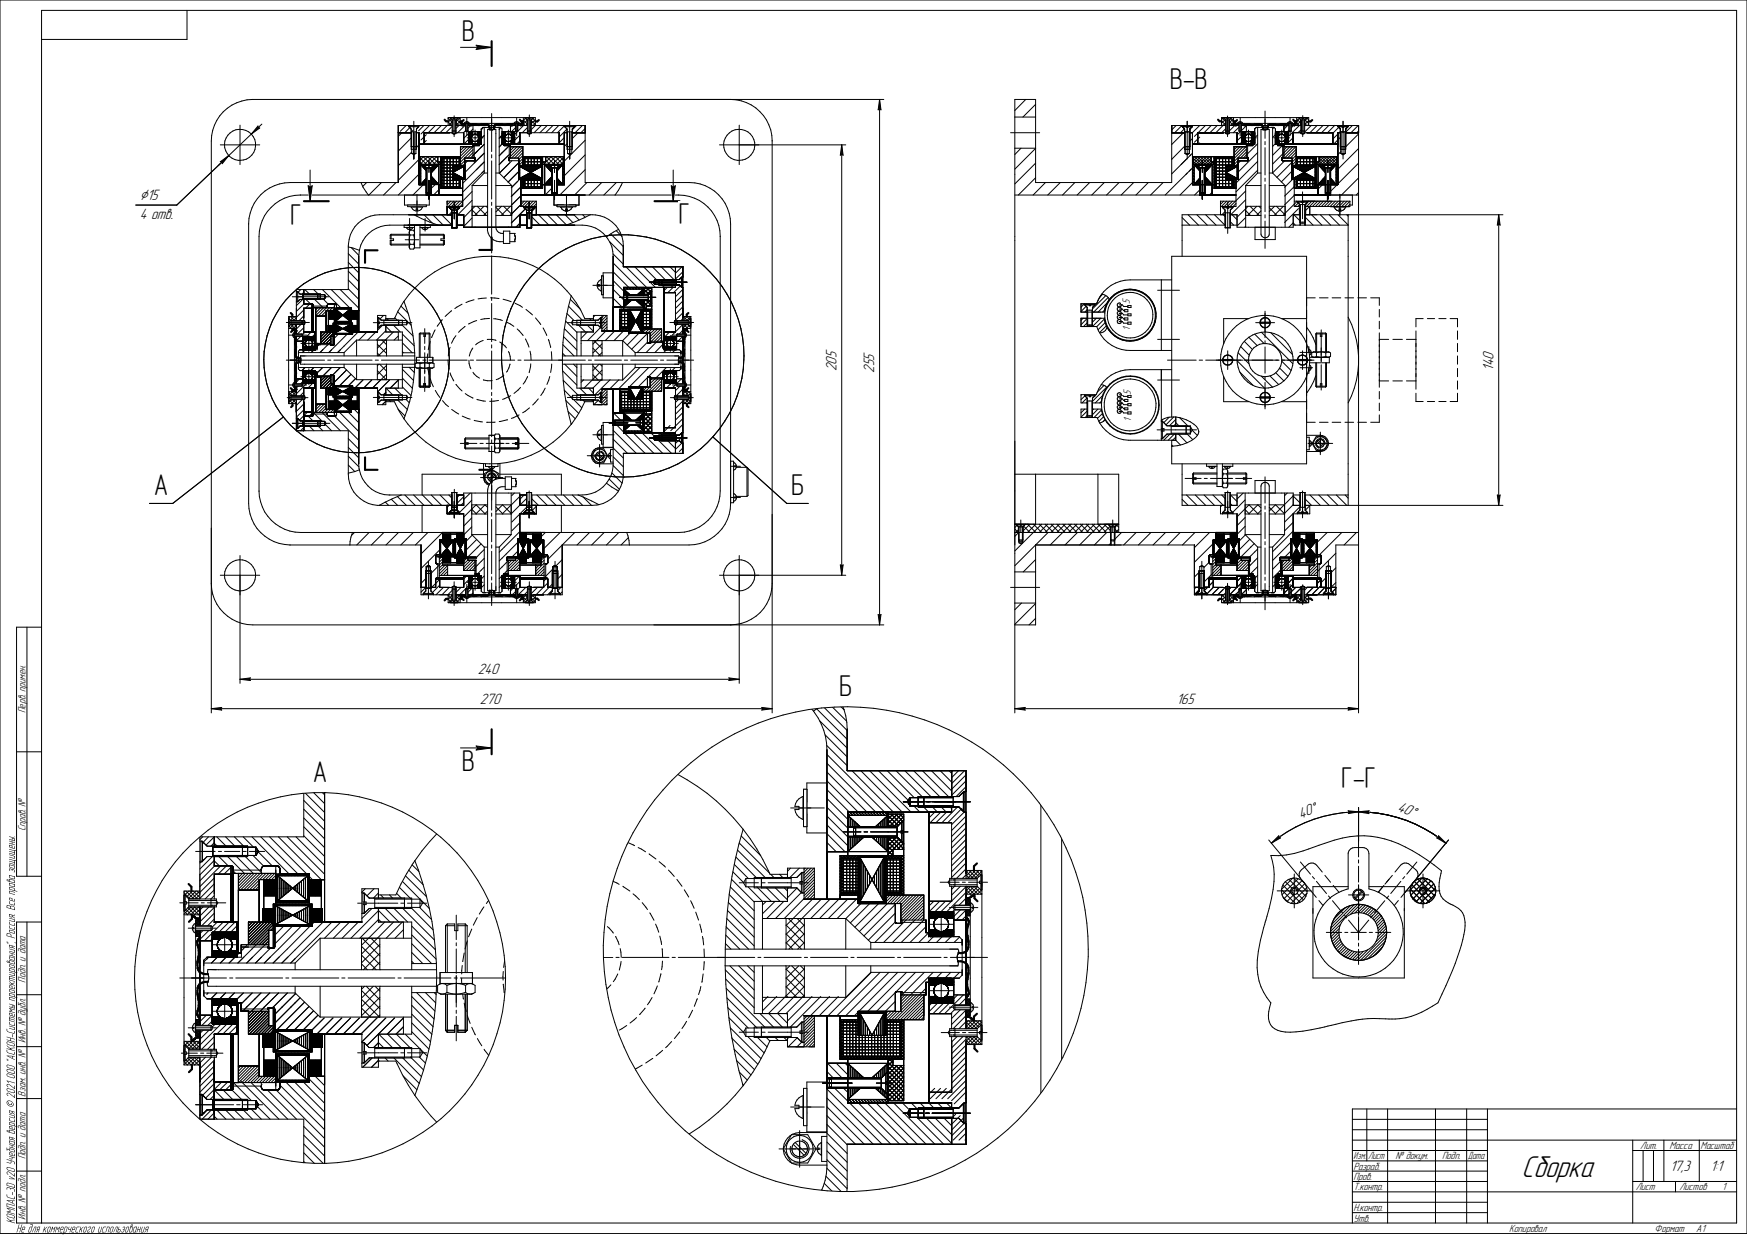
[picture p60: page 1]
4 отв. А; Масса Масштаб; Лит.; Т.контр.; Лист; Листов; Сборка; 17,3 Инв. № подл. Подп. и дата Взам. инв. № Инв. № дубл. Подп. и дата Справ. № Перв. примен.; Копировал; Формат A1

Изм. Лист № докум. Подп. Дата
Разраб.
Пров.
Н.контр.
Утв.
