litvinoval/cursach/эл схема.pdf

## ДМх

## УМ х

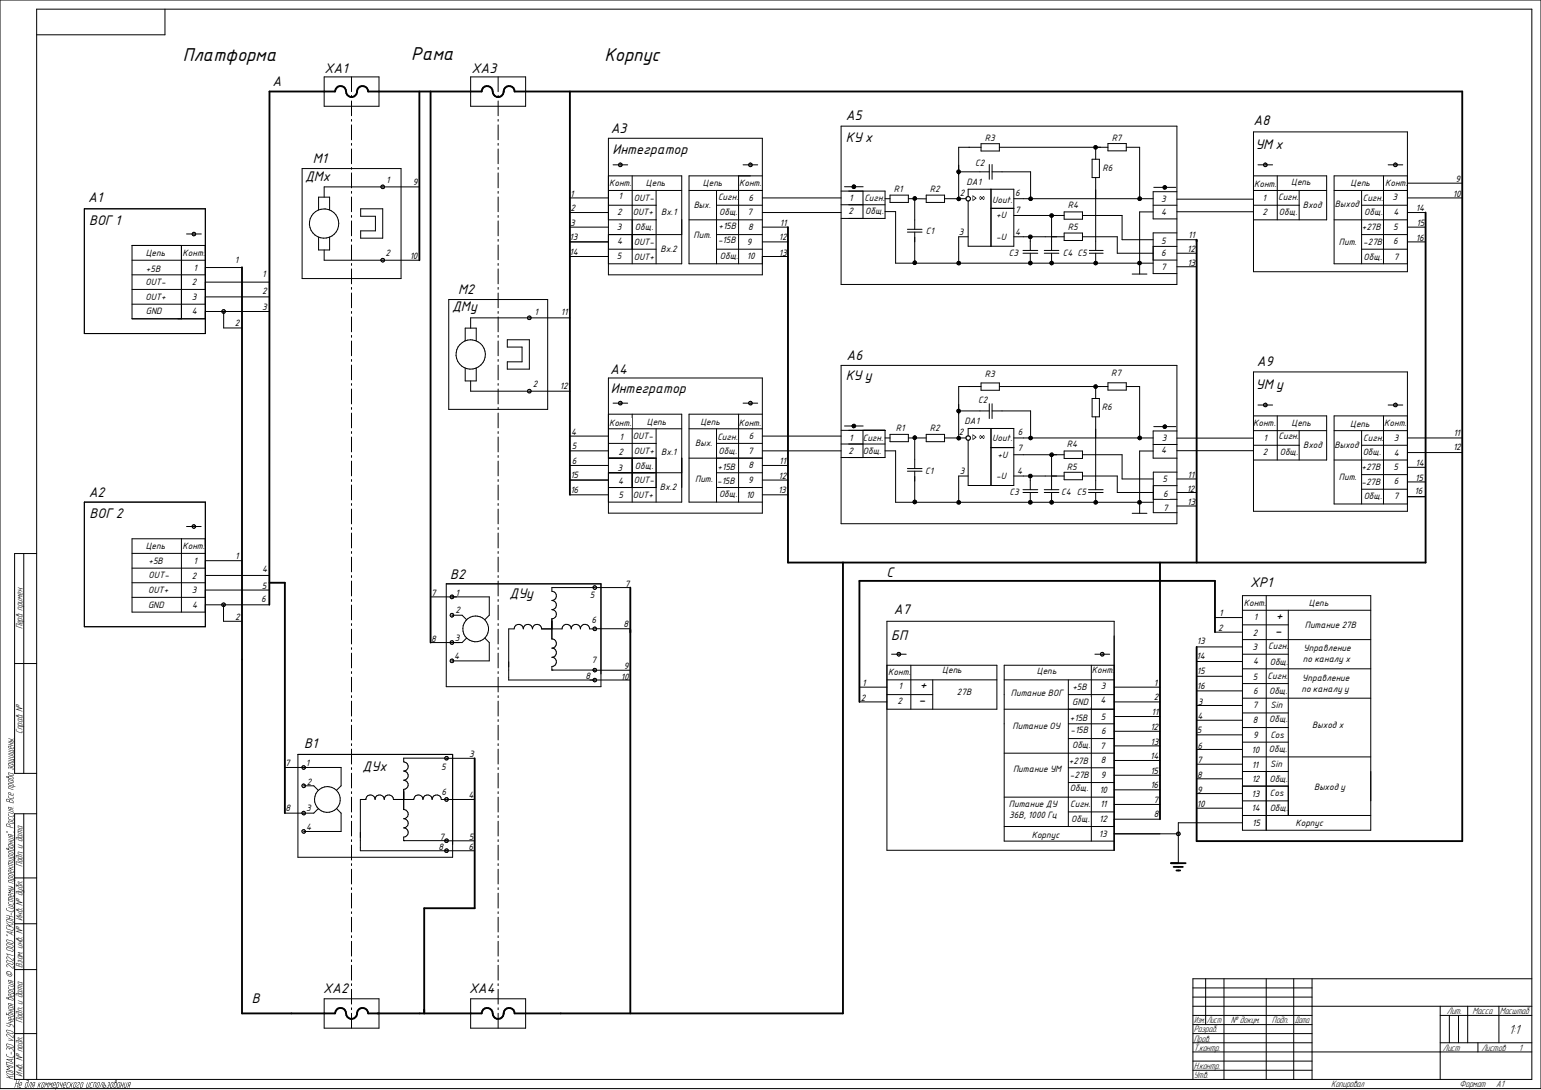
[picture p61: page 1]

OUT+
GND

+5В
OUT-

1:1 1 Инв. № подл. Подп. и дата Взам. инв. № Инв. № дубл. Подп. и дата Справ. № Перв. примен.

Сигн. | Цепь 123456789 Управление по каналу х

Питание 27В

Сигн. | Управление по каналу у
Общ.

Питание ОУ | +15В

-15В

Cos
10 | Общ.

-27В
Общ. | 10

12
13
14 | Общ.

Питание ДУ 36В, 1000 Гц | | 11

Корпус

Лит. | Масса | Масштаб

Изм. Лист | № докум. | Подп. | Дата
Разраб.
Пров.
Т.контр. | | | | Лист | Листов
Н.контр.
Утв.
