litvinoval/cursach/первый сем/кс.pdf

# ДУу

# ДМx

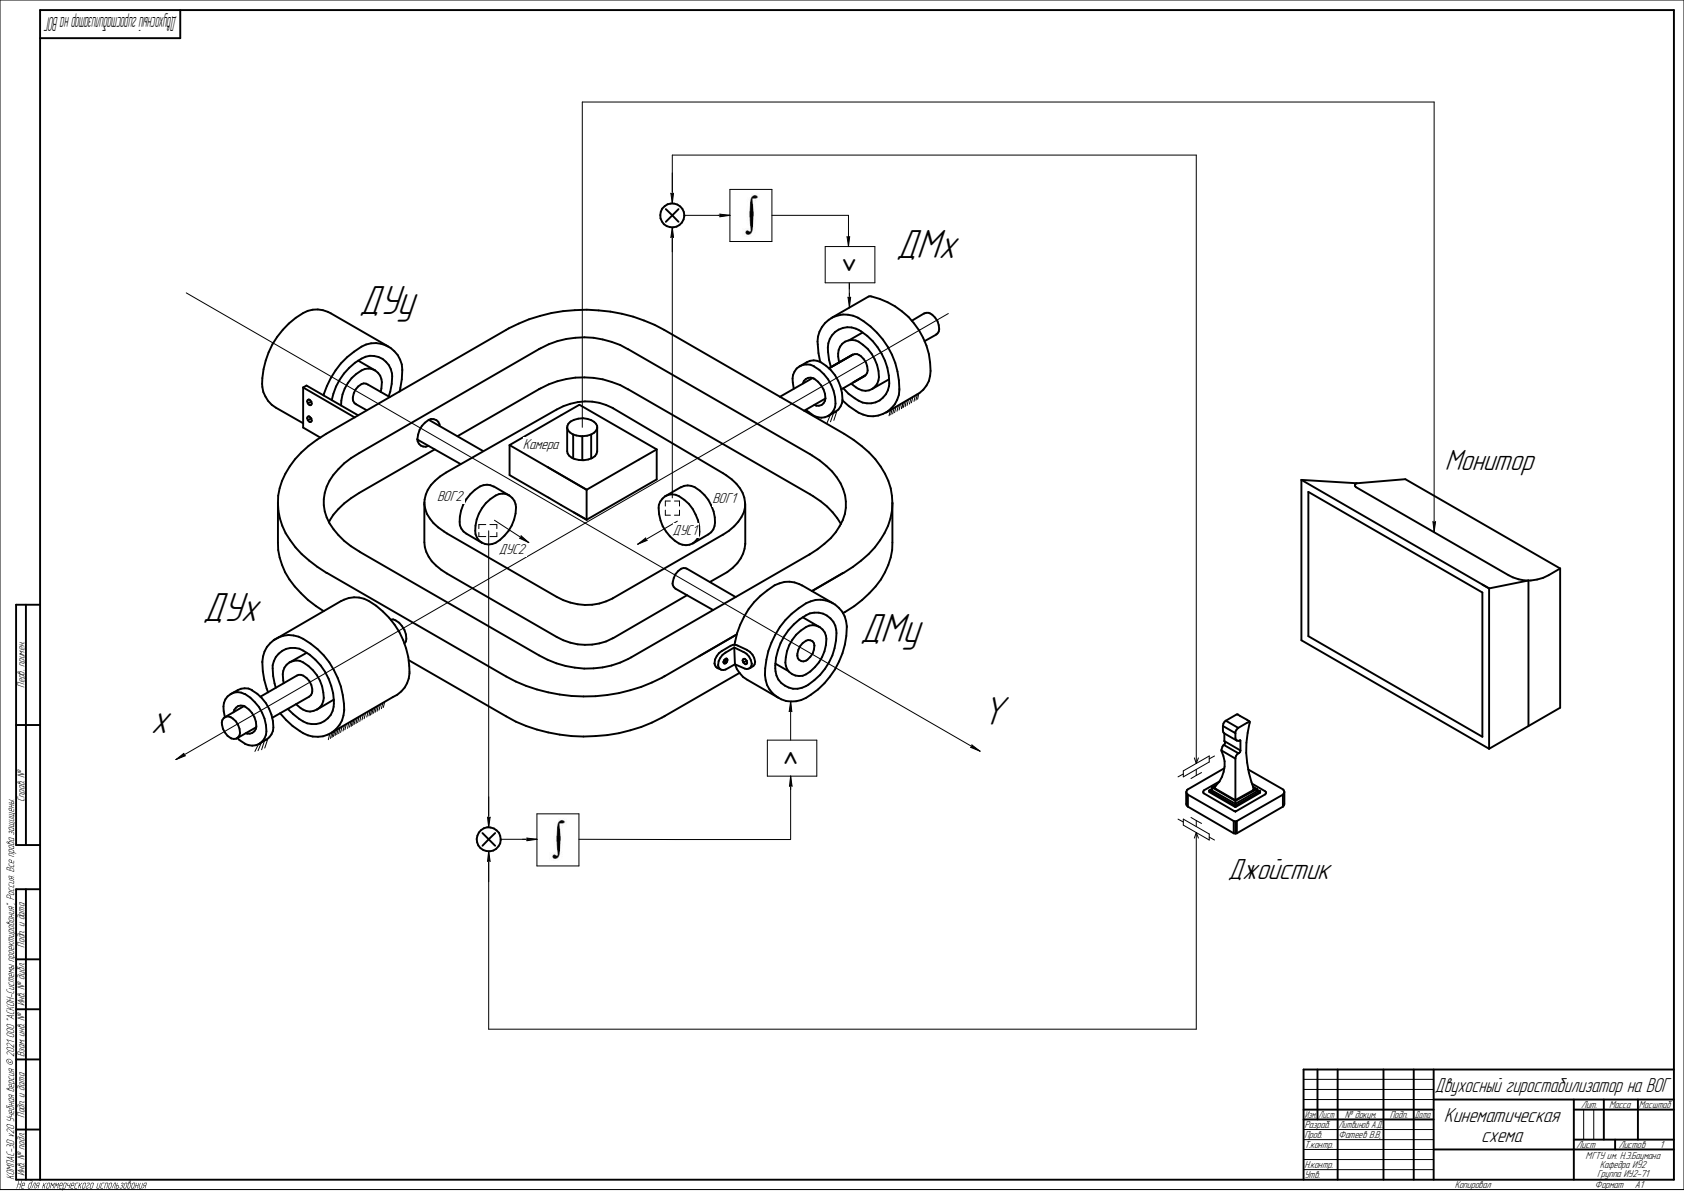
[picture p62: page 1]
ДМу; ДУх; ДУС2; ВОГ2; ДУС1; ВОГ1; Камера; Джойстик; Монитор; Масса; Масштаб Изм. Лист; № докум.; Подп.; Дата; Лит.; Кафедра ИУ2 Инв. № подл. Подп. и дата Взам. инв. № Инв. № дубл. Подп. и дата; Группа ИУ2-71 Справ. № Перв. примен.; Копировал; Формат A1

1 Двухосный гиростабилизатор на ВОГ
Кинематическая

Разраб. | | схема Литвинов А.Д.
Пров. | Фатеев В.В,
Т.контр. | | | Лист | Листов
Н.контр.
Утв.

МГТУ им. Н.Э.Баумана
