litvinoval/cursach/первый сем/структурная схема.pdf

1 JрS+DРS | R | 1 JпS² +DпS JпS²

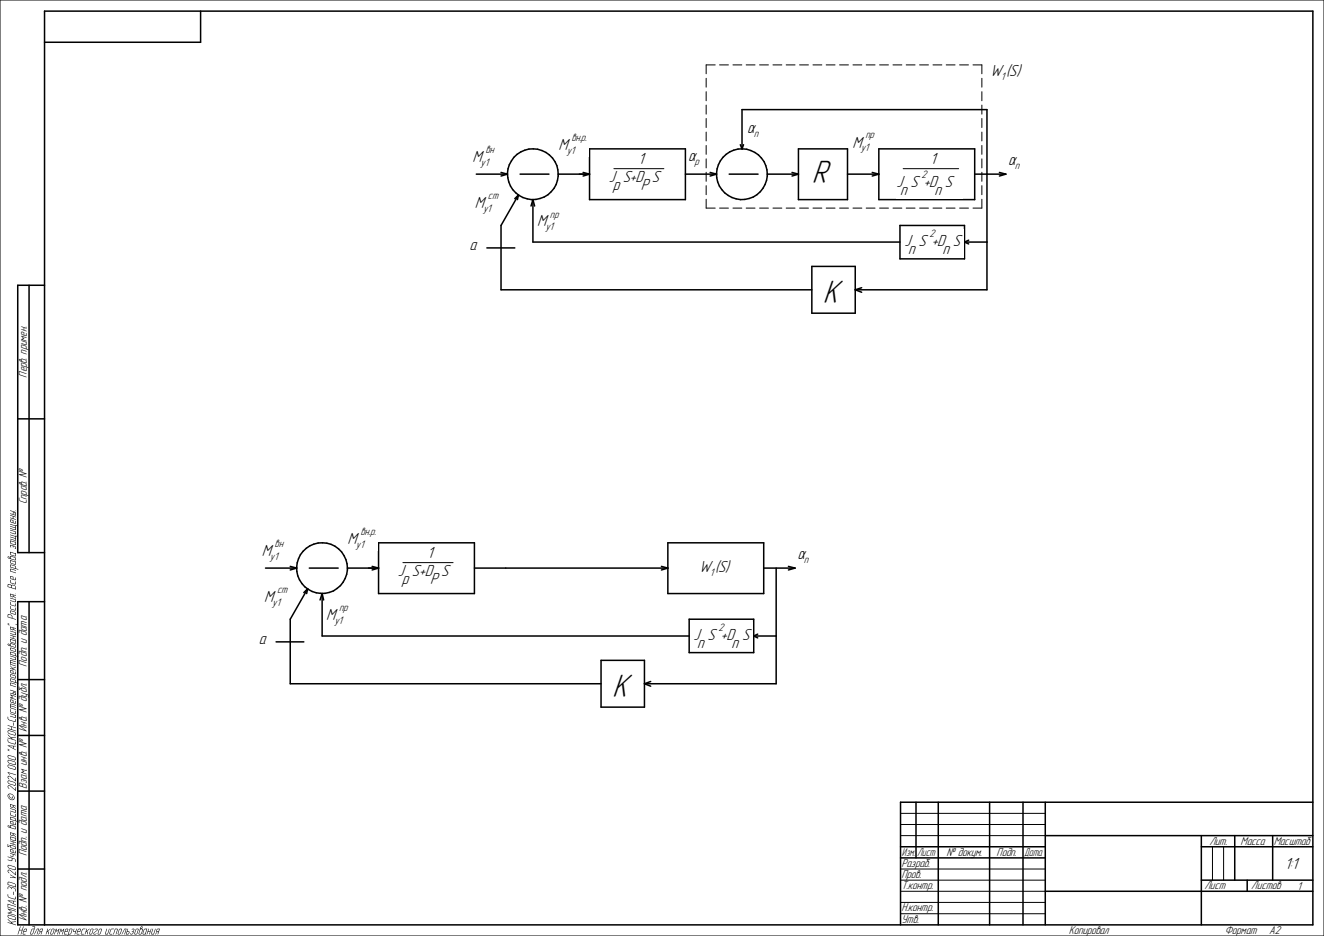
[picture p63: page 1]
+DпS K M; (S) 1 JрS+DРS; JпS²; 1:1 1 Инв. № подл. Подп. и дата Взам. инв. № Инв. № дубл. Подп. и дата Справ. № Перв. примен.; Копировал; Формат A2

Лит. | Масса | Масштаб

Изм. Лист | № докум. | Подп. | Дата
Разраб.
Пров.
Т.контр. | | | | Лист | Листов
Н.контр.
Утв.
