litvinoval/cursach/первый сем/чэ.pdf

# Габаритно-установочный чертеж Схема подключения

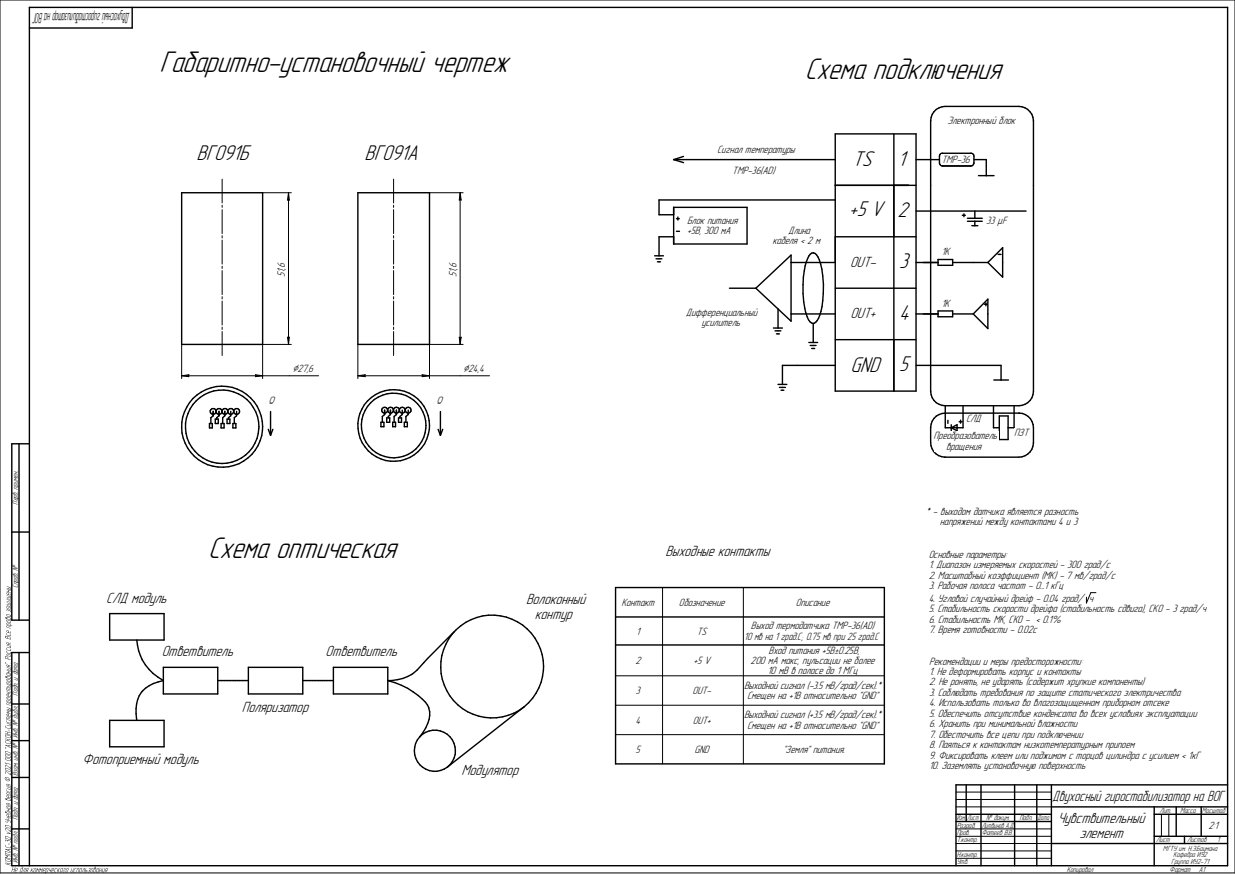
[picture p64: page 1]
Выходные контакты; Схема оптическая; Волоконный контур; Модулятор; Ответвитель; Поляризатор; Фотоприемный модуль; СЛД модуль; Преобразователь вращения; СЛД; ПЗТ; Электронный блок; Дифференциальный усилитель; Блок питания; Длина; кабеля < 2 м; TMP-36; Сигнал температуры; TMP-36(AD); Масса; Масштаб Изм. Лист; № докум.; Подп.; Дата; Лит.; Н.контр.; Утв.; Кафедра ИУ2 Инв. № подл. Подп. и дата Взам. инв. № Инв. № дубл. Подп. и дата; Группа ИУ2-71 Справ. № Перв. примен.; Копировал; Формат A1

OUT- | 3

напряжений между контактами 4 и 3 ⁵¹,6

OUT+ | 4

GND | 5

* - выходом датчика является разность

Основные параметры:
1. Диапазон измеряемых скоростей - 300 град/с
2. Масштабный коэффициент (МК) - 7 мв/град/с
3. Рабочая полоса частот - 0...1 кГц
4. Угловой случайный дрейф - 0.04 град/ ч
5. Стабильность скорости дрейфа (стабильность сдвига), СКО - 3 град/ч
6. Стабильность МК, СКО - < 0.1%
7. Время готовности - 0.02с

Контакт | Обозначение | Описание

1 | TS | Выход термодатчика TMP-36(AD) 10 мв на 1 град.С; 0.75 мв при 25 град.С

2 | +5 V | Вход питания +5В±0.25В, 200 мА макс, пульсации не более 10 мВ в полосе до 1 МГц

Рекомендации и меры предосторожности:
1. Не деформировать корпус и контакты
2. Не ронять, не ударять (содержит хрупкие компоненты)
3. Соблюдать требования по защите статического электричества
4. Использовать только во влагозащищенном приборном отсеке
5. Обеспечить отсутствие конденсата во всех условиях эксплуатации
6. Хранить при минимальной влажности
7. Обесточить все цепи при подключении
8. Паяться к контактам низкотемпературным припоем
9. Фиксировать клеем или поджимом с торцов цилиндра с усилием < 1кГ
10. Заземлять установочную поверхность

3 | OUT- | Выходной сигнал (-3.5 мВ/град/сек).* Смещен на +1В относительно "GND"

4 | OUT+ | Выходной сигнал (+3.5 мВ/град/сек).* Смещен на +1В относительно "GND"

5 | GND | "Земля" питания.

1 Двухосный гиростабилизатор на ВОГ
Чувствительный
элемент

Разраб. | Литвинов А.Д.
Пров. | Фатеев В.В.
Т.контр. | | Лист | Листов

МГТУ им. Н.Э.Баумана
