litvinoval/cursach/чертежи сем2/на печать/технология.pdf

1
13

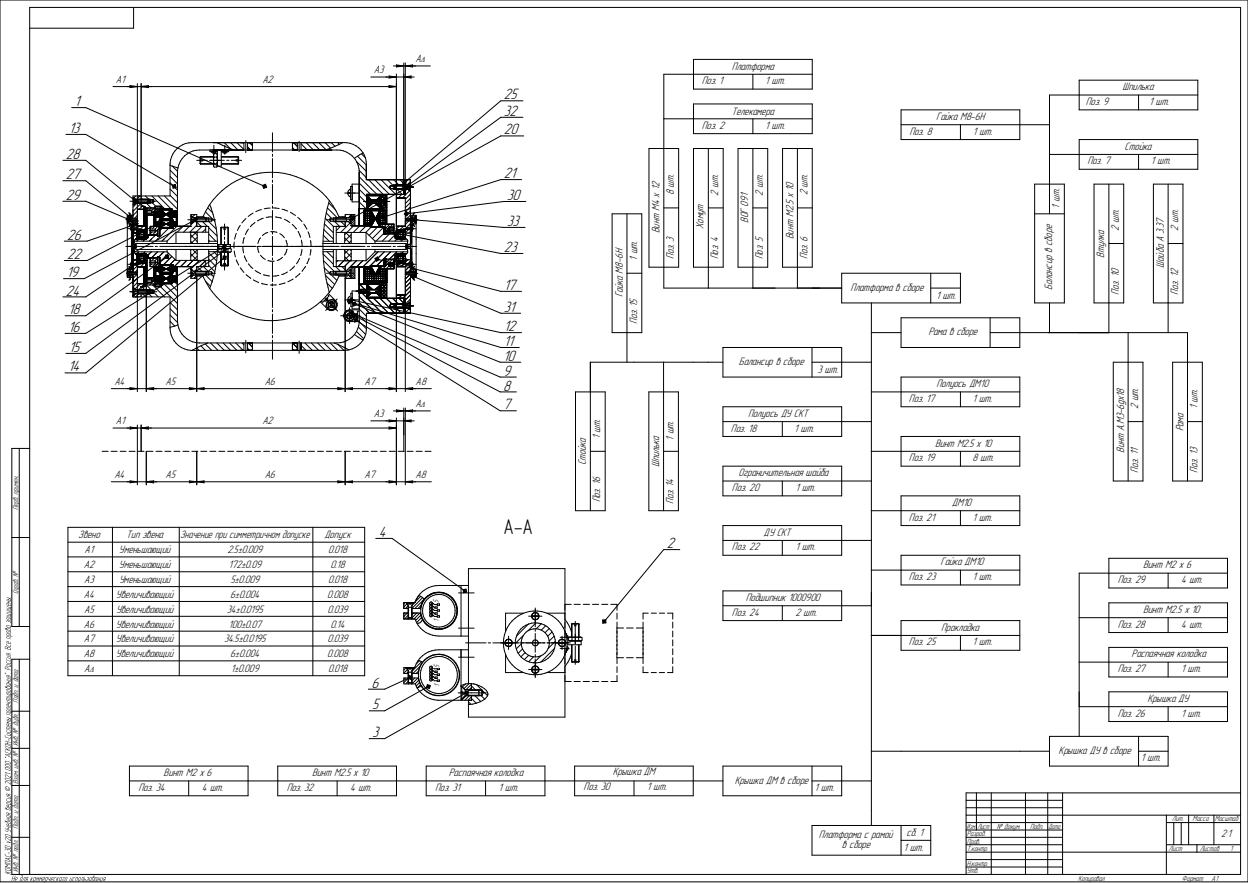
[picture p65: page 1]
Платформа в сборе; Балансир в сборе; Рама в сборе; Крышка ДУ в сборе Втулка Поз. 10 2 шт.; Шайба A ³.37 Поз. 12 2 шт. Винт А.М³⁻⁶gx¹8 Поз. 11 2 шт. Балансир в сборе; Стойка; Поз. 7; Шпилька; Поз. 9; Гайка М8-6H; Поз. 8; Поз. 17; Полуось ДМ10; Поз. 18; Поз. 20; Ограничительная шайба; Поз. 22; ДУ СКТ; Поз. 21; Поз. 19; Винт М2.5 x 10; Крышка ДМ в сборе Поз. 32; Поз. 31; Распаячная колодка; Поз. 30; Крышка ДМ; Поз. 28; Поз. 27; Поз. 26; Крышка ДУ; Платформа с рамой; в сборе; Рама Поз. 13 ¹ шт.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

1 шт. Шпилька Поз. 14 ¹ шт.

Полуось ДУ СКТ

1 Инв. № подл. Подп. и дата Взам. инв. № Инв. № дубл. Подп. и дата Справ. № Перв. примен.

Изм. Лист № докум. Подп. Дата
Разраб.
Пров.
Н.контр.
Утв.
