litvinoval/cursach/чертежи сем2/на печать/устойчивость.pdf

Внутренняя ось | Наружная ось

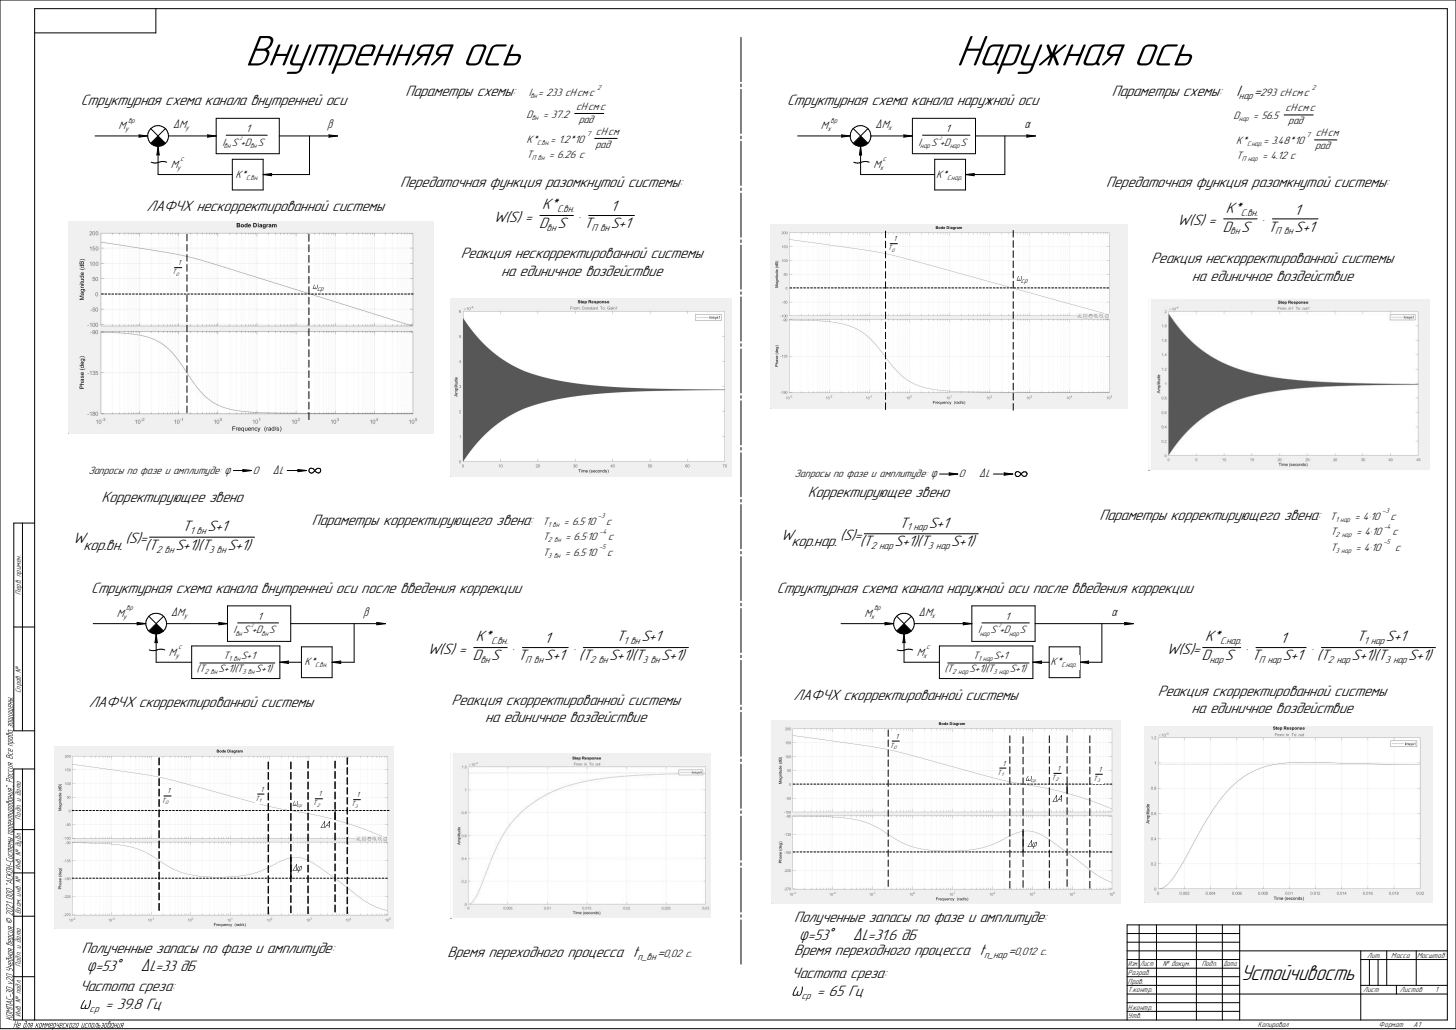
[picture p66: page 1]
Структурная схема канала внутренней оси; Параметры схемы: Iвн= 233 cНсмс²; сНсмс рад; рад; К*С.вн. DвнS; 1 ТП внS+1; Запросы по фазе и амплитуде:; Корректирующее звено; Wкор.вн.(S)=; Т1 внS+1 (Т2 внS+1)(Т3 внS+1); с Т2 вн = 6.510⁻⁴ с Т3 вн = 6.510⁻⁵ с Т1 внS+1; (Т2 внS+1)(Т3 внS+1); ТП внS+1; Т1 внS+1; ЛАФЧХ скорректированной системы; Реакция скорректированной системы; Структурная схема канала наружной оси; Параметры схемы: Iнар; Dнар; К*С.нар.= 3.48*10; 7 сНсм рад; ТП нар; К*С.нар.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

Dвн = 37.2

Передаточная функция разомкнутой системы:

ЛАФЧХ нескорректированной системы

Реакция нескорректированной системы
на единичное воздействие

Параметры корректирующего звена: Т1 вн = 6.510⁻³

Параметры корректирующего звена: Т1 нар

Структурная схема канала внутренней оси после введения коррекции

Структурная схема канала наружной оси после введения коррекции

Полученные запасы по фазе и амплитуде:
Время переходного процесса tп_нар=0,012 с.
Частота среза:

Время переходного процесса tп_вн=0,02 с.

Пров.
Т.контр. | Лист | Листов
